metebalci/muir-fpga/README.md

# muir-fpga

This is the MIT CADR on an FPGA, at **rtl level**. Its processor's microcycles
and the machine's clocks run at the original machine's speed to within about
5%.

[muir-sim](https://github.com/metebalci/muir-sim) simulates the CADR at three
fidelities. `rtl` is the middle one. It has the machine's own two-phase clock,
every datapath signal on it, and everything that is a matter of *when*. That
means bus waits and hangs, arbitration, and timeouts. This repository is that
machine in fabric, with a normal microcycle of 15 clock ticks.

**That speed is a statement about parts, not about the whole machine.** A
normal microcycle takes 150 nanoseconds where MIT's drawings say 145, and every
microcycle is within 4% of the drawings. The microsecond clock and the display
frame keep MIT's exact periods. Main memory is DDR3, which answers in its own
time rather than on the memory board's clock. The disk carries the Trident
T-300's timing and does not charge it on the board, so a disk operation ends
when its words have moved. No whole program has been timed against a real CADR.

The table sets the original machine's figures beside this machine's on the Arty
Z7-20. A figure for the original that no source gives is marked as not in the
recovered material. Each figure for this machine says whether it was measured
on the board or is what the fabric is built to do.

| | The CADR | This machine, on the Arty Z7-20 |
|---|---|---|
| Microcycle, fast speed | 135 ns [1] | 140 ns, by design [11] |
| Microcycle, normal speed | 145 ns [1] | 150 ns, by design [11] |
| Microcycle, slow speed | 160 ns [1] | 160 ns, by design [11] |
| Microcycle, extra slow speed | 220 ns [1] | 220 ns, by design [11] |
| Microcycles a real second, stalls included | not in the recovered material | 5.876 million, measured, 88.1% of what a normal microcycle allows [12] |
| Microsecond clock | 1,000 ns, from a 32 MHz crystal [2] | 100 ticks; measured at 0.99995 and 1.00001 of real time [12] |
| Display frame | 15,456,000 ns, 64.7 Hz, from the PROM's sync program [3]; 16,528,000 ns, 60.5 Hz, from `CPT-SYNC2`, which every boot loads | the same periods from the same sync programs, by design [11]; 60.503 Hz measured with a band running (`docs/tv.md`) |
| Xbus setup before `-XBUS.RQ` | 80 ns [4] | 80 ns, by design [11] |
| Read deskew | 60 ns [4] | 60 ns, by design [11] |
| Main memory, `-XBUS.RQ` to the acknowledgment | about 460 to 500 ns on the memory board's 24 MHz clock, longer during a refresh [5] | the DDR3 round trip through the processing system's `S_AXI_HP0`; not measured on the board. In simulation the checks answer at muir's memory board instant [13] |
| Disk rotation | 3,600 rpm, 16.7 ms; average latency 8.3 ms [6] | 16,666,667 ns in the model; not charged on the board [14] |
| Disk sector | 1,164 bytes [7], 963 us at the transfer rate below | 968,448 ns in the model, at 104 ns a bit; not charged on the board [14] |
| Disk seek | 6 ms to the next cylinder, 30 ms on average, 55 ms at most [6] | 5,939,729 ns plus 60,271 ns a cylinder in the model: 6 ms, about 22 ms on average, 55 ms at most; not charged on the board [14] |
| Disk transfer | 1,209 KByte/s [6] | a block moves once Linux has read it from the pack file; a cold load measured about 64,500 blocks in about 58 s, about the same as at half speed [12] |
| Disk hang timer | 2.56 s [8] | 2.56 s, by design [14] |
| Chaosnet cable | 4 MHz [9] | no cable: a frame crosses to Linux whole and travels as a UDP datagram over gigabit Ethernet; not measured [15] |
| Serial line | 50 to 19,200 baud, from a 5.0688 MHz crystal [10] | the same rates in real time, by design; 300 baud measured whole at 30.0 characters a second, and 9600 baud whole with a store of 1,024 characters [16] |

Sources for the CADR:

1. muir `src/clock.rs`, `Speed`: the 74S151 at CLOCK1 1D08 selects the read
   tap, and a microcycle is that tap plus 60 ns of restart
   (`mit/cadr/clock1.drw`).
2. muir `src/chip.rs`, `CHAOS_CRYSTAL_PERIOD`, and `src/ioboard.rs`,
   `FIRST_USEC_EDGE_NS`: `1 USEC CLK` is counted down from the 32 MHz crystal
   at LMTCLK 0A05 (`mit/chaos/lispm/lmtclk.drw`, `mit/cadrio/clktim.drw`).
3. muir `src/tv.rs`, `FRAME_NS`: 966 lines of 16.000 us in clock mode 0, from
   MIT's sync program `mit/cadrtv/cpt.prom`, measured on muir's netlist of the
   SIMPLE TV.
4. `mit/cadr1/xspec.text.3`, the Xbus specification: "80 ns. prior to
   asserting -XBUS.RQ". muir `src/busint.rs`, `XBUS_ACK_NS`: the 60 ns tap of
   the TD100 at REQLM 0C09.
5. muir `src/busint.rs`, `MemoryBoard` and `MEMORY_CYCLE_STAGES`, and
   `tests/cadrm_netlist.rs`: a request is taken at the first edge of the
   board's 24 MHz crystal after `-XBUS.RQ` and acknowledged eleven stages of
   41.7 ns later. A refresh cycle about every 12 us, MIT's note on
   `mit/cadrm/memctl.drw`, holds the board for about 455 ns. These figures
   come from muir's netlist of MIT's memory board, whose crystal ECO 1 in
   `mit/cadrm/mem.eco` added, and not from hardware.
6. CalComp/Century Data 76205-902, *Performance Specification, Models T-25,
   T-50, T-80, T-200 and T-300*, November 1980, Table 2-1, as quoted in muir
   `src/disk_unit.rs` at `REVOLUTION_NS`, `BIT_NS` and `Trident`.
7. `mit/cadrdc/dctrid.drw`: "Set sector length jumpers in drive to 1410
   (octal) which is 1164. bytes". System 100 `sys/doc/disk.text`: "one every
   1164. bytes".
8. muir `src/disk_controller.rs`, `TIMEOUT_NS`: the 74LS124 at DCTMOT 0B04 at
   20 ms, divided by 128 by the 74393 at DCTMOT 0C03. System 100
   `sys/doc/disk.text`: "longer than 2.5 seconds".
9. `mit/cadrio/iob.eco`, ECO #5 of 8/3/80: "Change cable speed to 4 MHz".
10. muir `src/serial.rs`, `DIVISORS` and `BRCLK_HZ`: Table 1 of the Signetics
    2651 data sheet, for the crystal at IOBSER 0A15.

Sources for this machine:

11. `docs/timing.md`, which gives every instant in ticks and its source.
12. `docs/board.md`, "The 10 ns grid on the board, 17 September".
13. `rtl/plumbing/cadr_xbus_ddr.sv`: the bridge adds no ticks of its own, and
    the answer comes when the AXI port returns it. `tb/cadr_machine_tb.cpp`
    answers each memory cycle at muir's acknowledgment instant, which includes
    the memory board's clock.
14. `rtl/machine/cadr_disk_controller.sv`: the drive's time is charged only
    when `cadr-disk-packs` runs with `--timed`. The board's init script does not
    pass it, and muir leaves it off by default too.
15. `rtl/plumbing/cadr_chaos_cable.sv` and `docs/chaosnet.md`.
16. `docs/board.md`, "A placement fault fixed, and the serial store, 17
    September".

**The timing of the clock edges is close to the CADR's but not identical.**
The CADR placed its clock edges with tapped delay lines, at instants its
drawings give in nanoseconds. The FPGA clocks everything from one 10
nanosecond clock, so an edge can only fall on a tick. Each instant goes to the
first tick at or after where the drawings put it. Eleven instants move later,
eight of them by 5 nanoseconds and three by 7, and none moves earlier.

What the machine computes does not change, because every instant keeps its
order. Free-running oscillators keep their exact period, so the microsecond
clock keeps real time and the display's frame is exact. muir's
`--timing-model fpga` applies the same rounding. So the fabric is held tick for
tick to muir under that model, and not to the original hardware's exact
nanoseconds.

The grid was 5 nanoseconds before, which kept every instant exact, but the
clock was 10 nanoseconds then too, so the machine ran at about half speed. The
clock is not 5 nanoseconds because the design does not meet its timing at 5.
`docs/timing.md` lists every instant, where it came from, and what depends on
it.

muir's netlists are read to **derive** things. They give the port list's
directions, the address decode's boundaries, and every constant that came off
a drawing. But nothing here is a netlist. Whether a gate-level implementation
ever follows is an open question. It is not a promise this repository makes.

This is separate from muir because the toolchain is separate. muir stays the
reference, and everything here is checked against it. `muir.commit` names the
commit of muir the traces were generated against, and `make muir-pin` says
whether the muir beside you is that one.

## Where the machine ends and the board begins

The CADR is one machine, and it is the whole point. Everything else is what it
takes to run that machine on a particular part. The source tree draws that line
explicitly, and it draws it where the checks already drew it.

    rtl/machine/            muir is the reference, tick for tick
    rtl/plumbing/           held to a protocol or a property
    rtl/plumbing/xilinx7/   the vendor's primitives and constraint syntax
    boards/arty-z7-20/      pins, the processing system, the operating system

Every file in `rtl/machine/` has a muir type it is compared against, over a
trace, cycle for cycle. Every file in `rtl/plumbing/` says in its own header
that no muir reference exists for it, because it is held to a bus protocol or
to a property instead. The AXI master is the clearest case. Nothing in muir
corresponds to it, so it is held to the protocol and to read-back and to
nothing else.

The vendor-specific pieces are in the plumbing rather than in the machine. The
scan primitive the debug probe uses and the syntax of the two constraint files
are Xilinx's, and keeping them out of `rtl/machine/` is what keeps the promise
that the machine is plain SystemVerilog.

**Another Zynq board is a small thing.** It needs a top level, a pin file, a
processing-system configuration and a device tree. That is one directory under
`boards/`, and nothing in `rtl/` changes.

**A part with no processing system is not a port but a second set of
plumbing.** Another seven-series part carries the machine and even the clock
and scan primitives over unchanged. What does not carry over is everything the
processing system does today: main memory, Linux, and therefore the disk pack
program, the console's path and the display's. Each of those needs a fabric
answer instead. Nearly all of that work lands in `rtl/plumbing/`, where it is
reusable, and the board directory stays thin. The disk controller would ask for
a block exactly as it does now and would not care who answered.

**An Arty A7-100 directory was here and was removed.** It held that board's top
level, its pin file, a generated DDR3L controller, lowRISC's Ibex as a soft
processor in a vendored directory that went with it, and the bare-metal
firmware that drove the same register faces Linux drives on a Zynq board. It was taken out because that board
carries a microSD card only as a module bolted onto a Pmod header, its Ethernet
is 10/100 where the Zynq boards are gigabit, and it has no video connector, so
the screen had nowhere to go. None of that made it worth carrying beside the
Zynq boards. `c789d19` is the last commit that has it, and `boards/README.md`
still lists what a part with no processing system would have to answer, so the
question can be re-opened from there.

The Digilent Cora Z7-07S was supported up to commit `653e5759` and is no longer.

**It is one repository and not one per family, deliberately.** The value here
is the CADR held to muir. Two repositories would mean two copies of the machine
drifting apart, with the checks duplicated and rotting in whichever copy nobody
was looking at.

## The board this runs on today

The board is the Digilent **Arty Z7-20**, `XC7Z020-1CLG400C`. It has 53,200
LUTs, 106,400 flip-flops, 630 KB of block RAM, a dual Cortex-A9 at 650 MHz,
512 MB of PS DDR3, gigabit Ethernet and microSD.

**Fabric holds anything with a clock edge the CADR can see. Linux holds
anything with a protocol, a file, or a name in it.** So the boards, the Xbus,
the Trident bus timing and the Chaosnet cable are in fabric. The RFB server,
the packs on microSD, Chaosnet routing and the console are on the processing
system. Main memory is the only seam that runs at machine speed, and it is the
one with no software in it.

Five of the Zynq's nine ports cross the boundary today. The fifth is the
display's own output.

`S_AXI_HP0` is the memory bridge's, and it is the one at machine speed.

`S_AXI_HP2` is the disk's. A Trident turns 60 times a second with 17 blocks to
the track, which is 1,020 blocks a second of 256 words each. A streaming pack
is therefore 261,120 words a second, just over a megabyte. Bandwidth was never
the point. The point is that on a port the processing system masters, those are
261,120 stalled CPU stores a second, against a 968 us deadline for each block.
So fabric fetches the block out of DDR itself, at the block's address Linux
writes, and no CPU is in the per-word path. The disk gets a port of its own
rather than a share of `HP0`, so that disk traffic adds no arbitration to the
memory path. It is the third port rather than the second because `HP0` and
`HP1` share one port on the DDR controller, and `HP2` and `HP3` share the
other. A disk on `HP1` would have met the machine at that shared port, which is
the thing a separate port was for.

`M_AXI_GP0` carries the disk's registers, the Chaosnet buffers and the block's
address, behind `rtl/plumbing/cadr_gp0_split.sv`. `M_AXI_GP1` carries the
console and the debug cable's carrier, behind `rtl/plumbing/cadr_gp1_split.sv`.
The console keeps `0x8000_0000` and the cable's sixteen words sit at
`0x8000_1000`, which is the address muir is given as
`--debug-cable-connect 0x80001000`.

Each splitter has a port for everything neither face claims, and that is the
rule the arrangement exists for. A read on a general-purpose port that nothing
in the fabric answers does not fault the Arm. It hangs both cores at one
program counter each, and no software guard can catch it. So the fabric that
owns a port answers every address on it, and each splitter's check reads all
262,144 pages of its port back.

The Zynq-7000's PS-PL ports are **AXI3** and the logic here is AXI4, but no
protocol converter is needed. The `PS7` primitive takes `AWLEN[3:0]`,
`AWSIZE[1:0]`, `AxLOCK[1:0]`, six-bit IDs and a `WID`, so a single-beat AXI4
master reaches it through a handful of wires.

## The processor's boundary

`data/cables.txt` in muir holds the 92 wires on the five flat cables between
the processor and the bus interface, pin for pin off MIT's wire lists. That is
the machine's own boundary, so it is the module's ports.

The cables are named by both ends, because the processor end alone is
ambiguous. `1AJ1` is the CADR board's connector **and** the ICMEM board's. The
five are `1AJ1-J11` (20 wires), `1AJ1-J08` (12, the ICMEM board's), `1BJ1-J12`
(20), `1CJ1-J09` (20) and `3AJ1-J07` (20).

Of the 92, 15 are inputs and 29 are outputs. The other 48 are exactly
`MEM<31:0>` and `SPY<15:0>`, and they are driven from both ends. Fabric has no
bus to fight over, so those are carried as a value and an enable out, with the
resolved wire back in.

Net names are mangled to legal identifiers. A leading `-` becomes `n_`. A `.`,
a space, a `/` and a `>` each become `_`. A leading digit takes an `x`. A
collision is an error. `rtl/machine/cadr_cables.map` holds every identifier
against the name MIT wrote.

## The debug cable

> ## ⚠ DO NOT JOIN THE TWO BOARDS' POWER
>
> **A straight ribbon between two headers joins their supplies as well as
> their signals, and two boards' regulators tied together is not something
> either of them is built for. It can damage both.**
>
> **The grounds must be joined. The supplies must never be.** On a Pmod
> header that means leaving pins 6 and 12 open at *both* ends, joining only
> the grounds on pins 5 and 11. On the DE25-Nano's JP1 it means leaving pin
> 11, which is 5 V, and pin 29, which is 3.3 V, open at both ends, and
> joining only the ground on pin 30.
>
> A manufactured ribbon does not do this for you. Check the cable against the
> header's own pin list before either board is powered, and check both ends:
> a cable that is right at one end and wrong at the other is still wrong.
> `docs/debug-cable.md` gives the full pin list for each board.

This is the other cable in the machine, and the one that makes two of them. A
CADR debugs a CADR. The debugger's `DBGOUT` connector goes to the debuggee's
`DBGIN`, over the 21 wires of `data/busint-connectors.txt`. Through them the
debugger reaches four registers on the debuggee's Unibus: `766100` cycle,
`766104` status, `766110` modifier and `766114` address. Those are the strobes
the 74S139 at DBGIN 0A15 makes of `DEBUG IN A<1:0>`.

Four wires go out (`-DEBUG OUT REQ`, `DEBUG OUT A<1:0>`, `DEBUG OUT WR`) and
one comes back (`DEBUG IN ACK`). `DBD<15:0>` goes both ways. It is one bus on
each board with both connectors on it, and its direction follows `WR`. So 21
wires are 20 signals out and 19 back. They are carried the way the processor
cables carry their 48 both-ends wires, as a value and an enable out with the
resolved wire back in. The two octal Am8304s at DBGOUT 0B21 and 0B22 drive
`DBD` together. They share one enable and one direction, `-DBD ENB` on pin 9
and `-DEBUG > UD` on pin 11, so there is one enable for the whole bus rather
than one a byte.

What crosses is levels rather than pulses. The wires are held for the whole
request, as the debugger's own Unibus cycle holds them. Two figures constrain
anything that carries them. The data, the address bits and the write flag are
on the cable **100 ns before** the request, because the request is `NAND(SELECT
DEBUG, SELECT DEBUG DLYD)` at DBGOUT 0A11. So a carrier must sample every wire
at one instant and replay it at one instant, or that ordering inverts. And the
debug block's timeout is **11.05 us**, thirteen intervals of the 74LS124 at
REQTIM 0A01 off the REQTIM PROM's second table, rather than the Xbus's 4.25 us.

That budget is microseconds, so a carrier's delay need only be constant rather
than small.

**The debugger is muir, on the processing system.** It holds the cable's levels
as registers. It drives `DBGIN` as machine A's `DBGOUT` page would, or as the
PDP-11 once did, with the phase generator held at a microcycle boundary while
muir computes its side. Machine-time stays exact and only wall-clock stretches.
muir already runs the lashup, so the debugger is software that works before the
fabric it is pointed at does.

Both ends are built. `rtl/machine/cadr_dbgin.sv` is MIT's DBGIN page inside
`cadr_machine`, and `rtl/plumbing/cadr_debug_window.sv` is the carrier that
puts the twenty-one wires on `M_AXI_GP1` as sixteen words. muir reaches them
with ordinary loads and stores through `/dev/mem`. `docs/debug-cable.md` is
the whole of it.

A second board is the same cable on one Pmod connector, JA on both boards.
The connector carries the whole link in both directions: four pins each way, of
which two carry a strobe and one data line and the other two are driven low as
guards beside them, twenty-four beats a frame. A board is a debugger or a
debuggee by configuration and never both at once, which is what makes one
connector enough; a second one bought only a chain of three machines. The other
Pmod is not assigned. The cable's 11.05 us budget makes the beats free.

Both Zynq boards carry the connector, in every configuration, because a board
is always a debuggee. A board becomes the debugger by `--debug-cable-connect`
in `fpgarc` or by `cadr-console debug-cable-connect`. Two boards joined by the
cable have each debugged the other over it: CC in one board's Lisp world has halted the machine in the other and read its registers
and scratchpads, equal to that board's own console and readout.

**The console is not this, and the difference is worth keeping.** It masters
the machine's own Unibus to reach the diagnostic registers. No CADR had that
path, where the debugger was another machine's `DBGOUT` page or a PDP-11
playing it. So the console exercises nothing of the machine, and that is
exactly its use. It works when the debug block does not, which is when it is
wanted. muir through the real debug block does test that block. **A check may
reach the machine through the debug cable and never through the console.**
Otherwise it would be holding the fabric to a path the hardware never had.

## Memory in DDR

Memory is shared with the Linux side. It is settled in
`rtl/plumbing/cadr_ddr_map.sv` and **reserved at what the machine can reach,
and no more**: 17.125 MB of a Zynq board's 512 MB, and Linux keeps the rest.

| base | reserved | used | |
|---|---|---|---|
| `0x1B00_0000` | 16 MB, 4M words | 15 MB, 3,932,160 words | main memory |
| `0x1C00_0000` | 1 MB | 128 KB, 32,768 words | display |
| `0x1C02_0000` | in the 1 MB above | 128 KB, 32,768 words | second display |
| `0x1C10_0000` | 128 KB | 128 KB | the disk pack program's records |

The other boards have the same layout at their own base: `0xB300_0000` on the
DE25-Nano and `0x6300_0000` on the Kria KR260.

QUUX has its own device trees and loader, and its own region:
main memory as 32M words of packed storage from `0x1200_0000`, then the display
and the records, ending where the CADR's region ends. Linux keeps 350.9 MB
beside it (`docs/linux.md`).

DDR was never the limit. The CADR's physical address is 22 bits, a 14-bit page
frame out of the map with `VMA<7:0>` as the offset, so main memory's 16 MB
holds every address the machine can make, and 3,932,160 words is the
ceiling. The top four of the 64 slots are taken by the display, the disk
controller and the Unibus.

The display's 1 MB holds both display boards' frame buffers: the first at its
base and the second, the color TV's, 128 KB above it, which is the first
board's own size. A machine carries the second board only when the card asks
for it. The CADR's own screen is 768 x 963 at one bit and the color TV's
576 x 454 at four bits a pixel --- four is the only depth that board has
here, a pixel being an address into sixteen colors of three eight-bit
channels. The Linux side serves a 1080p canvas over RFB and composites the
machine's screen into it.

## Building

This needs [Verilator](https://verilator.org), a Rust toolchain, and muir
checked out beside this repository. Nothing here vendors a copy of muir's
netlists or part tables.

    make check

### Vivado on Ubuntu 26.04

Vivado 2026.1 does not list Ubuntu 26.04 as a supported operating system. It
runs here anyway, and this section says what that takes. It should go away
when the release notes catch up.

The problem is the prerequisite libraries rather than the tool, and it comes
in two halves. Some package names have changed, and two libraries are gone
from the distribution altogether.

**The names first.** AMD ships a script named `installLibs.sh` beside the
installer, and its Ubuntu branch asks for `libtinfo5`, `libncurses5`,
`libncurses5-dev`, `libgdk-pixbuf2.0-dev` and `libasound2`. The same list with
the current names works:

    sudo apt-get install libc6-dev-i386 net-tools graphviz make unzip \
        zip g++ libtinfo6 xvfb git libtool libyaml-dev libncurses6 \
        libncurses-dev libnss3-dev libgdk-pixbuf2.0-bin libgtk-3-dev \
        libxss-dev libasound2-dev openssl fdisk libsecret-1-dev

**The script cannot tell you any of this.** Each library is a separate
`apt-get` command piped into `tee`, and the script sets no error handling, so
a package that does not exist prints a message and the run carries on. It
reaches the end and reports success with the libraries missing.

**The second half is the one that needs a workaround.** Vivado loads
`libncurses.so.5` and `libtinfo.so.5` at run time, and 26.04 ships neither and
offers no compatibility package for them. Installing the version 6 packages is
not enough, because the tool asks for the old file names. Without them Vivado
does not start, and the message names the file:

    application-specific initialization failed: couldn't load file
    "libxv_commontasks.so": libncurses.so.5: cannot open shared object file

The fix is a directory of symlinks under the old names, pointing at the
installed version 6 libraries, placed on the library search path:

    mkdir -p ~/lib5
    cd /usr/lib/x86_64-linux-gnu
    ln -s $PWD/libncurses.so.6  ~/lib5/libncurses.so.5
    ln -s $PWD/libncursesw.so.6 ~/lib5/libncursesw.so.5
    ln -s $PWD/libtinfo.so.6    ~/lib5/libtinfo.so.5

Then add `~/lib5` to `LD_LIBRARY_PATH` in your shell's start-up file, after
sourcing Vivado's own `settings64.sh`. Guard the addition so that re-sourcing
the file does not lengthen the path. Undoing all of it is deleting the
directory and the two lines.

Nothing about the tool is patched and it is not told a different operating
system is underneath it. The libraries are the real ones under their previous
names, in one directory outside any system path, visible only to shells that
opt in.

The installer's graphical mode also wants `x11-apps`. The JTAG cable needs the
udev rules copied out of the install, which `docs/board.md` covers, and
without them the hardware server connects and offers no targets.

Synthesis, place and route, and bitstream generation all run on this, and the
most recent build of this repository's own design finished with no critical
warnings.

`docs/fits.md` gives each board's fits: their setup and hold slack, the logic
and block memory they take, and the commit each was built from.

## Layout

    rtl/machine/           the CADR, held to muir tick for tick
    rtl/plumbing/          held to a protocol or a property; no muir reference
    rtl/plumbing/xilinx7/  family primitives and constraints, not the machine
    boards/arty-z7-20/     pins, the processing system, the operating system
    tb/                    Verilator testbenches
    golden/                Rust, depends on muir by path; writes the traces
    mutations/             the mutation list, and the runner that applies it;
                           docs/mutations.md says what it is and why
    docs/                  one document a block, and the board bring-up
    build/                 generated, not committed

## How it was written

This project is written with [Claude Code](https://claude.com/claude-code),
using Anthropic's Claude Opus, Claude Fable and Claude Sonnet.
