metebalci/muir-fpga/docs/chaosnet.md

<!--
SPDX-FileCopyrightText: 2026 Mete Balci
SPDX-License-Identifier: AGPL-3.0-or-later
-->

# The Chaosnet, and the serial line beside it

Both are on the CADR's I/O board, and both are split between fabric and Linux.
This document covers the whole of each, because the two halves were built by
separate slices and neither is a thing on its own.

The fabric half is in `rtl/machine/cadr_io_board.sv`, held to muir's `ioboard`
model over a scripted trace. The Linux half is two Buildroot packages,
`cadr-chaosnet` and `cadr-serial`, ported from muir's `src/chaos/` and
`src/serial.rs`.

## Where the line between them falls

**Fabric holds anything with a clock edge the CADR can see. Linux holds
anything with a protocol, a file, or a name in it.** That is this project's
rule and it decides everything here.

So the fabric has the registers the machine reads and writes: the Chaosnet
interface's five registers from AIM-628 section 7, its two packet buffers of
256 words each, its two 9401s, the one at LMTBUF 0C09 that makes the check
word and the one at LMRBUF 0C07 that checks the read-out, its bit counter and
its lost count, and the serial port's four 2651 registers with their mode
pointer and status byte. Nothing above that is in fabric.

Linux has the rest: the cable, the receiver's verdict on a frame, routing,
the turn timer, the baud-rate generator and the line. What crosses the
boundary is a frame and a status register, and nothing more.

**Nothing on either side of that boundary answers a service.** A CADR has no
file or time server in it. The section on `ED-FILE` below says where that
server is instead.

## What the machine sees

`0o764140` to `0o764156` is the Chaosnet interface and `0o764160` to
`0o764176` is the serial port. Both are answered in full. The card's own check
prints `NOTHING IS EXEMPT`, and it answers 55 directions where it answered 28
before these two landed.

The Chaosnet's decode is subtle and the subtlety is MIT's. The 74LS138 at
LMUCON 0C18 decodes two address bits **and read against write**, so one
address is a different register depending on direction. Address bit 3 is
decoded only twice: it makes a read of `0o764152` the address START rather
than MY ADDRESS, and it disables the receive buffer's read at `0o764154`,
which is then unanswered. Writes reach the CSR and the transmit buffer at
`0o764150` and `0o764152` exactly as at `0o764140` and `0o764142`.

The serial port is simpler. Address bit 3 is not decoded at all, so
`0o764170` to `0o764176` are aliases of `0o764160` to `0o764166`, and every
address of the group is answered in both directions.

The interrupt vectors are `0o274` for the clock, `0o270` for the Chaosnet,
`0o264` for the serial port and the keyboard and mouse last. MIT's priority is
clock over Chaosnet over serial over keyboard. `0o270` is compared against
muir for the first time now, because the trace plugs a Chaosnet interface in
and uses Loop Back as the far end, which no trace against this model could do
before.

## QUUX

QUUX has no I/O board and no Chaosnet interface (QUUX's Ethernet contract,
section 8 R4). Its network is the Ethernet device (`docs/ethernet-device.md`).
The register page's words 140 to 157 are reserved and are never reused: each
reads 0 and takes no write, as the page's other reserved words do. Word 100's
bit 6 is never set, and the core has no Chaosnet cable seam. `quux15_network`
holds it clock for clock against muir: every word of 140 to 157 is read, then
written as an interface would act on them with interrupts enabled, and
condition 5 never calls its handler.

## An empty START takes Transmit Done down

A read of START with no word written since the last frame or a Reset still
sends a frame, the source and its check word. On MIT's board the read raises
TRESET (the 74S00s at LMTBFC 0C15, while TDONE is up), which clears TDONE (the
74S74 at LMMODU 0D08). So Transmit Done falls at the read and rises 500 ns
before the empty frame's nominal end, as every frame's does. muir does the
same, held to the netlist board. The CADR's card takes Transmit Done down at
START, and the far end's `chaos_tx_done` raises it again. After a word was written, Transmit Done is already down and
the read changes nothing. MIT's microcode and Lisp write at least one word
before every START, so no system run sees the difference.

**On a board the far end does not send the empty frame, and this is a known
difference.** `cadr_chaos_cable.sv` answers a frame of three words or fewer,
the empty frame's source and check word among them, by giving
`chaos_tx_done` back the next clock, and nothing goes on the cable. No
receiver lands a run of 48 bits or fewer (below), and CHUDP has no datagram
for a frame of fewer than eleven words. Nor does the board's own busy receiver
count or abort such a run: its own frame of 48 bits into a full buffer, to its
own address, to zero or under Spy, leaves Lost Count and Transmit Abort where
they were, on the netlist board and in muir alike. For one and two words the
rule also keeps `cadr-chaosnet` from reading below a frame: it routes by the
third word from the end, and the card makes frames of one and two words from
255 and 256 words written. The program drops such a frame itself as well, if
one is ever offered. muir and MIT's board send the
33-cell frame and raise Transmit Done about 8 µs later. MIT's software never
reads START with nothing written.

## The shift register holds the transmit buffer's writes

Every word written into the outgoing buffer, and at START the source and check
words, reaches the buffer through the transmitter's shift register. On MIT's
board the register loads at the first edge of the board's 8 MHz `FCLK` at
least 101 ns after the cycle's answer, and shifts one word in over 2,000 ns. A
WRITE BUFFER or a START that comes while it is busy waits on `-TSR.SSYN`, and
is answered 350 ns after `TSREMPTY` rises rather than 350 ns after `-MSYN`.
muir measures this on the netlist board and models it
(`IoBoardTiming::answer_cycle`), and the CADR's card does the same. MIT's
microcode writes the second half of every 32-bit word, and START, sooner than
the register takes them, so on a board each of those cycles is held.

Only the card's own Unibus cycles load the register and wait on it. Revisions
13 and 14 reach the interface through QUUX's register page, which is no
Unibus cycle, and muir holds nothing there either. A Reset, a Clear
Transmitter and `-UB INIT` leave the register as it stands, as muir's model
does. Whether they empty it on the board is not measured.

`iob` holds the hold. Its program answers a word at each of the 25 grid
phases of two periods of `FCLK`, with a second word right behind it, so that
the second word's answer names the edge the register loaded on. It sweeps a
word across the instant the register empties, and puts a START behind a word
and a word behind a START. With the earlier sections, 370 of the program's
answers are held, and 338 of them fall 5 ns short of a tick, because
`TSREMPTY` is an `FCLK` edge and every second edge is off the 10 ns grid.

On the CADR, the same register also says when a
frame is ready for its turn: at `TSREMPTY` after START, 4,101 to 4,225 ns
after the answer by the clock's phase, where muir used a fixed 4,150 ns. The
turn timer is the far end's, and the fabric keeps no such instant: Transmit
Done rises at the far end's `chaos_tx_done`, which the checks play from
muir's instants (the `iob` trace's `CTD` rows, and the `# chaos-txdone` lines
of the machine traces on the CADR). So no check of the fabric can tell this rule from the fixed delay, and none is meant to. On a
board Transmit Done comes back when `cadr-chaosnet` takes the frame off
`cadr_chaos_cable.sv`, on no turn timer.

## The interface takes its own frame when it is for it

MIT's board takes its own frame off the cable when it is for it. Its
transceiver hears the whole cable, its own transmission included, and its
receiver judges that frame by `DEST MATCH` as it judges any other. A frame to
the board's own address, to zero, or to anyone under Spy lands in a free
buffer. With the buffer full the frame is counted in Lost Count, and one to
the board's own address is aborted by the board's own busy receiver and reads
back as Transmit Abort. muir measures the cases on the netlist board and does
the same, on every revision.

In the fabric that is the cable's, and the cable is the far end. The CADR's
card takes its own frame through the seam as it takes any other: its words on `chaos_rx_*`, the count on
`chaos_rx_lost`, and the abort on `chaos_tx_done` with `chaos_tx_abort`. A
frame looped back into a full buffer is aborted as its destination word goes
by, 125 ns before Transmit Done (muir's `busy_looped`), so the far end can
also give the abort with the count, ahead of the done. Frames of any length are started, the next section says what becomes of
one written past the buffer's end.
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
