metebalci/muir-fpga/docs/ethernet-device.md

<!--
SPDX-FileCopyrightText: 2026 Mete Balci
SPDX-License-Identifier: AGPL-3.0-or-later
-->
# QUUX's Ethernet device

QUUX revision 16 adds an Ethernet device to the register page, at words 240
to 257, with its interrupt at word 100 `<8>` and its feature bit at word 15
`<2>`. QUUX moves Ethernet frames through two rings in its main memory: a
transmit ring of frames to send, and a receive ring of buffers to fill. The
device understands IPv4. It fills in the IPv4 header checksum and the TCP, UDP
and ICMP checksums of every frame it sends, checks them on every frame it
receives, and takes only IPv4 and ARP. muir's `src/ethernet_device.rs` and
`src/ethernet_offload.rs` define the machine's side: what each register reads,
what each write does, the rings, and what is done to a frame's bytes.

On a board the registers are in the fabric, and the device's other half is a
Linux program, `quux-ethernet-device`. It sends each frame the transmit ring
names to a tap on the board's Linux, `quux0`, and delivers each frame the tap
gives into the receive ring. This page describes the program and the fabric's
page it reaches.

The device is QUUX revision 16's alone. A CADR bitstream and older QUUX
revisions have no page for it, and the default slave answers its address.

## What QUUX reaches on a board

QUUX's address decides what `quux0` is, by one rule:

- **An address in 169.254.x.y makes a host-only tap.** The board's side
  has the address `--ip-gateway` names, on `--ip-address`'s subnet. Nothing is
  forwarded and no ARP is answered for QUUX on the board's network, so QUUX
  reaches the board's Linux alone and nothing on the network reaches QUUX.
  muir's defaults are link-local, so a card that names no address is
  host-only.
- **Any other address makes a LAN tap.** QUUX is then a computer on the
  board's LAN, with its own address on the LAN's subnet and the LAN's router
  as its gateway. The board's Linux answers ARP on its LAN interface for
  QUUX's address and no other, and forwards between the LAN interface and
  `quux0`.
- **A card that mixes the two is refused** before anything is touched: a
  link-local `--ip-address` with a gateway that is not link-local, or the
  reverse. So the board never holds the LAN router's address.

Link-local is the line because a router must not forward a packet with a
link-local source or destination address (RFC 3927, section 2.7). A link-local
QUUX cannot be on the LAN by forwarding, and a QUUX on the LAN is never
link-local. The rule reads QUUX's own flags only and adds no flag.

In either mode QUUX's MAC address stays on `quux0`: on a LAN tap the board
answers ARP on the LAN with its own MAC address. The board forwards no
broadcast from the LAN to QUUX.
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
