metebalci/muir-fpga/tb/cadr_machine_tb.cpp

// SPDX-FileCopyrightText: 2026 Mete Balci
// SPDX-License-Identifier: AGPL-3.0-or-later
//
// Drives rtl/machine/cadr_machine.sv --- the processor and the memory path joined by
// the cables --- from muir's own trace, and compares every microcycle.  The trace is written by golden/src/rtl.rs out of muir's `rtl`
// engine running MIT's boot PROM: a real program, not a scripted stimulus.
//
// One row is one microcycle.  The DUT runs on its own 200 MHz clock and says
// when a microcycle ended, on `clock_edge`; the values compared are the ones
// standing *before* that edge, which is the read phase the row describes ---
// `Rtl::signals` is "recorded in the read phase, where the sources drive and
// the ALU result is up but nothing has been written back".
//
// WHAT IS STIMULUS.  There is no map yet, so what comes out of the trace
// rather than out of the DUT is `md` and `vma`, `vmaok` off the map's
// permission bits, the word a SRCMAP puts on MF, the
// dispatch memory's word, and the console's registers.  The bus interface is
// here too, as its far end: this testbench answers -MEMRQ with -MEMGRANT and
// -MEMACK at the instants muir's own interface answered them.
// `rtl/machine/cadr_busint_xbus.sv` is the real thing and has a check of its own.  Every one leaves with
// a later slice.  They are counted and printed, so what this check is still
// being told rather than checking is on its own output.
//
// **AND ONE OF THEM HAS LEFT.**  The Xbus devices used to be answered from
// the trace --- 16,951 cycles of this program's 17,466, the disk controller's
// four registers being all it touches --- and `rtl/machine/cadr_disk_controller.sv`
// answers them now, with `device_ack` driven low here and never raised.  So
// `md` on 11,301 of those rows is the fabric's own status word and the trace
// is the reference for it rather than the source of it.  That is what a slice
// landing looks like from this side: a drive line deleted, not commented out.
//
// **AND SO HAS `sintr`.**  -XBUS.INTR is made inside `cadr_machine` now ---
// the disk controller's request ORed with the display's vertical interrupt,
// one gate before the 74S175 at LCC 3E12 --- and comes back out as
// `sintr_o`.  The trace's `sintr` column is `Machine::xbus_interrupt()`, the
// same OR, and it is COMPARED here rather than driven.  Same slice, same
// shape: the line that drove it is deleted.
//
// `mf_map` is the one that is frankly circular: a SRCMAP is reached **once**
// in 600,000 microcycles and its word is taken from the trace's own M column,
// so on that single row M checks nothing.  One row is not a check of a map
// under any amount of cleverness, and the map is a later slice; the count is
// printed so the circularity is visible rather than buried.
//
// WHAT IS CHECKED.  PC, IR, LPC, OPC, ST, the A and M buses, the ALU, R, OB,
// Q, DC, LC, JCOND, and the four sequencing flags NOP, PCS1, PCS0 and
// IWRITED --- plus the length of every microcycle in 200 MHz ticks.  PC goes
// through the fabric's own stack on a POPJ.
//
// **The stall is no longer subtracted.**  VCTL1 decides -WAIT and -HANG for
// itself now, so the whole interval between one microcycle boundary and the
// next is the fabric's own answer: 6,912 waits and 11,404 hangs over the run,
// 2,198,700 ns of held clock, and every one of them has to land where muir
// lands it.  That is the strongest single column in this check.
//
// WHAT THE CHECKED SIGNALS ARE WORTH, measured by mutation rather than
// assumed.  The A bus is the strong one: 96,192 distinct values over the run,
// and it catches a wrong write address, wrong write data, and the ACTL
// pass-around inverted or removed.  RETA's mux, WPC and the stack's push
// pass-around are each caught through PC on the 16,384 POPJs.  Against that:
//
//   - LC is **zero on every one of the 600,000 rows**.  The boot PROM never
//     runs macrocode, so the location counter never moves and its check is
//     vacuous.  Asserted below, so a trace that does move it re-opens this.
//   - The stack's RAM and pointer are **never read**.  Every push here is
//     popped by the very next microcycle, which takes SPCWPASS --- the word
//     standing on the SPC bus --- and not the 82S21s' output.  Moving SPCPTR
//     by two, or never writing the RAM at all, survives this check.
//   - The ALATCH/MLATCH gating is not distinguished: making the latches
//     transparent through the write phase survives, because the one overlap
//     it could show --- a write to the address being read --- is exactly what
//     the pass-around covers.  It is right for synthesis, not for this trace.
//   - The WADR/AADR comparator's top bit is never the one that differs, so a
//     nine-bit compare survives a ten-bit one.
//   - OB's two shift selects are never taken: `OSEL` is only ever 0 (MO) or
//     1 (ALU), so `ALU >> 1` and `ALU << 1` with Q<31> shifted in are built
//     and unexercised.  Replacing `ALU >> 1` with `ALU` survives.
//   - Q is loaded five times and **never shifted**: `QS<1:0>` is 0 on 599,995
//     microcycles and 3 on the other five, so the 74S194s' shift paths and
//     every multiply and divide step with them are unexercised.
//   - AEQM widened from the low 32 slices to all 33 survives, so the
//     open-collector chain's width is not pinned down here either.
//   - Jump condition 5, `PAGE.FAULT OR INTERRUPT`, is never selected, and
//     condition 2 is selected once.
//   - Two of -WAIT's three terms never fire.  `USE.MD AND MBUSY AND
//     -MEMGRANT` --- MIT's "do not hang when this line is high", the gate
//     that keeps a hang from being taken before the grant --- is zero over
//     the run, and so is `LCINC AND NEEDFETCH AND MBUSY.SYNC`.  Dropping
//     either survives.  The first term carries the whole stall path here.
//   - **RDCYC and WRCYC being taken from the wrong instruction survives**,
//     and `src/rtl.rs` says in advance that it would: "taking it from the
//     instruction standing one microcycle later is the trap: that instruction
//     is the page-fault check MIT puts after every store, so MEMWR reads
//     false and every write cycle is performed as a read.  Nothing catches it
//     early --- the only thing the boot PROM writes before the disk is page
//     0, which it fills with the zeros already there."  Measured here from
//     the other side, and it holds.
//
// Against that, the ALU array is genuinely exercised: 21 of its 32
// function-and-mode combinations are reached, the sign-extending ninth slice
// is caught if removed (JCOND goes wrong at microcycle 5,202), the rotate is
// caught if reversed, the mask is caught if its two ends are swapped or if
// MSKL loses IR<9:5>, and swapping one entry of either half of the 74S181
// function table is caught within a few thousand microcycles.
//
// The stall path itself is caught where it is exercised: dropping -WAIT's
// first term, letting -HANG be taken before -WAIT, or clearing MBUSY one tick
// late are each caught at the boot PROM's first stalled microcycle.
//
// And the one-state-early trap on page DSPCTL is caught: the 25S07s take
// IR<41:32> of the DISPATCH *itself*, the word standing before the edge, and
// reading the newly loaded IR there instead is caught at microcycle 525,527.
//
// WHAT THIS PROGRAM DOES NOT EXERCISE, asserted here rather than assumed, so
// that a trace which reaches further re-opens each claim: every DISPATCH in
// it is a DISPWR, so the dispatch memory is written and never read and
// `dr`/`dp`/`dn`/`dpc` do not matter; it never halts; it never sets IR<46>,
// so the statistics counter never counts; it never sets PROMDISABLE, so it
// never runs the microcode it loads; and it runs at extra slow throughout,
// where both taps of the 74S151 are -TPR160 --- so ILONG changes nothing and
// the -NOPA gate on it at FLAG 3E07 is unchecked.  The scripted trace behind
// cadr_phase_gen.sv is what covers the seven taps.
//
// The control store comes up all ones rather than zero, and that is what
// makes the 16,384 words the boot PROM writes worth writing: every one of
// them is zero, so with the RAM coming up zero a write that never happened
// reads back exactly like one that did.  rtl/machine/cadr_microcycle.sv says so at
// the array.

#include <algorithm>
#include <cerrno>
#include <cinttypes>
#include <cstdio>
#include <cstdlib>
#include <cstring>
#include <deque>
#include <map>
#include <unordered_map>
#include <set>
#include <string>
#include <vector>

#include "Vcadr_machine.h"
#include "verilated.h"
#include "cadr_tick.h"

namespace {

// Five nanoseconds, the master clock's period.
constexpr int kTickNs = kGridNs;

// WHERE AN ACKNOWLEDGMENT LANDS, against muir's own column, in the units the
// histogram at the end prints: muir minus the fabric.
//
// **ZERO IS AGREEMENT, AND IT IS READ AT THE EDGE THAT TAKES IT.**  muir
// counts a change that falls exactly on an edge as before the edge, so an
// acknowledgment at instant T is one the registers clocked at T see.  The
// instrument reads -MEMACK with this tick's inputs settled and before this
// tick's edge, which is exactly what that edge takes, whether the
// acknowledgment is a register (the read deskew, the NXM timer), a gate off
// a register (the disk controller, off -XBUS.RQ) or a gate off this
// testbench's own `mem_done` (a write of main memory).  Every cycle of the
// program is held to it.
//
// It used to be read at the top of the tick, before the inputs, and so read
// a testbench-driven write a tick late and every other source on time; a
// constant of one tick, called the instrument's own, was then required of
// the disk controller's cycles and the NXM timer's --- which were in fact a
// tick late, and the whole machine with them.  `RD_FINISH_T`'s note in
// `rtl/machine/cadr_microcycle.sv` has that story.
constexpr int kInstrumentSlipNs = 0;

// WHERE THE NXM TIMER'S ACKNOWLEDGMENT LANDS.  The two cycles this program
// sends to empty Xbus space must both read this.  They move when the bus
// interface's free-running timeout oscillator changes phase, and the only
// thing that changes its phase is the tick reset is released on, which is why
// this is the one witness the boot PROM has to the reset network arriving
// everywhere at once.  Issue #21 was the oscillator two ticks early;
// `cadr_busint_xbus.sv` says why at `POWER_ON_T`.
constexpr int kNxmAckSlipNs = kInstrumentSlipNs;

// "a write is acknowledged at once, a read XBUS_ACK_NS later, which is the
// 60 ns tap of the TD100 at REQLM 0C09 deskewing the word into MD".
constexpr int kXbusAckNs = 60;

// The trace's columns, in the order golden/src/rtl.rs prints them.
enum Col {
  kCycle, kPc, kIr, kQ, kA, kM, kAlu, kR, kOb, kDc, kOpc, kSt, kLc,
  kWmapd, kDestspcd, kIwrited, kImodd, kPdlwrited, kSpushd, kNop, kNVmaok,
  kJcond, kPcs1, kPcs0, kSrun,
  kLpc, kMd, kVma, kPromdis, kErrstop, kStathenb, kSpeed1, kSpeed0,
  kStall, kHalted, kBus, kAck, kGnt, kSintr, kNs,
  kColumns
};

struct Row {
  uint64_t v[kColumns];
};

// One row of hexadecimal columns. Returns false if the count is wrong.
bool ParseRow(const char *line, Row &r) {
  const char *p = line;
  for (int i = 0; i < kColumns; ++i) {
    char *end = nullptr;
    r.v[i] = std::strtoull(p, &end, 16);
    if (end == p) return false;
    p = end;
  }
  return true;
}

// DESTMDR: the instruction stores OB into MD itself, at the edge.
bool RowDestmdr(const Row &r) {
  const uint64_t cls = (r.v[kIr] >> 43) & 3;
  const bool dest = !r.v[kNop] && (cls == 0 || cls == 3);
  return dest && !((r.v[kIr] >> 25) & 1) && ((r.v[kIr] >> 23) & 1) &&
         ((r.v[kIr] >> 22) & 1);
}

int Fail(const Row &r, const char *what, uint64_t got, uint64_t want) {
  std::fprintf(stderr,
               "microcycle %" PRIu64 " (PC %" PRIo64 "): %s is %" PRIx64
               ", reference says %" PRIx64 "\n"
               "  IR %" PRIo64 "  NOP %" PRIu64 "  JCOND %" PRIu64
               "  PCS %" PRIu64 "%" PRIu64 "\n",
               r.v[kCycle], r.v[kPc], what, got, want, r.v[kIr], r.v[kNop],
               r.v[kJcond], r.v[kPcs1], r.v[kPcs0]);
  return 1;
}

}  // namespace

int main(int argc, char **argv) {
  Verilated::commandArgs(argc, argv);

  const char *path = (argc > 1) ? argv[1] : "build/rtl.golden";
  std::FILE *f = std::fopen(path, "r");
  if (!f) {
    std::fprintf(stderr, "cannot read %s: %s\n", path, std::strerror(errno));
    return 2;
  }

  // THE TRACE IS STREAMED, NOT HELD.  The pack trace is 2.2 million
  // microcycles and 297 MB; holding it as parsed rows is 686 MB of a machine
  // three sessions are building on.  So it is read twice instead: once for
  // the acknowledgment times, which are the only thing needing to be known
  // before their row, and once to drive the DUT.
  bool pack_trace = false;
  // **A PROGRAM OF `golden/src/quux.rs` IS NOT THE BOOT PROM.**  Each is a
  // few hundred microcycles written to reach one of QUUX's differences, run
  // on either machine, so the counts below that describe what MIT's boot PROM
  // does --- its 16,951 disk polls, its two NXM cycles, its 512 memory
  // cycles, the disk's `0x2321` in MD --- describe nothing about it and are
  // not asserted.  Every row is compared exactly as on the boot PROM, and the
  // generator itself asserts what the program reached.
  bool script_trace = false;
  // **A PROGRAM OF QUUX'S FUSED RETURN** (`golden/src/fused.rs`): a main
  // loop that dispatches on the halfword and a location counter that
  // walks the code, which every other script leaves alone.  Its dispatches
  // and its counter are compared row for row like the rest, so the two
  // guards below that call them unreached are not asked of it.
  bool dispatch_trace = false;
  // **QUUX'S BOOT PROM TRACE RUNS AS FAR AS MIT'S**, 131,073 microcycles
  // longer for its larger clearing (`golden/src/rtl.rs`), so it carries the
  // memory sizing's NXM cycles, the disk's polls and `0x2321` in MD, and every
  // guard below holds it as it holds MIT's.  This names the run in messages.
  bool quux_prom = false;
  // **A MACHINE BUILT AS QUUX HAS ITS MEMORY PORT** (contract Q6): main
  // memory is not on the Xbus but behind the port's cache, which asks this
  // program for a line of four words on a miss and writes one word through
  // its buffer after the cycle has ended.  So main memory's words are not
  // placed from the trace here: this program IS main memory, a memory that
  // starts as muir's does, all zeros, and holds what the port writes.  A
  // word from the wrong line or a write that never went out reads back
  // wrong, and MD is compared every microcycle.  It answers in one to five
  // ticks, sooner than the nominal 380 and 290 ns, so every acknowledgment
  // is the port's floor and must land on muir's instant.  The video
  // controller's frame buffer is memory too (contract Q7), at the display's
  // base: the port fills its lines and writes it through as it does main
  // memory's, and
  // every write it owes lands here, in order, which is what the scanout
  // reading these words is owed.
  bool quux_machine = false;
  // **REVISION 13'S MAIN MEMORY IS PACKED STORAGE** (contract G1 §4.1, G2
  // §3): this program holds it as bytes, laid out as G1 says and not as the
  // port does, word w in the five bytes from the base the machine was built
  // with (`QUUX13_TB_BASE`, the Makefile's), `<7:0>` first and the tag last;
  // and the window as bytes too, four a word at the display's base, the
  // field alone (G1 §4.2).  Every byte nothing wrote reads as a poison
  // injective in its address, so a fill that asks the wrong bytes, a line
  // not of five beats, or a word packed any other way reads wrong in MD;
  // and every write is checked for where it lands and what it carries
  // against the cycle that owes it.  The programs read no byte they did not
  // write.
  bool rev13 = false;
  // **REVISION 14** (contract G3 revision 14, whose programs are gone with
  // it, so no trace made now sets this): its
  // main memory is revision 13's packed storage, its frame buffer is at the
  // device window's bus address `1 << 28`, and two more things write and
  // fill it besides the processor's own cycles: the walk's reads, which
  // fill lines no cycle of the processor's is at, and the write-backs'
  // table words, which no cycle owes.  Both are served here as main memory
  // and counted; the programs read every table word they assert back through
  // the physical memory window, so a wrong write-back reads wrong in MD.
  bool rev14 = false;
  long side_fills = 0, side_writes = 0;
  // The file device's two bases as muir's device holds them at the end of a
  // revision-13 program (`# fdbases`), for the readout's selector 12.
  bool have_fd_bases = false;
  uint64_t fd_cmd_base_end = 0, fd_resp_base_end = 0;
  // Revision 14's memory system's words and the redirect's copies as muir
  // holds them at the end (`# mswords`, `# pdlcopies`), for the readout's
  // entries 41 to 45 (A14.14).
  bool have_ms = false, have_copies = false;
  uint64_t ms_dir_end = 0, ms_types_end = 0, ms_refused_end = 0, copies_base_end = 0, copies_head_end = 0;
  // **BLOCK-DISK'S PACK AND ITS TRANSFERS ON THE WHOLE MACHINE** (revision
  // 13's `disk` program, gone with revision 13's programs): the pack's blocks
  // (`# disk`), those holding the rule's words (`# pack`), and the pages the
  // transfers reach (`# dma`), which the channel reads and writes through the
  // port beside the processor.  This program is the pack side, as
  // `tb/quux15_block_walk_tb.cpp`'s is, serving the block store on the
  // machine's seam.
  bool have_disk = false;
  uint32_t disk_blocks = 0;
  std::set<uint32_t> disk_preloaded;
  std::vector<uint32_t> dma_pages;
  // Main memory's 64K-word boards: QUUX's 32 unless the trace says.
  unsigned main_boards = 32;
  // Key words for the keyboard's cable, by the microcycle they go in before,
  // and the ones not yet on it: one a tick, from the tick that microcycle
  // starts on.
  std::map<uint64_t, std::vector<uint64_t>> keys;
  std::vector<uint64_t> keys_due;
  size_t keys_sent = 0;
  // **QUUX'S REVISION 9, THE HOST'S SIDE** (`golden/src/quux.rs`): the
  // real-time clock's start, loaded at reset as Linux sets it at boot; the
  // seconds the host sets it to before a microcycle; and the file device's
  // commands as muir's device ran them --- when each was taken, and when each
  // completed, with the words it wrote into main memory --- which this
  // program plays as Linux's server does, through the machine's host side.
  bool have_rtc = false;
  uint64_t rtc_start = 0;
  std::map<uint64_t, uint64_t> rtc_sets;
  struct FdDone {
    uint64_t due, prod, handles;
    std::vector<std::pair<uint32_t, uint64_t>> words;
  };
  std::vector<FdDone> fd_done;
  struct FdTake {
    uint64_t start, index;
    std::vector<std::pair<uint32_t, uint64_t>> entry;
  };
  std::vector<FdTake> fd_takes;
  // **TRANSMIT DONE OFF THE FAR END** (`golden/src/trace.rs`'s
  // `chaos_txdone`): muir's instant in nanoseconds, and the abort.  muir's
  // interface raises Transmit Done at its frame's end on its own; the I/O
  // board's waits for `chaos_tx_done`, which this testbench plays as the
  // cable would.
  std::vector<std::pair<uint64_t, bool>> chaos_txdone;
  std::vector<uint64_t> ack_for;
  std::vector<uint64_t> rdata_for;
  std::vector<uint64_t> md_at_row;
  std::vector<bool> arbitrated;
  long unibus_cycles = 0;
  size_t total_rows = 0;
  uint64_t trace_end_ns = 0;
  {
    char line[512];
    std::vector<uint64_t> bus_at;   // row indices that start a bus cycle
    std::vector<uint64_t> acks;     // and every row's ack column
    std::vector<uint64_t> mds;      // every row's md column
    std::vector<char> stalled_srcmd;
    std::vector<uint64_t> ends;     // every row's ns column, its end

    while (std::fgets(line, sizeof line, f)) {
      if (line[0] == '#') {
        // A key word pressed on the keyboard's cable before a microcycle
        // (`golden/src/quux.rs`'s page program): `# key CYCLE WORD`.
        unsigned long long kc = 0, kw = 0;
        if (std::sscanf(line, "# key %llx %llx", &kc, &kw) == 2) keys[kc].push_back(kw);
        // Revision 9's lines, by their keyword whole: `# fd` is a prefix of
        // the others, and a hexadecimal field would take their next letter.
        char kw9[16] = "";
        unsigned long long h0 = 0, h1 = 0, h2 = 0;
        const int n9 = std::sscanf(line, "# %15s %llx %llx %llx", kw9, &h0, &h1, &h2);
        const std::string k9(kw9);
        if (k9 == "rtc" && n9 == 2) {
          have_rtc = true;
          rtc_start = h0;
        }
        if (k9 == "rtcset" && n9 == 3) rtc_sets[h0] = h1;
        if (k9 == "mswords" && n9 == 4) {
          have_ms = true;
          ms_dir_end = h0;
          ms_types_end = h1;
          ms_refused_end = h2;
        }
        if (k9 == "pdlcopies" && n9 == 3) {
          have_copies = true;
          copies_base_end = h0;
          copies_head_end = h1;
        }
        if (k9 == "fdbases" && n9 == 3) {
          have_fd_bases = true;
          fd_cmd_base_end = h0;
          fd_resp_base_end = h1;
        }
        if (k9 == "fdtake" && n9 == 3) fd_takes.push_back(FdTake{h0, h1, {}});
        if (k9 == "chaos-txdone" && n9 == 3) chaos_txdone.emplace_back(h0, h1 != 0);
        if (k9 == "fdc" && n9 == 3 && !fd_takes.empty())
          fd_takes.back().entry.emplace_back(static_cast<uint32_t>(h0), static_cast<uint64_t>(h1));
        if (k9 == "fd" && n9 == 4) fd_done.push_back(FdDone{h0, h1, h2, {}});
        if (k9 == "fdw" && n9 == 3 && !fd_done.empty())
          fd_done.back().words.emplace_back(static_cast<uint32_t>(h0), static_cast<uint64_t>(h1));
        if (std::strstr(line, "rtl_sys.rs")) pack_trace = true;
        if (std::strstr(line, "golden/src/quux.rs")) script_trace = true;
        // `golden/src/quux.rs`'s `fused`, `operand`, `prefetch` and
        // `returns` have their dispatches and location counter compared row
        // for row.
        if (std::strstr(line, "golden/src/quux.rs") &&
            (std::strstr(line, "program fused,") || std::strstr(line, "program operand,") ||
             std::strstr(line, "program prefetch,") || std::strstr(line, "program returns,")))
          dispatch_trace = true;
        if (std::strstr(line, "QUUX's boot PROM")) quux_prom = true;
        if (std::strstr(line, "machine: quux")) quux_machine = true;
        if (std::strstr(line, "revision 13")) rev13 = true;
        if (std::strstr(line, "revision 14")) rev13 = rev14 = true;
        unsigned boards_line = 0;
        if (std::sscanf(line, "# boards %u", &boards_line) == 1) main_boards = boards_line;
        if (k9 == "disk" && n9 == 2) {
          have_disk = true;
          disk_blocks = static_cast<uint32_t>(h0);
        }
        if (k9 == "pack" && n9 == 2) disk_preloaded.insert(static_cast<uint32_t>(h0));
        if (k9 == "dma" && n9 == 2) dma_pages.push_back(static_cast<uint32_t>(h0));
        continue;
      }
      if (line[0] == '\n') continue;
      Row r;
      if (!ParseRow(line, r)) {
        std::fprintf(stderr, "%s: row %zu has the wrong column count\n", path,
                     total_rows);
        return 2;
      }
      acks.push_back(r.v[kAck]);
      // What `-LOADMD` should put in MD if it strobes during this
      // microcycle, taken from the trace and keyed by the row rather than
      // queued.
      //
      // A QUEUE OF THE WORDS MD WAS SEEN TO TAKE DOES NOT WORK, and the way
      // it fails is worth the comment: a read whose word equals what MD
      // already holds moves nothing, so it is invisible as a change, and the
      // queue then hands the *next* read a later cycle's word. Measured ---
      // it goes wrong at microcycle 536,309 of the boot PROM, where the
      // second read returns the zero MD already had.
      //
      // Keyed by row, the rule is the one `golden/src/trace.rs` already
      // needed for the `md` column itself: a hang loads MD *before* its own
      // microcycle's read phase, so that row's own column is the word; a
      // -WAIT and an unstalled cycle load it at the edge, so the next row's
      // is. A row that both reads MD and writes it needs no special case:
      // `DESTMDR` lands at the edge and overwrites whatever the bus put
      // there, in the fabric as in `Rtl::clock_edge`, so on an unstalled row
      // the loaded word is discarded either way.
      mds.push_back(r.v[kMd]);
      ends.push_back(r.v[kNs]);
      trace_end_ns = r.v[kNs];
      stalled_srcmd.push_back(r.v[kStall] != 0);
      if (r.v[kBus]) bus_at.push_back(total_rows);
      ++total_rows;
    }
    // For each microcycle that starts a bus cycle, when -MEMACK is due. The
    // interface usually knows at the boundary; a cycle that has to arbitrate
    // for the Unibus first is granted, acknowledged and finished inside a
    // later microcycle's stall, so its answer appears on a later row.
    md_at_row = mds;
    rdata_for.assign(total_rows, 0);
    for (size_t i = 0; i < total_rows; ++i) {
      rdata_for[i] = stalled_srcmd[i] ? mds[i]
                                      : (i + 1 < total_rows ? mds[i + 1] : mds[i]);
    }
    ack_for.assign(total_rows, 0);
    arbitrated.assign(total_rows, false);
    for (uint64_t i : bus_at) {
      size_t j = i;
      while (j < acks.size() && acks[j] == 0) ++j;
      ack_for[i] = (j < acks.size()) ? acks[j] : 0;
      // **THE WORD A READ BRINGS IS THE WORD OF THE ROW ITS -LOADMD LANDS
      // IN, AND THE MEMORY MAY BE ASKED FOR IT ROWS EARLIER.**  The bridge
      // takes `mem_rdata` when the memory answers, which is the deskew and
      // more before -LOADMD; with the CADR's microcycles of fourteen ticks
      // and more that is the same row, and with QUUX's of three or four it
      // can be several rows before, whose own column is the word from
      // before the read.  So every row of a read's flight carries the word
      // of the row the strobe falls in: the first whose end is at or past
      // the acknowledgment, by the rule above, and the row after it when
      // the acknowledgment is on that row's own end, a strobe on an edge
      // being that edge's.  Measured on `quux_divmdsync` at K = 4: a word
      // acknowledged two ticks into a `DIV`'s microcycle was handed the
      // word from before, from a row three microcycles earlier.
      if (ack_for[i] != 0) {
        size_t a = i;
        while (a < total_rows && ends[a] < ack_for[i]) ++a;
        if (a < total_rows) {
          const uint64_t word = (ends[a] == ack_for[i])
                                    ? (a + 1 < total_rows ? mds[a + 1] : mds[a])
                                    : rdata_for[a];
          for (size_t x = i; x <= a; ++x) rdata_for[x] = word;
        }
      }
      // A cycle whose answer is not known at the boundary it started on had
      // to arbitrate for the Unibus first. THE FABRIC'S BUS INTERFACE HAS NO
      // UNIBUS PATH --- `cadr_busint_xbus.sv` is the Xbus half --- so neither
      // this testbench's model of it nor the processor behind it can place
      // that grant, and the microcycles the arbitration stalls are exempt
      // from the length check. They are counted, and the count is held down,
      // so this cannot quietly become the rule.
      if (j != i) {
        ++unibus_cycles;
        for (size_t x = i; x <= j && x < total_rows; ++x) arbitrated[x] = true;
      }
    }
  }

  // A trace the Makefile could not make says so in one comment line and
  // carries no microcycles. That is not a failure: the System release is
  // fetched material and a checkout without it still runs every check that
  // matters.
  if (total_rows == 0) {
    std::printf("skipped: %s carries no microcycles\n", path);
    std::fclose(f);
    return 0;
  }
  if (total_rows < 2) {
    std::fprintf(stderr, "FAIL: %s carries %zu microcycles\n", path,
                 total_rows);
    return 1;
  }
  std::rewind(f);

  auto *dut = new Vcadr_machine;
  // `-BOOT2` is a pulled-up line and nothing on this check presses it.
  // **Active low, so an undriven input would hold the machine at the boot
  // trap for ever**, which is the loud failure this line exists to avoid.
  dut->n_boot2 = 1;
  dut->clk = 0;
  dut->rst = 1;
  dut->boards = main_boards;  // Machine::new's MAIN_WORDS >> 16, or the trace's
  dut->mem_done = 0;
  dut->mem_rdata = 0;
  // NOTHING OUTSIDE THE MACHINE ANSWERS AN XBUS DEVICE, and this is the whole
  // of it: `device_ack` is driven low here and never again.  The display and
  // the I/O board are not built and this program does not touch them; the
  // disk controller is inside.
  dut->device_ack = 0;
  dut->device_rdata = 0;
  // A mouse at rest, its seven lines high, nothing pressed; and the
  // Chaosnet address muir's machine comes up with, `chaos::Config`'s.
  dut->mouse_lines = 0x7f;
  dut->chaos_address = 0177001;
  dut->kbd_strobe = 0;
  dut->kbd_code = 0;
  // Block-disk's unit 0: a pack when the trace has one.
  dut->drive_present = have_disk ? 1 : 0;
  dut->store_we = 0;
  dut->store_deny = 0;
  dut->store_busy = 0;
  // Verilator records the previous value of a clock at eval time, so the
  // first eval has to happen with clk low or the first posedge is not one.
  dut->eval();

  // Reads the next data row, skipping comments. False at end of file.
  auto read_next = [&](Row &r) {
    char line[512];
    while (std::fgets(line, sizeof line, f)) {
      if (line[0] == '#' || line[0] == '\n') continue;
      return ParseRow(line, r);
    }
    return false;
  };

  // Present a row's stimulus: what the memory path would be driving over that
  // microcycle, and what the console would be holding.
  // **`device_rdata` NO LONGER CARRIES THE WORD, AND THAT IS THE POINT OF THE
  // SLICE.**  It used to be `rdata_for[row]`, the same column `mem_rdata`
  // gets, so all 16,951 device cycles --- the boot PROM's disk polls --- were
  // answered with muir's own word.  `rtl/machine/cadr_disk_controller.sv` answers
  // them now, and a line that went on handing back the right word would leave
  // that module unchecked: the `md` trap verbatim, where a driven input that
  // became an output kept being driven and both processor checks went green
  // with MD unchecked.  What goes on the seam instead is the complement.
  // The host's writes, one a tick, in order: {index, word}.
  std::deque<std::pair<unsigned, uint32_t>> host_ops;
  auto drive = [&](const Row &r, size_t row) {
    const auto kit = keys.find(static_cast<uint64_t>(row));
    if (kit != keys.end())
      keys_due.insert(keys_due.end(), kit->second.begin(), kit->second.end());
    // **`sintr` WAS DRIVEN HERE AND THE LINE IS GONE.**  -XBUS.INTR is the
    // machine's own now: `cadr_disk_controller.sv` puts the disk's request on
    // it, `cadr_tv.sv` the display's vertical interrupt, and `cadr_machine.sv`
    // ORs the two where the backplane does.  The column is COMPARED below
    // instead, against `sintr_o`.  Deleted rather than left unused, which is
    // the `md` trap word for word: Verilator lets a testbench write an output,
    // so a drive line that stayed would have gone on supplying the right
    // answer and the join would have been unchecked with every check green.
    dut->mem_rdata = static_cast<uint32_t>(rdata_for[row]);
    // **POISON ON THE SEAM, ALWAYS, AND NEVER DATA.**  `device_rdata` is what
    // `cadr_machine.sv` puts on MEM<31:0> when no slave inside it is driving
    // them, which is every device WRITE --- no slave drives the data lines on
    // a write --- and every device READ the disk controller fails to answer.
    // Holding the complement of the word MD should hold makes both of those
    // loud: a processor whose -LOADMD has lost its RDCYC gate takes poison on
    // a write, and a register block that stops driving reads poison instead
    // of the word it happened to hand back last.  The rule is that a stimulus
    // that poisons cannot move with the bug, and this one cannot: it is the
    // trace's own column, complemented, keyed by the row.
    dut->device_rdata = ~static_cast<uint32_t>(rdata_for[row]);
  };

  // What the DUT held over the microcycle now ending: sampled every tick, so
  // that the edge is compared against the read phase before it and not
  // against the values the edge has just produced.
  struct Sample {
    uint64_t pc, ir, lpc, opc, st, a, m, alu, r, ob, q, dc, lc, vma, md, vmaok,
        jcond, nop, pcs1, pcs0, iwrited, promdis, sintr;
  };
  auto take = [&]() {
    return Sample{dut->pc,  dut->ir,    dut->lpc, dut->opc,   dut->st,
                  dut->a,   dut->m,     dut->alu, dut->r,     dut->ob,
                  dut->q,   dut->dc,    dut->lc,  dut->vma,   dut->md,
                  dut->vmaok,
                  dut->jcond, dut->nop, dut->pcs1, dut->pcs0, dut->iwrited,
                  dut->promdisable, dut->sintr_o};
  };

  Row cur;
  if (!read_next(cur)) {
    std::fprintf(stderr, "FAIL: %s: cannot read the first microcycle\n", path);
    return 1;
  }
  uint64_t prev_ns = 0;
  drive(cur, 0);
  Sample prev = take();

  const char *max_env = std::getenv("CADR_TB_MISMATCHES");
  const int max_bad = max_env ? std::atoi(max_env) : 20;
  size_t k = 0;          // the microcycle now running
  long last_edge = -1;   // -1 until the first, whose length has no start
  int bad = 0;

  // Coverage, and the assertions that say what this program leaves untouched.
  long lengths_checked = 0, dispatches = 0, disp_reads = 0, halts = 0;
  long iwrites = 0, popjs = 0, jumps = 0, prom_fetches = 0, ram_fetches = 0;
  long stat_counts = 0, stalls = 0, ram_executes = 0, other_speed = 0;
  long lc_moved = 0, map_sources = 0, cycles_run = 0;
  long q_shifts = 0, ilongs = 0, promdis_rows = 0;
  long sub_tick = 0, worst_slip = 0, best_slip = 0, arb_skipped = 0;
  bool any_slip = false;
  bool bus_outstanding = false, saw_mem_req = false, saw_device = false;
  bool acked_armed = false;
  int prev_n_memgrant = 1;
  long grants_checked = 0;
  uint64_t ack_for_cur = 0;
  std::map<long, long> ack_error;
  bool saw_ub = false;
  long ub_cycles = 0;
  bool was_unibus = false, was_nxm = false;
  // **THE NXM TIMER'S INSTANT IS THE ONLY WITNESS THIS PROGRAM HAS TO THE
  // RESET RELEASE.**  The oscillator at REQTIM 0A01 free-runs from power-on
  // --- `cadr_busint_xbus.sv` sets `vco_acc` and `vco` on `rst` and never
  // again --- so its phase is fixed by the tick `rst` is released on, and the
  // instant a cycle nothing answers reaches -MEMACK carries that phase.
  // Every other acknowledgment on this program is either driven from the
  // trace or made combinationally by the disk controller, so none of them can
  // see it.  Compared per cycle here rather than left to the histogram, which
  // was printed and asserted by nothing.
  bool cur_nxm = false;
  long nxm_acks = 0, nxm_ack_wrong = 0;
  long dev_acks_measured = 0, dev_ack_wrong = 0;
  uint32_t stuck_phys = 0;
  const char *stopped_because = "nothing on the bus answered it";
  // HOW MANY DEVICE CYCLES THE FABRIC ITSELF ANSWERED.  Counted at the far
  // end of the cycle rather than at the disk's own `dev_ack`, which no port
  // brings out: a device cycle that reached -MEMACK without the NXM timer
  // ending it was answered by something inside the machine, and the only
  // thing inside is the disk controller --- `device_ack` is driven low at the
  // top of `main` and never again.  On this program it must be all 16,951,
  // and the guard below says so rather than printing a number nobody reads.
  long device_answers = 0, device_timeouts = 0;
  bool dev_cycle = false, dev_acked = false;
  // WHICH SLAVE EACH CYCLE WENT TO, counted at the grant. Not a diagnostic:
  // this program's traffic is 16,951 device cycles against 512 to main
  // memory --- the boot PROM polls the disk controller's status register,
  // which the decode places in Xbus I/O space --- and **all 16,951 are now
  // answered by the fabric's own `cadr_disk_controller.sv`** where they used
  // to be answered from the trace.  What is still the testbench's own
  // placement is the 512, through `mem_done`.  The check should fail rather
  // than shrink quietly if either count ever goes to none.
  long mem_cycles = 0, device_cycles = 0;
  long ddr_addrs_checked = 0;
  // -XBUS.INTR: how many microcycles it was compared on, how many it was up
  // on, and how many rows held the disk's status word in MD --- the guard
  // that says the zero above is a live zero and not a dead controller.
  long sintr_checked = 0, sintr_raised = 0, status_rows = 0;
  long dev_writes_checked = 0;
  std::map<uint32_t,long> dev_words;
  long ack_at_tick = 0;
  long armed_row = -1;
  // QUUX's main memory: its words, when the operation standing is due, and
  // the writes the processor's cycles owe it, in order.
  constexpr uint32_t kMainBase = 0x1B000000u;
  // The video controller's frame buffer: `tv::BUFFER`, 40,960 words at 1280
  // by 1024 unless the build gives the machine another size and this file
  // its words (`CADR_TB_VIDEO_WORDS`, the Makefile's `QUUX13_G_<program>`),
  // at the display's base, `cadr_ddr_map::DISPLAY_BASE` on the Zynq boards.
  constexpr uint32_t kFbBase = 0x1C000000u;
#ifndef CADR_TB_VIDEO_WORDS
#define CADR_TB_VIDEO_WORDS 40960u
#endif
  constexpr uint32_t kFb = 017000000u, kFbWords = CADR_TB_VIDEO_WORDS;
  auto q_fb = [&](uint32_t p) { return p >= kFb && p - kFb < kFbWords; };
  long q_fb_fills = 0, q_fb_writes = 0;
  std::map<uint32_t, uint32_t> q_mem;
  std::vector<std::pair<uint32_t, uint64_t>> q_owed;
#ifndef QUUX13_TB_BASE
#define QUUX13_TB_BASE 0x12000000u
#endif
  constexpr uint32_t kMain13Base = QUUX13_TB_BASE;
  constexpr uint32_t kWindow13 = 01760000000u;
  std::unordered_map<uint32_t, uint8_t> q13;
  auto q13_get = [&](uint32_t a) -> uint8_t {
    const auto it = q13.find(a);
    return it != q13.end() ? it->second : static_cast<uint8_t>((a * 0x9E3779B1u) >> 23 ^ 0xA5u);
  };
  auto q13_main = [&](uint32_t a) {
    return a >= kMain13Base && a - kMain13Base < 5u * (static_cast<uint32_t>(main_boards) << 16);
  };
  // Word w of revision 13's main memory, whole, and a word put there as the
  // host puts it: the file device's server writes a word's five bytes.
  auto q13_word = [&](uint32_t w) {
    uint64_t v = 0;
    for (int b = 0; b < 5; ++b) v |= static_cast<uint64_t>(q13_get(kMain13Base + 5u * w + b)) << (8 * b);
    return v;
  };
  auto q13_put = [&](uint32_t w, uint64_t v) {
    for (int b = 0; b < 5; ++b) q13[kMain13Base + 5u * w + b] = static_cast<uint8_t>(v >> (8 * b));
  };
  long q13_spanning = 0;
  // The pack side, when the trace has a pack: one move at a time, a dirty
  // slot written back before its fill, some ticks after the request, and a
  // block past the pack's end denied.  The block store's 24 slots of 256
  // words, as `tb/quux15_block_walk_tb.cpp`'s pack side keeps them.
  constexpr int kPackSlots = 24, kPackLatency = 40;
  uint32_t pk_tag[kPackSlots] = {};
  bool pk_valid[kPackSlots] = {}, pk_dirty[kPackSlots] = {};
  int pk_rr = 0, pk_t = 0, pk_slot = 0, pk_k = 0;
  enum { PK_IDLE, PK_WAIT, PK_BACK, PK_FILL } pk_state = PK_IDLE;
  uint32_t pk_lba = 0;
  std::map<uint32_t, std::vector<uint32_t>> pk_disk;   // the blocks written back
  std::vector<uint32_t> pk_words, pk_back(256);
  long pk_served = 0, pk_written_back = 0, pk_denied = 0;
  auto pk_block = [&](uint32_t lba) {
    const auto it = pk_disk.find(lba);
    if (it != pk_disk.end()) return it->second;
    std::vector<uint32_t> b(256, 0);
    if (disk_preloaded.count(lba))
      for (uint32_t w = 0; w < 256; ++w)
        b[w] = (lba << 12) ^ (w << 1) ^ 0x5a000001u ^ ((lba << 23) | (lba >> 9));
    return b;
  };
  // **THE CHANNEL'S WORDS IN PACKED STORAGE**: a read of one or two beats,
  // and a write of five bytes, at a page a transfer reaches.  The
  // processor's own fills are five beats, and its writes are the ones its
  // cycles owe, in order.
  auto dma_at = [&](uint32_t a) {
    for (uint32_t pg : dma_pages)
      if (a >= kMain13Base + 5u * pg && a < kMain13Base + 5u * (pg + 1024u)) return true;
    return false;
  };
  long ch13_reads = 0, ch13_two_beats = 0, ch13_writes = 0;
  long q_due = -1;
  bool q_answered = false;
  long q_fills = 0, q_writes = 0;
  uint64_t q_seed = 0x5155u;
  // **MAIN MEMORY AT THE BOARDS' LATENCY** (`LAT_HI`, `LAT_LO`, `LAT_SEED`):
  // each QUUX main-memory request answered 33 to 228 ticks after it is made,
  // drawn per request from the seed, where the harness's own answers take 1
  // to 5 ticks, or 14 to 18 for a lone write --- always faster than muir's
  // count, so the port never waited on the memory itself.  The boards' DDR
  // answers in 33 to 228 ticks (`MemoryTiming::DE25_NANO`'s measurement),
  // often slower than the count.  muir does not model that wait, so a
  // microcycle's length and -MEMACK's instant then differ from the trace and
  // are counted rather than failed; everything else is compared as ever,
  // and every write a cycle made must reach main memory.
  // `build/quux14_*.quux.lat.pass` runs each revision 14 program so, and
  // `build/machine.lat.pass` and `build/quux_*.lat.pass` the CADR's goldens
  // (`c_due` below).
  const long lat_lo = std::getenv("LAT_LO") ? std::atol(std::getenv("LAT_LO")) : 33;
  const long lat_hi = std::getenv("LAT_HI") ? std::atol(std::getenv("LAT_HI")) : 0;
  if (lat_hi > 0 && (lat_lo < 1 || lat_hi < lat_lo)) {
    std::fprintf(stderr, "FAIL: LAT_LO %ld and LAT_HI %ld are not a range of ticks\n", lat_lo, lat_hi);
    return 2;
  }
  if (std::getenv("LAT_SEED")) q_seed = std::strtoull(std::getenv("LAT_SEED"), nullptr, 0);
  long lat_longest = 0, lat_lengths = 0, lat_late_fills = 0;
  // The bus cycles the processor started, the latest few, and the first row
  // that disagreed with muir: said at the end of a run under `LAT_HI`.
  struct LatCycle { size_t row; uint32_t phys; bool device, write, nxm; };
  std::deque<LatCycle> lat_cycles, lat_before_bad;
  long lat_first_bad = -1;
  uint64_t lat_bad_fabric_ns = 0, lat_bad_muir_ns = 0;
  auto q_rng = [&]() {
    q_seed = q_seed * 6364136223846793005ull + 1442695040888963407ull;
    return static_cast<uint32_t>(q_seed >> 33);
  };
  // The latencies drawn under `LAT_HI`, on either machine, so that the
  // report says the range was really sampled and not one value of it.
  long lat_draws = 0;
  std::set<long> lat_drawn;
  // **AND THE CADR'S MAIN MEMORY AT THE SAME LATENCY.**  The CADR's bridge
  // (`rtl/plumbing/cadr_xbus_ddr.sv`) is answered at muir's instant
  // otherwise, with the word on `mem_rdata` for the whole of the read's
  // flight, so a bridge that took the word before `mem_done` read the right
  // one.  Under `LAT_HI` each of its requests is answered `LAT_LO` to
  // `LAT_HI` ticks after `mem_req` rises, drawn from the same generator, and
  // `mem_rdata` carries the complement of the word until the tick
  // `mem_done` stands.  The word is the trace's for the row the request
  // rises in, which every row of the read's flight carries (`rdata_for`).
  long c_due = -1;
  uint32_t c_word = 0;
  long c_requests = 0;
  long early_grants = 0;
  size_t unanswerable = 0;
  std::set<uint64_t> a_values, m_values, ob_values;

  // Long enough for every microcycle plus the reset and a margin: the
  // longest cycle the generator makes is 44 ticks at extra slow.
  // And as long as the trace's own time with the same margin again, which
  // revision 14's sweep needs: a microcycle held 8,192 ticks for it.
  const long kMaxTicks = std::max(static_cast<long>(total_rows) * 96 + 1024,
                                  static_cast<long>(trace_end_ns / kTickNs) * 2 + 1024) * (lat_hi > 0 ? 40 : 1);

  // The file device's host: the next completion to play, what STATE and the
  // command producer shown to the host last read, and when the producer
  // shown passed each command muir took.
  size_t fd_next = 0, fd_played = 0;
  uint32_t host_state = 0, host_shown = 0;
  long fd_refused_seen = 0, fd_busy_seen = 0;
  size_t take_next = 0;
  long entry_words_checked = 0, mem_words_checked = 0;
  size_t txdone_next = 0;
  for (long t = 0; t < kMaxTicks && k < total_rows; ++t) {
    if (t == 4) dut->rst = 0;
    {
      const long ns_now = static_cast<long>(prev_ns) + (t - last_edge) * kTickNs;
      // muir's due time is to the nanosecond and the machine reads at its
      // own instants, which are on the grid: the first read that sees the
      // completion is the first at or after it.
      const auto on_grid = [](uint64_t ns) {
        return static_cast<long>((ns + kTickNs - 1) / kTickNs * kTickNs);
      };
      // The far end's Transmit Done: a pulse on the edge a tick before
      // muir's instant's, so that the CSR shows it from that instant's tick
      // as muir's read at or after the instant does (`cadr_io_board.sv`
      // registers `ch_tdone` on the edge that samples `chaos_tx_done`).
      dut->chaos_tx_done = 0;
      dut->chaos_tx_abort = 0;
      if (txdone_next < chaos_txdone.size() && last_edge >= 0 &&
          ns_now + kTickNs >= on_grid(chaos_txdone[txdone_next].first)) {
        const auto &d = chaos_txdone[txdone_next++];
        if (ns_now + kTickNs != on_grid(d.first)) {
          std::fprintf(stderr, "FAIL: Transmit Done due at %" PRIu64 " ns is off the grid at %ld\n",
                       d.first, ns_now + kTickNs);
          ++bad;
        }
        dut->chaos_tx_done = 1;
        dut->chaos_tx_abort = d.second;
      }
    }
    // The pack side.
    if (have_disk) {
      dut->store_we = 0;
      dut->store_deny = 0;
      dut->store_busy = 0;
      switch (pk_state) {
        case PK_IDLE:
          if (dut->req_valid) {
            pk_state = PK_WAIT;
            pk_t = 0;
            pk_lba = dut->req_tag;
          }
          break;
        case PK_WAIT:
          if (!dut->req_valid) {
            pk_state = PK_IDLE;
            break;
          }
          if (++pk_t < kPackLatency) break;
          if (pk_lba >= disk_blocks) {
            dut->store_deny = 1;
            ++pk_denied;
            pk_state = PK_IDLE;
            break;
          }
          pk_slot = -1;
          for (int x = 0; x < kPackSlots && pk_slot < 0; ++x)
            if (!pk_valid[x]) pk_slot = x;
          while (pk_slot < 0) {
            const int x = pk_rr++ % kPackSlots;
            if (!(dut->ch_active && !dut->ch_waiting && dut->ch_slot == x)) pk_slot = x;
          }
          pk_k = 0;
          pk_state = pk_dirty[pk_slot] ? PK_BACK : PK_FILL;
          pk_words = pk_block(pk_lba);
          break;
        case PK_BACK:
          dut->store_busy = 1;
          dut->store_busy_slot = pk_slot;
          dut->store_slot = pk_slot;
          dut->store_addr = pk_k < 256 ? pk_k : 0;
          if (pk_k >= 2) pk_back[pk_k - 2] = dut->store_rdata;
          if (++pk_k == 258) {
            pk_disk[pk_tag[pk_slot]] = pk_back;
            pk_dirty[pk_slot] = false;
            ++pk_written_back;
            if (pk_lba == pk_tag[pk_slot]) pk_words = pk_back;
            pk_k = 0;
            pk_state = PK_FILL;
          }
          break;
        case PK_FILL:
          dut->store_busy = 1;
          dut->store_busy_slot = pk_slot;
          dut->store_we = 1;
          dut->store_slot = pk_slot;
          if (pk_k == 0) {
            dut->store_addr = 259;
            dut->store_wdata = 0x80000000u;
            pk_valid[pk_slot] = false;
          } else if (pk_k <= 256) {
            dut->store_addr = pk_k - 1;
            dut->store_wdata = pk_words[pk_k - 1];
          } else if (pk_k <= 259) {
            dut->store_addr = 256 + (pk_k - 257);
            dut->store_wdata = 0;
          } else {
            dut->store_addr = 259;
            dut->store_wdata = pk_lba;
            pk_valid[pk_slot] = true;
            pk_tag[pk_slot] = pk_lba;
            ++pk_served;
            pk_state = PK_IDLE;
          }
          ++pk_k;
          break;
      }
    }
    // The keyboard's cable: a word a tick while any is due.
    if (keys_sent < keys_due.size()) {
      dut->kbd_strobe = 1;
      dut->kbd_code = static_cast<uint32_t>(keys_due[keys_sent++]);
    } else {
      dut->kbd_strobe = 0;
    }

    // THE DDR, AND NOTHING NEARER.  The bus interface, the address decode and
    // the bridge are all inside the DUT now: what this drives is the far side
    // of `mem_req`/`mem_done`, and -MEMGRANT, -MEMACK and -LOADMD are the
    // fabric's own.
    //
    // The answer is placed where muir's responder placed it. `-XBUS.RQ` is
    // SETUP_NS after the grant and the bridge is thin --- "dev_ack follows
    // mem_done without a register" --- so answering at muir's `answered_at`
    // puts -MEMACK at muir's `ack`. A read is acknowledged XBUS_ACK_NS after
    // the word, a write at once, which is the only thing the direction is
    // used for; taking it from the bridge's own `mem_write` times the answer
    // and never chooses the data.
    dut->mem_done = 0;
    // **WHERE IN DDR THE BRIDGE PUT THE WORD**, once a cycle, against the
    // map transcribed from `rtl/plumbing/cadr_ddr_map.sv` for the Zynq
    // boards, which is the map this model is built with: main memory at
    // 0x1B000000 a word a four bytes, and the first display's buffer at
    // 0x1C000000 from `17000000`, the same rule for the CADR's 32K words and
    // the video controller's 40,960.  Nothing else here looks at the
    // address, so a display window folded onto the wrong words would read
    // back whatever the trace hands it and pass.
    if (dut->mem_req && !saw_mem_req) {
      const uint32_t p = dut->phys;
      const uint32_t fb = 017000000u;
      const uint32_t want = (p >= fb && p - fb < 0200000u) ? 0x1C000000u + ((p - fb) << 2)
                                                           : 0x1B000000u + (p << 2);
      ++ddr_addrs_checked;
      if (dut->mem_addr != want) {
        std::fprintf(stderr,
                     "microcycle %zu: the bridge asked DDR for %08x for word %o, want %08x\n",
                     k, dut->mem_addr, p, want);
        ++bad;
      }
    }
    if (dut->mem_req) saw_mem_req = true;
    if (dut->dev_rq && dut->device) saw_device = true;
    if (dut->ub_msyn) saw_ub = true;
    // THE GRANT INSTANT, CHECKED DIRECTLY.  A grant a whole microcycle early
    // shows up in a microcycle's *length* as five nanoseconds --- the
    // magnitude of a bug and the magnitude of its symptom are not the same
    // thing --- so a length tolerance sized to this testbench's own tick can
    // blind the check to an error two orders larger. It did: the mutant
    // `the-grant-comes-a-microcycle-early` was caught on one row at -5 ns and
    // survived the moment the tolerance admitted -5. So the instant is
    // compared to muir's rather than inferred from what it does.

    // WHERE THE FABRIC'S OWN -MEMACK LANDS, against muir's: read before this
    // tick's edge, below, once the inputs are driven.  See `kInstrumentSlipNs`.

    if (bus_outstanding && dut->unibus) {
      was_unibus = true;
      stuck_phys = dut->phys;
    }
    if (bus_outstanding && dut->nxm) was_nxm = true;
    const long answer_tick =
        ack_at_tick - (dut->mem_write ? 0 : kXbusAckNs / kTickNs);
    if (lat_hi > 0 && !quux_machine) {
      // The CADR's main memory at the boards' latency (see `c_due`).
      if (dut->mem_req && bus_outstanding) {
        if (c_due < 0) {
          c_due = t + lat_lo + static_cast<long>(q_rng() % static_cast<uint32_t>(lat_hi - lat_lo + 1));
          c_word = static_cast<uint32_t>(rdata_for[k < total_rows ? k : 0]);
          lat_longest = std::max(lat_longest, c_due - t);
          ++lat_draws;
          ++c_requests;
          lat_drawn.insert(c_due - t);
        }
        if (t >= c_due) {
          dut->mem_done = 1;
          dut->mem_rdata = c_word;
        } else {
          dut->mem_rdata = ~c_word;
        }
      } else if (!dut->mem_req) {
        c_due = -1;
      }
    } else if (dut->mem_req && bus_outstanding && t >= answer_tick) {
      dut->mem_done = 1;
    }
    // **THE XBUS DEVICES WERE ANSWERED FROM THE TRACE HERE, AND THAT LINE IS
    // GONE.**  It raised `device_ack` whenever the decode said the cycle was
    // a device's, at the instant muir's own responder answered, with
    // `device_rdata` handed muir's word --- and it answered every one of this
    // program's 16,951 device cycles.  Its own comment called that stimulus
    // rather than a model, and it was: the fabric had no disk controller.  It
    // has one now, `rtl/machine/cadr_disk_controller.sv` inside `cadr_machine`, so
    // `device_ack` stays low here and the four registers answer for
    // themselves.  MD is compared every microcycle, so an answer at the wrong
    // instant, or a status word that is not `0x2321`, fails on the row it
    // happens on.
    //
    // Deleted rather than commented out or left unused, which is the whole
    // lesson of the `md` trap: a testbench that goes on supplying the right
    // answer leaves the new module unchecked and every check green.  POISON
    // ON A WRITE.  -LOADMD is asserted on every acknowledgment and it is
    // RDCYC on the processor's side that keeps a write from strobing MD.
    // Handing back the word MD should hold makes that gate unobservable ---
    // an extra load is then a no-op, and dropping the gate survives, measured
    // --- so a write cycle gets the complement instead. Nothing should take
    // it. Keyed off the DUT's own WRCYC, which is safe here in a way a shadow
    // memory would not be: it chooses poison, never data, so a processor that
    // had the direction wrong takes poison and says so.
    //
    // The seam's own poison is in `drive` above and stands on every
    // microcycle rather than only on a write, because the disk controller
    // answers device reads now and a seam that went quiet would let a module
    // that stopped driving read back something plausible.
    if (dut->wrcyc) {
      dut->mem_rdata = ~static_cast<uint32_t>(rdata_for[k < total_rows ? k : 0]);
    }
    // Only a read takes a word: -LOADMD is gated by RDCYC, so a write must
    // not consume one. Using the DUT's own RDCYC to step the stimulus is safe
    // where it would not normally be, because MD is compared every
    // microcycle: a processor that got the direction wrong would take the
    // wrong word and say so on the next SRCMD.

    // Settle this tick's inputs without an edge, so that what is read here is
    // what the edge about to come takes.
    dut->eval();
    // The acknowledgment, measured at `ns_now`: see `kInstrumentSlipNs`.
    auto measure_ack = [&](long ns_now) {
      acked_armed = false;
      const long slip = static_cast<long>(ack_for_cur) - ns_now;
      ack_error[slip]++;
      if (slip != 0 && ack_error[slip] <= 3 && lat_hi == 0)
        std::fprintf(stderr, "microcycle %zu: -MEMACK %+ld ns from muir's, the cycle started at row %ld\n",
                     k, slip, armed_row);
      // The yardstick itself: a cycle the disk controller answered, whose
      // grant and length already agree with muir exactly, reads the
      // same zero and nothing else.  If it does not, the zero the NXM
      // leg below requires stops meaning agreement.
      // **A DEVICE CYCLE THE DDR BRIDGE ANSWERS IS NOT THE YARDSTICK.**  A
      // display's frame buffer is a device on the Xbus and a window onto the
      // bridge, so its acknowledgment is this testbench's DDR placement,
      // rounded to its tick like main memory's, and not a slave's own.  MIT's
      // boot PROM never touches the frame buffer; the display's programs of
      // `golden/src/quux.rs` do, and the length check still holds every one.
      if (dev_cycle && !cur_nxm && !pack_trace && !saw_mem_req) {
        ++dev_acks_measured;
        if (slip != kInstrumentSlipNs) {
          if (!dev_ack_wrong)
            std::fprintf(stderr,
                         "FAIL: a device cycle the disk controller answered "
                         "read %+ld ns from muir, wanting "
                         "%+ld\n",
                         slip, static_cast<long>(kInstrumentSlipNs));
          ++dev_ack_wrong;
        }
      }
      // Under `LAT_HI` the oscillator's phase against the microcycles moves
      // with every wait muir does not model, so the NXM timer's instant is
      // one of the acknowledgments counted below, not this witness.
      if (cur_nxm && !pack_trace) {
        ++nxm_acks;
        if (slip != kNxmAckSlipNs && lat_hi == 0) {
          std::fprintf(stderr,
                       "FAIL: the NXM timer ended a cycle %+ld ns from muir, "
                       "wanting %+ld --- the timeout oscillator free-runs from "
                       "reset, so its phase is the reset release's\n",
                       slip, static_cast<long>(kNxmAckSlipNs));
          ++nxm_ack_wrong;
        }
      }
        };
    // **AN ACKNOWLEDGMENT IN THE TICK THAT GRANTS THE CYCLE** (QUUX's empty
    // address, contract Q7) is read here before the edge that arms its row,
    // so it is kept and measured once the edge has armed it, below.
    const bool ack_low_pre = !dut->n_memack_o;
    const long ns_pre = static_cast<long>(prev_ns) + (t - last_edge) * kTickNs;
    if (acked_armed && ack_low_pre) measure_ack(ns_pre);

    dut->clk = 1;
    dut->eval();
    if (have_disk && dut->ch_wrote) pk_dirty[dut->ch_slot] = true;

    if (dev_cycle && bus_outstanding && !dut->n_memack_o) {
      if (dut->timed_out) {
        if (!dev_acked) ++device_timeouts;
      } else if (!dev_acked) {
        ++device_answers;
      }
      dev_acked = true;
    }

    if (bus_outstanding && !dut->mem_req && !dut->dev_rq && t > ack_at_tick) {
      bus_outstanding = false;
    }

    // The bus cycle row `k` starts, and when the interface will answer:
    // `ns_at_t` is muir's instant for this tick.  Called at the row's own
    // edge, or earlier where the cycle starts inside a microcycle that is
    // held --- QUUX's divider holds a `DIV` over the master clock edges its
    // read goes out on --- so that the answer is placed from the instant the
    // cycle really started.
    auto arm_bus = [&](const Row &r, uint64_t ns_at_t, bool at_row_edge) {
      ++grants_checked;
      bus_outstanding = true;
      if (lat_hi > 0) {
        lat_cycles.push_back({k, dut->phys, dut->device != 0, dut->wrcyc != 0, dut->nxm != 0});
        if (lat_cycles.size() > 64) lat_cycles.pop_front();
      }
      // **THE WORD A WRITE CARRIES IS `MD` AS IT STANDS AT THE GRANT.**  A
      // cycle granted at the edge that ends row `k` takes the `MD` that edge
      // has just loaded, so an `MD` loaded by row `k` itself --- the
      // microcycle after the start --- is the word written (muir's
      // `chip_and_rtl_write_the_md_of_the_microcycle_after_the_start`), and
      // that is the next row's column.  A cycle granted inside a held row
      // takes that row's own.
      const uint64_t word =
          (at_row_edge && k + 1 < total_rows) ? md_at_row[k + 1] : md_at_row[k];
      // THE WORD AT THE XBUS SEAM.  `dev_wdata` is a register of its
      // own --- `wdata <= md` at the edge that starts the cycle --- so MD
      // being compared every microcycle says nothing about it, and a slave
      // hung here would be the first thing to notice it was wrong. The
      // reference is the trace's own MD column at the grant, `word` above,
      // which is muir's and not the DUT's.
      //
      // **AND ON THIS PROGRAM IT SAYS ONLY THAT THE WORD IS ZERO.**  All
      // 5,650 device writes the boot PROM makes carry the same word, and
      // that word is zero --- the count is on this check's own output for
      // that reason.  So any bijection on the bits is invisible here: a
      // rotation of `dev_wdata` survives, measured, and is an equivalence
      // *on this trace* rather than in general.  Same shape as the control
      // store's all-zero pass, and the same answer: what catches a wiring
      // fault here is a mutation that makes a nonzero word out of a zero
      // one, and what would catch a bijection is a trace that writes
      // something else.
      if (dut->device && dut->wrcyc) {
        ++dev_writes_checked;
        dev_words[dut->dev_wdata]++;
        if (dut->dev_wdata != (word & 0xFFFFFFFFull))
          bad += Fail(r, "the word at the Xbus seam", dut->dev_wdata, word & 0xFFFFFFFFull);
      }
      dev_cycle = dut->device;
      dev_acked = false;
      // A write of QUUX's main memory or frame buffer is owed to it, the
      // word the trace's MD column says the cycle carries.
      if (quux_machine && dut->wrcyc &&
          ((!dut->device && !dut->nxm && !dut->unibus) || q_fb(dut->phys)))
        q_owed.emplace_back(dut->phys, rev13 ? word : static_cast<uint32_t>(word));
      cur_nxm = dut->nxm;
      if (dut->device) ++device_cycles;
      else if (!dut->nxm && !dut->unibus) ++mem_cycles;
      acked_armed = ack_for[k] != 0;
      ack_for_cur = ack_for[k];
      saw_mem_req = false;
      saw_device = false;
      saw_ub = false;
      // Rounded *up*: a memory board answers on its own refresh clock, so
      // muir's acknowledgment is not on the five-nanosecond grid, and the
      // fabric can only see it at a tick at or after it. Truncating instead
      // ends a wait one 220 ns cycle early wherever the acknowledgment
      // falls within a tick of a master clock edge.
      ack_at_tick =
          t + static_cast<long>((ack_for[k] - ns_at_t + kTickNs - 1) / kTickNs);
      armed_row = static_cast<long>(k);
      ++cycles_run;
    };

    // **A CYCLE THAT STARTS INSIDE A HELD MICROCYCLE**: the grant falls at a
    // master clock edge that is not the row's own, and the row's cycle is
    // armed there.  Only QUUX's divider holds a microcycle over the edge its
    // own read goes out on; on the CADR the grant falls at the row's edge,
    // which the check at that edge holds.
    if (!dut->clock_edge && prev_n_memgrant && !dut->n_memgrant_o && k < total_rows &&
        cur.v[kBus] && armed_row != static_cast<long>(k)) {
      ++early_grants;
      arm_bus(cur, prev_ns + static_cast<uint64_t>(t - last_edge) * kTickNs, false);
      if (acked_armed && ack_low_pre) measure_ack(ns_pre);
    }

    if (dut->clock_edge) {
      const Row &r = cur;

      if (prev.pc != r.v[kPc]) bad += Fail(r, "PC", prev.pc, r.v[kPc]);
      if (prev.ir != r.v[kIr]) bad += Fail(r, "IR", prev.ir, r.v[kIr]);
      if (prev.lpc != r.v[kLpc]) bad += Fail(r, "LPC", prev.lpc, r.v[kLpc]);
      if (prev.opc != r.v[kOpc]) bad += Fail(r, "OPC", prev.opc, r.v[kOpc]);
      if (prev.st != r.v[kSt]) bad += Fail(r, "ST", prev.st, r.v[kSt]);
      if (prev.a != r.v[kA]) bad += Fail(r, "the A bus", prev.a, r.v[kA]);
      if (prev.lc != r.v[kLc]) bad += Fail(r, "LC", prev.lc, r.v[kLc]);
      if (prev.m != r.v[kM]) bad += Fail(r, "the M bus", prev.m, r.v[kM]);
      if (prev.alu != r.v[kAlu]) bad += Fail(r, "the ALU", prev.alu, r.v[kAlu]);
      if (prev.r != r.v[kR]) bad += Fail(r, "R", prev.r, r.v[kR]);
      if (prev.ob != r.v[kOb]) bad += Fail(r, "OB", prev.ob, r.v[kOb]);
      if (prev.q != r.v[kQ]) bad += Fail(r, "Q", prev.q, r.v[kQ]);
      if (prev.dc != r.v[kDc]) bad += Fail(r, "DC", prev.dc, r.v[kDc]);
      if (prev.jcond != r.v[kJcond])
        bad += Fail(r, "JCOND", prev.jcond, r.v[kJcond]);
      if (prev.vma != r.v[kVma]) bad += Fail(r, "VMA", prev.vma, r.v[kVma]);
      if (prev.md != r.v[kMd]) bad += Fail(r, "MD", prev.md, r.v[kMd]);
      // The mode register is no longer handed to the machine: it is written
      // over the Unibus by the machine itself, which is the whole point of
      // the register block.
      if (prev.promdis != r.v[kPromdis])
        bad += Fail(r, "PROMDISABLE", prev.promdis, r.v[kPromdis]);
      // The net is -VMAOK, `NAND(-PFR, -PFW)` at VCTL1 1D17: *low* when the
      // access is permitted, the opposite of the logical VMAOK the jump
      // conditions and MEMRQ take.
      if (prev.vmaok == r.v[kNVmaok])
        bad += Fail(r, "-VMAOK", !prev.vmaok, r.v[kNVmaok]);
      if (prev.nop != r.v[kNop]) bad += Fail(r, "NOP", prev.nop, r.v[kNop]);
      if (prev.pcs1 != r.v[kPcs1]) bad += Fail(r, "PCS1", prev.pcs1, r.v[kPcs1]);
      if (prev.pcs0 != r.v[kPcs0]) bad += Fail(r, "PCS0", prev.pcs0, r.v[kPcs0]);
      if (prev.iwrited != r.v[kIwrited])
        bad += Fail(r, "IWRITED", prev.iwrited, r.v[kIwrited]);
      // **-XBUS.INTR, WHICH USED TO BE STIMULUS.**  muir samples `SINTR`
      // after the step --- `Machine::xbus_interrupt()`, the disk's request
      // ORed with the display's, as the 74S175 at LCC 3E12 registers it on
      // CLK3C --- so the reference is the value at the end of the microcycle,
      // which is what `prev` holds.  The fabric makes the same OR out of its
      // own two slaves and `sintr_o` is the line.
      //
      // **THE COLUMN IS ZERO ON ALL 600,000 ROWS AND THE ZERO IS A LIVE
      // ONE.**  The boot PROM never writes the disk's command register and
      // never enables the display, so both enables are off --- but the
      // controller answers 11,301 status reads with `0x2321`, `<0>` set, so
      // NOT-ACTIVE, the interrupt's other term, is true throughout.  A fabric
      // that ignored the enable, or that inverted either half of the gate,
      // raises the line here and fails on the first row.  The count below
      // says how many rows carried a live not-active, so that a run where the
      // controller stopped answering could not pass this quietly.
      if (prev.sintr != r.v[kSintr])
        bad += Fail(r, "-XBUS.INTR", prev.sintr, r.v[kSintr]);
      ++sintr_checked;
      if (prev.sintr) ++sintr_raised;
      // The disk's status with nothing on the cable and no command: the
      // CADR controller's 0x2321, or on QUUX block-disk's 0x201, not-active
      // and no pack (`quux15_devices.sv`'s word 200).
      if (r.v[kMd] == (quux_prom ? 0x201u : 0x2321u)) ++status_rows;

      // The microcycle's own length.  muir charges the stall before the
      // cycle and the cycle after it, so what the generator owes is the
      // interval less the stall.  Nothing here raises -HANG --- VCTL1 is
      // slice 5 --- so the DUT runs the cycles back to back and the stall is
      // arithmetic rather than a driven input.
      if (last_edge >= 0) {
        const uint64_t before = prev_ns;
        // The stall is no longer subtracted: VCTL1 decides it now, so the
        // whole interval between boundaries is the fabric's own answer.
        const uint64_t want = r.v[kNs] - before;
        const uint64_t got = static_cast<uint64_t>(t - last_edge) * kTickNs;
        if (got != want) {
          const long slip = static_cast<long>(got) - static_cast<long>(want);
          if (arbitrated[k]) {
            ++arb_skipped;
          } else if (r.v[kStall] && slip > -kTickNs && slip < kTickNs) {
            ++sub_tick;
            if (!any_slip || slip > worst_slip) worst_slip = slip;
            if (!any_slip || slip < best_slip) best_slip = slip;
            any_slip = true;
          } else if (lat_hi > 0) {
            ++lat_lengths;
          } else {
            bad += Fail(r, "the microcycle in ns", got, want);
          }
        }
        ++lengths_checked;
      }
      if (r.v[kStall]) ++stalls;
      // The bus cycle this edge started, and when the interface will answer.
      // A cycle the fabric cannot answer: the decode did not select main
      // memory and no slave inside the machine claims the address. THE FABRIC
      // HAS THE DISK CONTROLLER'S FOUR REGISTERS AND NOTHING ELSE ON THE
      // XBUS --- no display, no I/O board, no Unibus --- so the machine runs
      // until the program touches one of those, and stops there rather than
      // diverging.
      // An NXM is not unanswerable: nothing is meant to answer it, muir's
      // interface times it out and so does the fabric's. Only a cycle
      // addressed to a bus the fabric does not have stops the run.
      if (saw_ub) ++ub_cycles;
      // Not before the cycle has had its time. A Unibus cycle arbitrates for
      // five master clocks before -UB MSYN goes out, so a detector that gave
      // up one microcycle after the request would call every one of them
      // unanswerable --- which it did, and reported nought Unibus cycles
      // while the arbitration was working.
      if (bus_outstanding && t > ack_at_tick + 40 && !saw_mem_req &&
          !saw_device && !saw_ub && was_unibus) {
        unanswerable = k;
        stopped_because = was_unibus  ? "it is addressed to the Unibus, and "
                                        "cadr_busint_xbus.sv is the Xbus half"
                          : was_nxm   ? "it is Xbus space with nothing in it, "
                                        "which should have timed out"
                                      : "nothing on the bus answered it";
        break;
      }
      // muir grants at the edge the cycle starts on --- `Rtl::clock_edge`
      // calls `Busint::request` and `Busint::mclk_edge` there --- so the
      // fabric's -MEMGRANT must fall at this edge and not at an earlier one.
      if (r.v[kBus] && armed_row != static_cast<long>(k)) {
        if (!prev_n_memgrant) {
          std::fprintf(stderr,
                       "microcycle %" PRIu64 ": -MEMGRANT was already out "
                       "before the edge this cycle starts on\n",
                       r.v[kCycle]);
          ++bad;
        }
        arm_bus(r, r.v[kNs], true);
        if (acked_armed && ack_low_pre) measure_ack(ns_pre);
      }
      if (r.v[kLc]) ++lc_moved;
      if (r.v[kPromdis]) ++promdis_rows;
      a_values.insert(r.v[kA]);
      m_values.insert(r.v[kM]);
      ob_values.insert(r.v[kOb]);
      // SRCMAP is group B source 1, and its word is handed to the DUT.
      if (r.v[kNop] == 0 && ((r.v[kIr] >> 31) & 1) && ((r.v[kIr] >> 29) & 1) &&
          (((r.v[kIr] >> 26) & 7) == 1))
        ++map_sources;
      // Extra slow is {SPEED1,SPEED0} = 00, where both taps of the 74S151 are
      // -TPR160 and ILONG changes nothing.  Asserted rather than assumed, so
      // that a trace which does change speed re-opens the claim below.
      if (r.v[kSpeed1] || r.v[kSpeed0]) ++other_speed;

      // What the program reaches, and what it does not.
      if (r.v[kNop] == 0) {
        const uint64_t cls = (r.v[kIr] >> 43) & 3;
        const uint64_t funct = (r.v[kIr] >> 10) & 3;
        if (cls == 2) {
          ++dispatches;
          // DISPWR is misc function 2, which is what makes the dispatch a
          // write of the memory rather than a read of it.  If this ever
          // fails the dispatch memory is being read and slice 1 cannot
          // answer for where the machine goes next.
          if (funct != 2) ++disp_reads;
        }
        if (cls == 1 && ((r.v[kIr] >> 8) & 3) == 3) ++iwrites;
        // QS<1:0> of 1 or 2 is a shift; 3 is the load, which the boot PROM
        // does five times and nothing else.
        if (cls == 0) {
          const uint64_t qs = r.v[kIr] & 3;
          if (qs == 1 || qs == 2) ++q_shifts;
        }
        if ((r.v[kIr] >> 45) & 1) ++ilongs;
        if (((r.v[kIr] >> 46) & 1) != 0) ++stat_counts;
      }
      if (r.v[kPcs1] == 0 && r.v[kPcs0] == 0) ++popjs;
      if (r.v[kPcs1] == 0 && r.v[kPcs0] == 1) ++jumps;
      if (r.v[kSrun] == 0 || r.v[kHalted] != 0) ++halts;
      // -PROMENABLE at PCTL 1C19.  Everything else comes out of the control
      // store RAM, which here is every WRITE-I-MEM reading back the word its
      // own write pulse has just put there.
      // On QUUX the PROM has addresses of its own, 36000-37777, and no
      // disable bit (contract Q2).
      const bool in_prom = quux_prom ? (r.v[kPc] >= 036000u && r.v[kIwrited] == 0)
                                     : (r.v[kPc] < 1024 && r.v[kPromdis] == 0 && r.v[kIwrited] == 0);
      if (in_prom)
        ++prom_fetches;
      else
        ++ram_fetches;
      // ...and none of them is the machine *running* the microcode it has
      // loaded: this program never gets past the disk wait to `JUMP-TO-6`,
      // so PROMDISABLE is never set and every fetch above the PROM is a
      // write-back.  Said here so the gap is on the check's own output.
      // On QUUX, a microcycle run from the RAM below the PROM, the trap's
      // nopped fetch at 0 aside.
      if (quux_prom ? (r.v[kIwrited] == 0 && r.v[kPc] < 036000u && r.v[kNop] == 0)
                    : (r.v[kIwrited] == 0 && r.v[kPc] >= 1024))
        ++ram_executes;

      last_edge = t;
      prev_ns = r.v[kNs];
      if (lat_hi > 0 && bad > 0 && lat_first_bad < 0) {
        lat_first_bad = static_cast<long>(k);
        lat_before_bad = lat_cycles;
        lat_bad_fabric_ns = static_cast<uint64_t>(t) * kTickNs;
        lat_bad_muir_ns = cur.v[kNs];
      }
      ++k;
      if (k < total_rows) {
        if (!read_next(cur)) {
          std::fprintf(stderr, "FAIL: %s: ran out of rows at %zu of %zu\n",
                       path, k, total_rows);
          return 1;
        }
        drive(cur, k);
      }

      // Twenty mismatches and it stops, unless `CADR_TB_MISMATCHES` asks for
      // more: a run kept going to list every row a known difference reaches.
      if (bad >= max_bad) {
        std::fprintf(stderr, "stopping after %d mismatches\n", bad);
        break;
      }
    }

    dut->clk = 0;
    dut->eval();
    prev = take();
    prev_n_memgrant = dut->n_memgrant_o;
  }

  if (!chaos_txdone.empty()) {
    std::printf("    the Chaosnet's far end: %zu of %zu Transmit Done rises played at muir's instants\n",
                txdone_next, chaos_txdone.size());
    if (txdone_next != chaos_txdone.size()) {
      std::fprintf(stderr, "FAIL: the far end did not raise Transmit Done every time muir's interface did\n");
      ++bad;
    }
  }
  if (!fd_done.empty() || !rtc_sets.empty() || have_rtc) {
    std::printf("    revision 9's host: the clock %s, %zu set at a microcycle; %zu of %zu completions "
                "played at muir's instants, %zu of %zu commands shown to it, %ld words of their "
                "entries found in main memory as the processor wrote them\n",
                have_rtc ? "loaded at reset" : "not loaded", rtc_sets.size(), fd_played, fd_done.size(),
                take_next, fd_takes.size(), entry_words_checked);
    if (fd_played != fd_done.size() || take_next != fd_takes.size()) {
      std::fprintf(stderr, "FAIL: the file device's host did not see every command muir's did\n");
      ++bad;
    }
    if (fd_refused_seen) {
      std::fprintf(stderr, "FAIL: a completion the host wrote was refused (STATE <5>)\n");
      ++bad;
    }
    if (!fd_done.empty() && !fd_busy_seen) {
      std::fprintf(stderr, "FAIL: the host's claim never read back busy\n");
      ++bad;
    }
  }
  if (quux_machine) {
    std::printf("    QUUX's main memory: %ld line fills and %ld writes answered here, %ld and %ld "
                "of them the frame buffer's, %zu writes still owed\n", q_fills, q_writes,
                q_fb_fills, q_fb_writes, q_owed.size());
    if (rev13)
      std::printf("    revision 13: packed storage at %08x, %ld writes of words across two beats\n",
                  kMain13Base, q13_spanning);
    if (rev14)
      std::printf("    revision 14: %ld line fills of the walk's and the write-backs' reads, %ld table words "
                  "written back\n", side_fills, side_writes);
    if (have_disk) {
      std::printf("    block-disk: the pack side served %ld blocks, wrote %ld back and denied %ld; the "
                  "channel read %ld words, %ld of them of two beats, and wrote %ld\n",
                  pk_served, pk_written_back, pk_denied, ch13_reads, ch13_two_beats, ch13_writes);
      // What the disk program is for: pages moved both ways through the
      // port, and words that span two beats among them.
      if (pk_served < 10 || ch13_reads < 2048 || ch13_writes < 3072 || ch13_two_beats < 100) {
        std::fprintf(stderr, "FAIL: the transfers reached too little of the channel\n");
        ++bad;
      }
    }
    // The write buffer holds one write; every other write a cycle made has
    // reached DDR, where the scanout reads the frame buffer's.
    if (q_owed.size() > 1) {
      std::fprintf(stderr, "FAIL: %zu writes never reached DDR, where the write buffer holds one\n",
                   q_owed.size());
      ++bad;
    }
  }
  std::printf("    -MEMACK against muir, in nanoseconds (muir minus fabric):\n");
  long ack_slipped = 0;
  for (const auto &e : ack_error) {
    std::printf("             %+5ld ns  %ld cycles\n", e.first, e.second);
    if (e.first != kInstrumentSlipNs) ack_slipped += e.second;
  }
  if (lat_hi > 0 && lat_first_bad >= 0) {
    std::printf("    the first row that disagreed: %ld, at %" PRIu64 " ns of the fabric's time and %" PRIu64
                " of muir's; the bus cycles started before it:\n", lat_first_bad, lat_bad_fabric_ns, lat_bad_muir_ns);
    for (const auto &c : lat_before_bad)
      if (static_cast<long>(c.row) + 40 >= lat_first_bad)
        std::printf("      row %zu: %s %s at %o%s\n", c.row, c.write ? "write" : "read",
                    c.device ? "of a device" : c.nxm ? "of nothing (NXM)" : "of main memory", c.phys, "");
  }
  if (lat_hi > 0) {
    if (quux_machine)
      std::printf("    revision 13's line fills answered after muir's acknowledgment of their own cycle: %ld\n",
                  lat_late_fills);
    else
      std::printf("    the CADR's bridge: %ld requests of main memory answered here at the drawn latency\n",
                  c_requests);
    std::printf("    main memory at %ld to %ld ticks (seed %s, %ld drawn, %zu distinct, the longest %ld): %ld "
                "microcycle lengths and %ld acknowledgments differ from muir's, as a wait muir does not model "
                "makes them\n",
                lat_lo, lat_hi, std::getenv("LAT_SEED") ? std::getenv("LAT_SEED") : "the harness's", lat_draws,
                lat_drawn.size(), lat_longest, lat_lengths, ack_slipped);
    // **A SWEEP THAT DREW NOTHING TESTED NOTHING.**  Main memory's cycles were
    // counted at their grants, so a mode that read the range and answered
    // them at muir's instants anyway reads none drawn here, or one latency
    // for all of them, where the range has more than one.
    if (!quux_machine && mem_cycles > 0 && (c_requests == 0 || (c_requests > 1 && lat_hi > lat_lo && lat_drawn.size() < 2))) {
      std::fprintf(stderr, "FAIL: %ld cycles of main memory, and the bridge's requests drew %ld latencies, %zu "
                   "distinct\n", mem_cycles, c_requests, lat_drawn.size());
      ++bad;
    }
  } else if (ack_slipped) {
    std::fprintf(stderr, "FAIL: %ld acknowledgments are not at muir's instant\n", ack_slipped);
    ++bad;
  }

  // **THE TRANSACTION AUDIT, READ AT THE END OF EVERY RUN, THROUGH THE WINDOW
  // A HALTED BOARD IS READ THROUGH.**  `rtl/plumbing/cadr_bus_audit.sv` sits
  // inside `cadr_machine` in every check this testbench runs, and before this
  // nothing here looked at it: `build/bus_audit.pass` runs MIT's boot PROM,
  // which never touches a display's frame buffer, so a cycle the bridge
  // answers at a display's base reached the audit in no check at all.  The
  // video controller's buffer is one, and `quux_tv` writes and reads it, so
  // a memory flag that forgot it faulted on every such cycle and every check stayed
  // green.  Any fault here is the finding; the port's own answers are not
  // driven, so the seventh clause is silent by construction and is not what
  // this holds.  Word 0 is the fault count, word 1 the first clause and the
  // address it was taken at (`cadr_bus_audit.sv`'s readout).
  {
    auto window = [&](unsigned word) -> uint64_t {
      const unsigned asked = (11u << 14) | word;
      dut->con_ro_addr = asked;
      for (int i = 0; i < 4; ++i) {
        dut->clk = 0;
        dut->eval();
        dut->clk = 1;
        dut->eval();
      }
      if (dut->con_ro_echo != asked || (dut->con_ro_data >> 32) != 0xB05Au) {
        std::fprintf(stderr,
                     "FAIL: the audit's word %u came back echo %05x, %012" PRIx64
                     ", which is not the audit's\n",
                     word, static_cast<unsigned>(dut->con_ro_echo),
                     static_cast<uint64_t>(dut->con_ro_data));
        return ~0ull;
      }
      return dut->con_ro_data;
    };
    const uint64_t w0 = window(0), w1 = window(1);
    const unsigned faults = static_cast<unsigned>(w0 & 0x7FFFu);
    // **A CHANNEL'S WORD IS NOT A FAULT, AND THIS IS WHERE THAT IS HELD.**
    // The arbiter's idle tick at a change of owner closes one cycle, and the
    // channel's request rises in the very tick after it, the tick its cycle
    // opens: an Xbus cycle is opened BY its request.  The audit used to judge
    // that request against the cycle state it had registered, a tick behind,
    // and counted clause 4 on every channel word --- 5,130 of them on
    // revision 13's `disk`, the only machine trace with transfers.  Zero
    // faults here, with the channel's word count printed beside it, is what
    // says the audit judges a request against the cycle it opens.
    const unsigned channel_words = static_cast<unsigned>(ch13_reads + ch13_writes);
    if (w0 == ~0ull || w1 == ~0ull || faults != 0) {
      std::fprintf(stderr,
                   "FAIL: the transaction audit counted %u faults, the first "
                   "clause %u at word %o (clauses seen %02x)\n",
                   faults, static_cast<unsigned>((w1 >> 22) & 7u),
                   static_cast<unsigned>(w1 & 0x3FFFFFu),
                   static_cast<unsigned>((w1 >> 25) & 0x7Fu));
      ++bad;
    } else if (channel_words != 0) {
      std::printf("    the transaction audit counted no fault, over the channel's %u words\n",
                  channel_words);
    } else {
      std::printf("    the transaction audit counted no fault\n");
    }
  }

  // **WHICH REVISION OF QUUX, AND THE FILE DEVICE'S BASES, THROUGH THE SAME
  // WINDOW** (`cadr-readout`'s reading of a halted board): the register
  // table's entry 21 is QUUX's signature over K and L, and in `<15:0>`
  // MACHINE-ID's low half on revision 13, `0x00D4`, and 0 on revision 12;
  // and on revision 13 the register page's readout gives the command ring's
  // base at word 7 and the response ring's at word 10, 28 bits each, as muir's
  // device holds them when the program ends.
  if (quux_machine) {
    auto readout = [&](unsigned sel, unsigned word) -> uint64_t {
      const unsigned asked = (sel << 14) | word;
      dut->con_ro_addr = asked;
      for (int i = 0; i < 4; ++i) {
        dut->clk = 0;
        dut->eval();
        dut->clk = 1;
        dut->eval();
      }
      if (dut->con_ro_echo != asked) {
        std::fprintf(stderr, "FAIL: the readout's echo %05x for %05x\n",
                     static_cast<unsigned>(dut->con_ro_echo), asked);
        ++bad;
      }
      return dut->con_ro_data;
    };
    const uint64_t id = readout(10, 21);
    const uint64_t want_low = rev14 ? 0x00E4u : rev13 ? 0x00D4u : 0u;
    if ((id >> 32) != 0x5155u || (id & 0xFFFFu) != want_low) {
      std::fprintf(stderr, "FAIL: the register table's entry 21 reads %012" PRIx64 ", want 5155 over "
                   "K and L and %04" PRIx64 " in <15:0>\n", id, want_low);
      ++bad;
    }
    if (rev13) {
      const uint64_t w7 = readout(12, 7), w10 = readout(12, 10);
      if (w7 != fd_cmd_base_end || w10 != fd_resp_base_end || !have_fd_bases) {
        std::fprintf(stderr, "FAIL: the register page's readout words 7 and 10 read %" PRIx64 " and %"
                     PRIx64 ", muir's device's bases %" PRIx64 " and %" PRIx64 "%s\n", w7, w10,
                     fd_cmd_base_end, fd_resp_base_end, have_fd_bases ? "" : " (the trace has none)");
        ++bad;
      } else {
        std::printf("    the readout: entry 21 %012" PRIx64 ", the file device's bases %" PRIx64 " and %"
                    PRIx64 "\n", id, w7, w10);
      }
    }
    if (rev14) {
      // Entries 41 to 45: {221 <0>, 220}, 222, 223, 224, and the copies,
      // the head over the base.
      const uint64_t e41 = readout(10, 41), e42 = readout(10, 42), e43 = readout(10, 43),
                     e44 = readout(10, 44), e45 = readout(10, 45);
      const uint64_t want45 = (copies_head_end << 32) | copies_base_end;
      if (!have_ms || !have_copies || e41 != ms_dir_end || e42 != (ms_types_end & 0xFFFFFFFFu) ||
          e43 != (ms_types_end >> 32) || e44 != ms_refused_end || e45 != want45) {
        std::fprintf(stderr, "FAIL: the readout's entries 41 to 45 read %" PRIx64 " %" PRIx64 " %" PRIx64
                     " %" PRIx64 " %" PRIx64 ", muir's %" PRIx64 " %" PRIx64 " %" PRIx64 " %" PRIx64
                     " %" PRIx64 "%s\n", e41, e42, e43, e44, e45, ms_dir_end, ms_types_end & 0xFFFFFFFFu,
                     ms_types_end >> 32, ms_refused_end, want45,
                     have_ms && have_copies ? "" : " (the trace has none)");
        ++bad;
      } else {
        std::printf("    the readout: the memory system's words %" PRIx64 " %" PRIx64 " %" PRIx64 " %" PRIx64
                    ", the redirect's copies %" PRIx64 "\n", e41, e42, e43, e44, e45);
      }
    }
  }

  dut->final();
  delete dut;

  if (bad) {
    std::fprintf(stderr, "FAIL: %d mismatches over %zu microcycles\n", bad, k);
    return 1;
  }
  if (unanswerable) {
    std::printf(
        "ok: %zu microcycles of the whole machine agree with muir's rtl "
        "engine\n"
        "    %s, and it stops there rather than diverging: at that\n"
        "    microcycle the program touches something that is not main\n"
        "    memory at %o: %s.\n"
        "    Up to there: %ld Unibus cycles, and %ld bus cycles through the\n"
        "    fabric's own decode,\n"
        "    bus interface and DDR bridge; MD strobed by that interface and\n"
        "    compared every microcycle; every microcycle length the fabric's\n"
        "    own, stalls included.\n",
        unanswerable, pack_trace ? "on a System 100 band" : "on MIT's boot PROM",
        stuck_phys, stopped_because, ub_cycles, cycles_run);
    return 0;
  }
  if (k != total_rows) {
    std::fprintf(stderr,
                 "FAIL: the run stopped after %zu of %zu microcycles --- the "
                 "generator is not making a boundary\n",
                 k, total_rows);
    return 1;
  }

  // A run that agreed everywhere while reaching nothing would pass and mean
  // nothing.  These are what it has to have reached, and what it has to have
  // left alone for the holes above to be the size they are claimed to be.
  int thin = 0;
  if (disp_reads && !pack_trace && !dispatch_trace) {
    std::fprintf(stderr,
                 "FAIL: %ld dispatches are not DISPWR, so the dispatch memory "
                 "is read and the NPC mux has an answer this slice cannot give\n",
                 disp_reads);
    ++thin;
  }
  if (halts) {
    std::fprintf(stderr,
                 "FAIL: the machine halted on %ld microcycles; MACHRUN going "
                 "down is not modeled here\n",
                 halts);
    ++thin;
  }
  if (stat_counts) {
    std::fprintf(stderr,
                 "FAIL: %ld microcycles carry IR<46>; the statistics counter "
                 "is claimed unexercised\n",
                 stat_counts);
    ++thin;
  }
  if (lc_moved && !pack_trace && !dispatch_trace) {
    std::fprintf(stderr,
                 "FAIL: LC is nonzero on %ld microcycles; it is claimed "
                 "constant zero, which is what makes its check vacuous\n",
                 lc_moved);
    ++thin;
  }
  // A fraction of a percent is the Unibus showing through --- the pack trace
  // talks to the disk, and 347 of its 141,849 bus cycles arbitrate. A tenth
  // of them would mean the exemption had become the rule and was covering
  // something other than the missing Unibus path.
  if (!script_trace && unibus_cycles * 100 > cycles_run) {
    std::fprintf(stderr,
                 "FAIL: %ld of %ld bus cycles arbitrated for the Unibus; the "
                 "length check exempts those and cannot exempt that share\n",
                 unibus_cycles, cycles_run);
    ++thin;
  }
  // THE TOLERANCE THIS CHECK NEEDS IS NONE.  The standalone testbench's
  // -MEMACK placement is a testbench's; here the bus interface is the
  // fabric's own and every length comes out exact, so the count below is
  // zero and the guard is set at zero.  It is the guard that was missing
  // when the same count went from 0 to 11,301 in one commit without a line
  // of output changing except the number --- which is what #12 was.
  //
  // NOT IN mutations/list.txt, and the reason is worth stating.  A record
  // there is one edit to one file, and this guard needs two to be exercised:
  // the fabric drifting a tick *and* the tolerance widened to admit it.  The
  // fabric drifting alone fails on the length outright, and the tolerance
  // widened alone changes nothing, because muir's boundaries here are all on
  // the five-nanosecond grid and no slip is ever sub-tick.  Verified by hand
  // instead, with RD_FINISH_T at 28-2 and the band below widened to two
  // ticks: 11,301 of 599,999, the number from #12, and a FAIL rather than an
  // ok line carrying it.
  if (sub_tick) {
    std::fprintf(stderr,
                 "FAIL: %ld of %ld microcycle lengths were within a tick "
                 "rather than exact; the composed machine has its own bus "
                 "interface and owes exactness, not a tolerance\n",
                 sub_tick, lengths_checked);
    ++thin;
  }
  if (dev_words.size() > 1) {
    std::fprintf(stderr,
                 "NOTE: the Xbus seam carried %zu distinct words; the check on "
                 "it is no longer vacuous and the rotation mutation should be "
                 "live again\n",
                 dev_words.size());
  }
  if (dev_writes_checked == 0 && !script_trace) {
    std::fprintf(stderr,
                 "FAIL: no device write put a word on the Xbus seam, so "
                 "`dev_wdata` is claimed correct by a check that never "
                 "looked at it\n");
    ++thin;
  }
  // **EVERY DEVICE CYCLE MUST BE THE FABRIC'S OWN ANSWER.**  Nothing outside
  // the machine drives `device_ack`, so a device cycle that got to -MEMACK
  // without the NXM timer got there through `rtl/machine/cadr_disk_controller.sv`.
  // This is the guard that would have caught the slice going backwards: a
  // testbench that started answering these again, or a decode that stopped
  // selecting the disk, both show up here as a count that is not the whole
  // 16,951 --- and a timed-out device cycle is not a quiet degradation, it is
  // a poll the machine waits 4.25 us for.
  if (!script_trace && (device_answers != device_cycles || device_timeouts)) {
    std::fprintf(stderr,
                 "FAIL: of %ld device cycles the fabric answered %ld and the "
                 "NXM timer ended %ld; every one is the disk controller's and "
                 "nothing outside the machine drives device_ack\n",
                 device_cycles, device_answers, device_timeouts);
    ++thin;
  }
  // **AND THE CYCLES THE COMPARISON ABOVE RESTS ON MUST HAVE HAPPENED.**  A
  // program that sent none would pass it by comparing nothing, which is the
  // shape this file guards everywhere else.  This one sends exactly two.
  // **QUUX'S BOOT PROM SENDS NONE**, measured on its trace at the pin: the
  // NXM leg has nothing to compare there and is held on the CADR's.
  const long want_nxm = quux_prom ? 0 : 2;
  if (nxm_ack_wrong || (nxm_acks != want_nxm && !pack_trace && !script_trace)) {
    std::fprintf(stderr,
                 "FAIL: %ld cycles ended on the NXM timer and %ld of them "
                 "acknowledged away from muir's instant; this program sends "
                 "%ld to empty Xbus space and each must land at %+d ns\n",
                 nxm_acks, nxm_ack_wrong, want_nxm, kNxmAckSlipNs);
    ++thin;
  }
  // **AND THE YARDSTICK THE NXM LEG IS READ AGAINST MUST HAVE BEEN MEASURED.**
  // The zero above means agreement only because every device cycle reads the
  // same number, so a run in which none was measured, or some were missed,
  // leaves that number standing on a comment.
  if (dev_ack_wrong ||
      (!pack_trace && !script_trace && dev_acks_measured != device_cycles)) {
    std::fprintf(stderr,
                 "FAIL: %ld of %ld device cycles were measured against muir's "
                 "acknowledgment and %ld of them read other than "
                 "%+d ns\n",
                 dev_acks_measured, device_cycles, dev_ack_wrong,
                 kInstrumentSlipNs);
    ++thin;
  }
  if (device_cycles == 0 && !script_trace) {
    std::fprintf(stderr,
                 "FAIL: none of %ld bus cycles reached an Xbus device, so the "
                 "disk controller's registers are claimed correct by a check "
                 "that never read one\n",
                 cycles_run);
    ++thin;
  }
  // **THE ZERO -XBUS.INTR IS COMPARED AGAINST MUST BE A LIVE ZERO.**  This
  // program raises no interrupt --- it enables neither the disk's nor the
  // display's --- so the comparison above is against zero on every row, and
  // The rule is that a check which only ever compares against zero passes a
  // wire stuck at zero.  What makes it a real comparison is that the
  // interrupt's OTHER term is true throughout: `not_active` is `STATUS<0>`
  // and the 11,301 polls all come back `0x2321`, which has it set.  So a
  // fabric that ignored the enable would raise the line and fail.  If MD
  // never holds that word the guarantee is gone and this says so rather than
  // passing on a controller that has stopped answering.
  if (status_rows == 0 && !script_trace) {
    std::fprintf(stderr,
                 "FAIL: MD never held the disk's idle status, so nothing says the "
                 "controller was not-active while -XBUS.INTR was compared "
                 "against zero on %ld microcycles\n",
                 sintr_checked);
    ++thin;
  }
  // **QUUX'S BOOT PROM TOUCHES NO MAIN MEMORY WITHOUT A PACK**, measured on
  // its trace at the pin: it saves nothing (muir's contract Q8, its buffer
  // being page 3, filled only from a label it never reads here), so its
  // every cycle is block-disk's status, polled.  Main memory is held on QUUX
  // by the programs of `golden/src/quux.rs` and by `build/quux13_port.quux.*`,
  // and this run must then reach none of it: a cycle of main memory's here
  // would be a PROM that is not the one the trace was taken from.
  if (quux_prom && mem_cycles != 0) {
    std::fprintf(stderr,
                 "FAIL: %ld of %ld bus cycles of QUUX's boot PROM reached main memory, "
                 "which with no pack it never touches\n",
                 mem_cycles, cycles_run);
    ++thin;
  }
  if (mem_cycles == 0 && !script_trace && !quux_prom) {
    std::fprintf(stderr,
                 "FAIL: none of %ld bus cycles reached main memory; every one "
                 "was answered from the trace and the DDR bridge was never "
                 "asked for a word\n",
                 cycles_run);
    ++thin;
  }
  if (other_speed && !pack_trace && !script_trace) {
    std::fprintf(stderr,
                 "FAIL: %ld microcycles run at other than extra slow; ILONG is "
                 "claimed to change nothing here\n",
                 other_speed);
    ++thin;
  }
  if (ram_executes && !pack_trace && !script_trace) {
    std::fprintf(stderr,
                 "FAIL: %ld microcycles run microcode out of the control "
                 "store; PROMDISABLE is claimed never set\n",
                 ram_executes);
    ++thin;
  }
  struct {
    const char *what;
    long n;
  } reached[] = {
      {"POPJ off the stack", popjs},   {"jumps to IR<25:12>", jumps},
      {"WRITE-I-MEMs", iwrites},       {"fetches out of the boot PROM", prom_fetches},
      {"fetches out of the control store", ram_fetches},
      {"microcycles the bus held off", stalls},
  };
  for (const auto &e : reached) {
    if (e.n == 0 && !script_trace) {
      std::fprintf(stderr, "FAIL: the run reached no %s\n", e.what);
      ++thin;
    }
  }
  // What the pack trace exists for. The boot PROM reaches none of these, and
  // if this one stops reaching them it has stopped earning its 297 MB.
  if (pack_trace) {
    struct {
      const char *what;
      long n;
    } wanted[] = {
        {"reads of the map", map_sources},   {"reads of the dispatch memory", disp_reads},
        {"shifts of Q", q_shifts},           {"microcycles with PROMDISABLE set", promdis_rows},
        {"instructions with ILONG", ilongs}, {"microcycles run out of the control store", ram_executes},
    };
    for (const auto &e : wanted) {
      if (e.n == 0) {
        std::fprintf(stderr,
                     "FAIL: the pack trace reached no %s, which is what it is "
                     "for\n",
                     e.what);
        ++thin;
      }
    }
  }
  if (thin) return 1;

  std::printf(
      "ok: %zu microcycles of the whole machine agree with muir's rtl engine "
      "%s\n"
      "    PC, IR, LPC, OPC, ST, LC, the A and M buses, the ALU, R, OB, Q,\n"
      "    DC, VMA, -VMAOK, JCOND and NOP/PCS1/PCS0/IWRITED every microcycle;\n"
      "    %ld microcycle lengths in 200 MHz ticks, %ld of them within a tick\n"
      "    rather than exact (slip %+ld to %+ld ns), %ld exempt for the Unibus\n"
      "    arbitration of %ld of %ld bus cycles\n"
      "    of those bus cycles %ld reached main memory and %ld an Xbus device;\n"
      "    %ld of those the fabric's own disk controller answered and %ld the\n"
      "    NXM timer ended; %ld device writes put a word on the seam,\n"
      "    %zu distinct among them\n"
      "    reached: %ld POPJs, %ld jumps, %ld WRITE-I-MEMs, %ld dispatches of\n"
      "             which %ld read the memory, %ld PROM fetches, %ld control\n"
      "             store fetches, %ld microcycles the bus held off, %ld map\n"
      "             reads, %ld Q shifts, %ld ILONG instructions\n"
      "    the A bus took %zu distinct values, the M bus %zu, OB %zu;\n"
      "    %ld grants compared against the edge muir grants on\n"
      "    -XBUS.INTR compared on %ld microcycles and up on %ld of them, the\n"
      "      display's vertical interrupt ORed with the disk's request inside\n"
      "      the machine; %ld rows held the disk's 0x2321 in MD, <0> set, so\n"
      "      not-active was true and the zero compared is the enable's\n"
      "    driven from the trace, and going with the memory path: MD, the\n"
      "             word -LOADMD strobes into it; the console's registers\n",
      k, pack_trace ? "on a System 100 band"
                    : script_trace ? "on a program of golden/src/quux.rs"
                    : quux_prom  ? "on QUUX's boot PROM"
                                 : "on MIT's boot PROM",
      lengths_checked, sub_tick, best_slip, worst_slip, arb_skipped,
      unibus_cycles, cycles_run, mem_cycles, device_cycles,
      device_answers, device_timeouts,
      dev_writes_checked, dev_words.size(),
      popjs, jumps, iwrites, dispatches, disp_reads,
      prom_fetches, ram_fetches, stalls, map_sources, q_shifts, ilongs,
      a_values.size(), m_values.size(), ob_values.size(), grants_checked,
      sintr_checked, sintr_raised, status_rows);
  std::printf("    %ld DDR addresses compared against the board's map\n", ddr_addrs_checked);
  std::printf("    %ld bus cycles started inside a held microcycle\n", early_grants);
  std::printf("    %ld cycles ended on the NXM timer, each acknowledging %+d ns\n"
              "      from muir --- the free-running timeout oscillator's phase,\n"
              "      and so the tick the reset network was released on --- on the\n"
              "      yardstick %ld device cycles read at muir's instant\n",
              nxm_acks, kNxmAckSlipNs, dev_acks_measured);

  // What this program did not reach, printed from the counts rather than
  // asserted from memory, so the list cannot outlive its reasons.
  struct {
    const char *what;
    long n;
  } unreached[] = {
      {"the dispatch memory's read", disp_reads},
      {"MACHRUN down", halts},
      {"the statistics counter", stat_counts},
      {"microcode run out of the control store", ram_executes},
      {"the location counter (LC is zero throughout)", lc_moved},
      {"a speed other than extra slow", other_speed},
      {"the map's read", map_sources},
      {"a shift of Q", q_shifts},
      {"an ILONG instruction", ilongs},
  };
  bool said = false;
  for (const auto &e : unreached) {
    if (e.n) continue;
    if (!said) {
      std::printf("    not reached by this program, and so not checked:\n");
      said = true;
    }
    std::printf("             %s\n", e.what);
  }
  return 0;
}
