metebalci/muir-fpga/tb/cadr_io_board_tb.cpp

// SPDX-FileCopyrightText: 2026 Mete Balci
// SPDX-License-Identifier: AGPL-3.0-or-later
//
// The I/O board against muir, at the Unibus.
//
// The DUT is `rtl/machine/cadr_io_board.sv` alone, driven by `build/iob.golden`, which
// `golden/src/iob.rs` writes out of muir's own `ioboard::IoBoard` through
// `busint::IoBoardTiming`.  The seam is the one the card has on the machine:
// `-UB MSYN`, `ub_write`, `ub_addr`, `ub_wdata` in and `-UB SSYN`, `ub_rdata`
// back, which is exactly what `cadr_busint_xbus.sv` already drives and what
// `cadr_spy_registers.sv` already answers at `0o766000`.  Composing the two
// slaves under `cadr_memory_path.sv` is the next slice.
//
// WHAT THIS HOLDS TO, at every one of the trace's 80,949,318 ticks:
//
//   - `-UB SSYN` at the instant the trace names and at no earlier one, on
//     every answered cycle, and never at all on the eleven the card does not
//     answer --- held up for 6,000 ns each, which is well past the 2,250 ns
//     the keyboard-and-mouse group takes at its worst phase;
//   - `ub_rdata` at that instant, on all 837 reads;
//   - THE WHOLE FACE at every one of the 1,532 rows: the status register's
//     flip-flops, the two mouse counters, `CLOCK READY`, the interval last
//     loaded, the vector the card is asking for and `AUDIO`.  Every one of
//     those is a register on the card, so none is a column invented for the
//     trace;
//   - the decode, over all 262,144 addresses an eighteen-bit `ub_addr` can
//     carry, read and written: a real bus cycle each, checked for whether the
//     card answers and for WHEN.  See the exemption below.
//
// **THE ROWS ARE SPARSE AND THE CHECK IS NOT.**  The trace has a row wherever
// anything moves and nothing between; here every tick is run, with the free
// clocks left to run, and the face is compared where a row says so.
//
// **PLACEMENT: A ZERO-TIME TRACE ON A CLOCKED FABRIC.**  177 pairs of rows
// share an instant, because muir applies a cycle's face, then a press, then
// the next cycle's `-MSYN`, all at one nanosecond.  Two rules, and they are
// the disk's rules one slice along:
//
//   1. `-UB MSYN` DROPS ONE TICK EARLY, at `off - 5`, so that the bus is idle
//      for one tick before the next cycle.  102 pairs of cycles are back to
//      back in the trace --- the next `-MSYN` at the instant the last one
//      dropped --- which no clocked master can do.  Nothing on the card can
//      see it: everything a cycle does landed at `-UB SSYN`, twenty ticks
//      earlier, and `off` is only when the master lets go.
//   2. A ROW WHOSE ACTION CHANGES SOMETHING THE FACE SHOWS --- a press, the
//      serial port's ready line, `-UB INIT` --- IS PUSHED ONE TICK when it
//      would otherwise land on the tick the previous row's face is compared
//      at, and every row at that same instant after it is pushed with it.
//      Seven rows are pushed, and the run prints the count.  A mouse move or
//      a switch changes nothing the card shows until its next `KB CLK^`, and
//      a cycle changes nothing on the tick its `-MSYN` rises, so those share
//      a tick with the row before them and are not pushed.
//
// **THE MOUSE'S ENCODERS ARE IN HERE, AND muir'S SNAP WITH THEM.**  The card
// takes the seven lines MIT's mouse drives, so the thing that turns the
// trace's `MOVE` rows into quadrature phases is this file.
// `MouseInterface::sample` computes each step's instant as the later of the
// encoder's own due time and THE PREVIOUS EDGE ALREADY SAMPLED --- so a step
// whose due time has fallen behind is dragged forward onto an edge, and
// because an edge is a multiple of 8,000 and a step is 16,000, every step
// after it lands exactly on an edge.  The first two steps of a move therefore
// land on CONSECUTIVE edges and the rest on every other one.  Slice one
// measured what keeping the encoder's own phase instead costs: 307 face rows
// and 27 read-backs disagree, the counters one behind muir for the length of
// every move.  That is a contract, not a tolerance.
//
// **THE DECODE HAS NO EXEMPTION LEFT.**  This file used to require that the
// card did NOT answer the Chaosnet interface's group (`0o764140`-`0o764156`)
// or the serial port's (`0o764160`-`0o764176`), and printed how many
// answering directions that let through: twenty-seven of fifty-five.  Both
// groups are built, so all fifty-five are held, at three answer timings the
// rest of the card does not use --- `IOB_CHAOS_BUFFER_NS` through the
// transmitter, `IOB_RBUF_SETUP_NS` on `FCLK^`, and `IOB_SERIAL_NS` past a
// half-microsecond clock whose phase is 203 ns.
//
// **AND THE TWO FAR ENDS ARE STIMULUS, NOT MODELS.**  The Chaosnet's cable
// and the 2651's line are the `cadr-chaosnet` and `cadr-serial` programs' on
// the board, and muir's own interface plays both here: the trace records the
// instants they act at as `CRX`, `CTD`, `CLS`, `CBL`, `CST`, `CLV`, `STK`,
// `SDN` and `SRX` rows and this file replays them at the card's seam.  The
// Chaosnet line's are the cable's facts before the card's receive gate --- a
// frame on the line (`CBL`), its `START^` (`CST`), the bits stored so far
// and the check over them (`CLV`, held from row to row) --- and the card's
// own gate is what the faces then hold.  What the card hands back
// --- the transmit buffer at a read of START, a character on the cable --- is
// compared and never driven.
//
// AND THE COUNTS ARE THE GENERATOR'S.  The header says how many cycles of
// each kind the program made, how many answers fell off the 5 ns grid, and
// how many phases of `-UB MSYN` inside the card's microsecond it used; the run
// counts what it saw and requires the same, so a trace that stopped reaching
// something says so here rather than passing thinner.

#include <cerrno>
#include <cstdint>
#include <cstdio>
#include <cstdlib>
#include <cstring>
#include <map>
#include <set>
#include <string>
#include <vector>

#include "Vcadr_io_board.h"
#include "cadr_tick.h"
#include "verilated.h"

namespace {

constexpr long kTick = kGridNs;        // nanoseconds a tick: MIT's grid
// `-BOOT*`, the card's own boot line: half a keyboard clock, 4 us.  See THE
// BOOT WORD in `rtl/machine/cadr_io_board.sv` and `docs/keyboard-boot.md` in
// muir.  `kBootPulseT` is that in ticks.
constexpr long kBootPulse  = 4000;
constexpr long kBootPulseT = kBootPulse / kTick;
constexpr long kUbAddresses = 1 << 18;
constexpr unsigned kNoReg = 0xFFFF'FFFFu;

// ioboard::FIRST_USEC_EDGE_NS, KB_CLK_NS, MOUSE_STEP_NS.
constexpr long kFirstEdge = 890;
constexpr long kUsecPeriod = 1000;
constexpr long kKbClk = 8000;
constexpr long kMouseStep = 16000;
// busint::IOB_STRAIGHT_NS and IOB_USEC_LOW_NS.
constexpr long kStraight = 250;
constexpr long kUsecLow = 313;
// busint::IOB_CHAOS_BUFFER_NS, IOB_FCLK_NS, IOB_RBUF_SETUP_NS,
// IOB_HALF_USEC_NS, IOB_HALF_USEC_PHASE_NS and IOB_SERIAL_NS: the three
// timings the Chaosnet interface and the serial port answer on.
constexpr long kChaosBuf = 350;
constexpr long kFclk = 125;
constexpr long kRbufSetup = 33;
constexpr long kHalfUsec = 500;
constexpr long kHalfUsecPhase = 203;
constexpr long kSerialNs = 750;
// `chaos::board::TSR_LOAD_NS` and `TSR_WORD_NS`: the transmitter's shift
// register loads at the first `FCLK^` at least 101 ns after a WRITE BUFFER's
// or a START's answer and shifts a word in 2,000 ns; a WRITE BUFFER or START
// that comes while it is busy is answered `kChaosBuf` after it empties.
constexpr long kTsrLoad = 101;
constexpr long kTsrWord = 2000;
// `busint::UNIBUS_STROBE_NS`: a master holds `-UB MSYN` this long after it
// sees `-UB SSYN` --- "MSYN OUT drops at SSYN T100" --- and the card's word
// crosses on the edge after the one `-UB SSYN` rises on, so a master that
// let go at once would take nothing.
constexpr long kMsynHoldT = 100 / kTick;

// The registers this file names, by their own Unibus address.
constexpr unsigned kKbdLow = 0764100u, kCsr = 0764112u;
constexpr unsigned kUsecLowReg = 0764120u, kUsecHighReg = 0764122u;
constexpr unsigned kClock = 0764124u, kGpio = 0764126u;
// The Chaosnet interface's group and the serial port's, and the registers
// inside them whose answer is not the plain TD250.
constexpr unsigned kChaosFirst = 0764140u, kChaosLast = 0764156u;
constexpr unsigned kSerialFirst = 0764160u, kSerialLast = 0764176u;
constexpr unsigned kChaosWbuf = 0764142u;   // written; read it is MY ADDRESS
constexpr unsigned kChaosRbuf = 0764144u;
constexpr unsigned kChaosStart = 0764152u;
constexpr unsigned kChaosCsr = 0764140u;
constexpr unsigned kSerialStatus = 0764162u;
constexpr unsigned kSerialMode = 0764164u, kSerialCommand = 0764166u;

// How many rows this check's placement has to push one tick.  The two rules
// are in the header; the number is this file's own and not the trace's, so it
// is written here and asserted rather than read out of the header.
constexpr long kPushedRows = 10;

// How long a cycle nothing should answer is held in the decode sweep.  The
// longest answer the card can give is the keyboard-and-mouse group at its
// worst phase, 2,250 ns; the trace's own eleven unanswered cycles are held
// for 6,000.
constexpr long kSweepHold = GridTicks(2300);

// `busint::IoBoardTiming::usec_edge_after`: the first rising edge of the
// card's microsecond clock STRICTLY after `t`.
long UsecEdgeAfter(long t) {
  if (t < kFirstEdge) return kFirstEdge;
  return kFirstEdge + ((t - kFirstEdge) / kUsecPeriod + 1) * kUsecPeriod;
}

// `IoBoardTiming::fclk_edge_at_or_after` and `half_usec_edge_after`.
long FclkEdgeAtOrAfter(long t) { return (t + kFclk - 1) / kFclk * kFclk; }
long HalfUsecEdgeAfter(long t) {
  long k = (t < kHalfUsecPhase ? 0 : (t - kHalfUsecPhase) / kHalfUsec) + 1;
  return kHalfUsecPhase + k * kHalfUsec;
}
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
