metebalci/muir-fpga/(commit log)

2026-09-08 SPDX headers on every source file, and the LICENSE
    Both lines, as muir has them, on the source files only: not on README,
    Cargo.toml, .gitignore or the lock file, which is muir's own split.
    Also corrects two comments written before the -TPR60 artefact was
    measured: the reference emits it from power-on too, at ticks 11 to 18,
    not only on a reset held mid-run.
    [cadr_phase_gen.sv, cadr_phase_gen_tb.cpp, phase_gen.rs]
2026-09-08 the processor's port list, generated from cables.txt
    The five flat cables are the processor's boundary, so they are the
    module's ports: 92 wires, 15 in, 29 out, and 48 --- MEM<31:0> and
    SPY<15:0> --- driven from both ends and carried as value, enable and
    resolved-back-in, because fabric has no bus to fight over.
    Direction is derived rather than asserted: for every wire the generator
    asks both netlists which parts sit on the net and how each pin drives,
    through part::pinout. It reproduces cable.rs's own table for the nine
    signals that names, and stops if it cannot.
    Settles the name mangling, which everything generated after this
    inherits: a leading '-' becomes 'n_', '.' ' ' '/' and '>' beco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
    [cables.rs]
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2026-09-08 the NXM timeout
    The 74LS124 at REQTIM 0A01 free-runs from power-on and the grant only
    opens its output, so where the timeout falls depends on the oscillator's
    phase at the grant and not on the grant alone: the gated output's first
    fall is the oscillator's first fall strictly after the grant, and NXM
    TIMEOUT is the sixth rise after that. Restarting the oscillator at the
    grant is the obvious way to write it and is wrong; the trace catches it
    because its grants land at varied phases.
    The board races the timer against the slave where busint.rs decides at
    the grant which will win, having seen the responder. They agree wherever
    the model is exercised.
    40,000 ticks over 146 cycles, 29 of them tim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
    [busint_xbus.rs, cadr_busint_xbus.sv, cadr_busint_xbus_tb.cpp]
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2026-09-08 the DDR bridge, and the memory path end to end
    The first module with no reference behind it: nothing in MIT's drawings
    is a DDR controller, and MemoryBoard models a board of 4116s refreshing
    itself, which this is not. So it is held to what has to be true of it
    instead --- a read returns the word an earlier write put there --- while
    decode, bus interface and bridge together still keep muir's timing at
    every tick.
    The bridge adds no ticks of its own. mem_req follows -XBUS.RQ and
    dev_ack follows mem_done with no register in the way, so the latency all
    belongs to the AXI adapter behind it and shows up as the device's answer
    time, which is what keeps it comparable with the model.
    Two mistakes i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
    [busint_xbus.rs, cadr_busint_xbus_tb.cpp, cadr_memory_path.sv, cadr_memory_path_tb.cpp, cadr_xbus_ddr.sv]
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2026-09-08 the disk gets its own port
    M_AXI_GP0 means the PS is master, so a block crossed as 256 CPU stores. A
    Trident turns 60 times a second with 17 blocks to the track: 1,020 blocks a
    second of 256 words, so 261,120 stalled stores a second against a 968 us
    deadline for each block. Bandwidth was never the problem --- that is only a
    megabyte a second --- the CPU being present for every word of it was.
    So S_AXI_HP1, which fabric masters, and it fetches the block out of DDR
    itself off the block's address Linux wrote. Its own port rather than a share
    of HP0 because HP0 is the memory bridge's, the one seam at machine speed, and
    disk traffic there would add arbitration to the machine's critical path.
    Th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
2026-09-08 colour each block by how far along it is
    Five states, and the legend names them: built and checked, partly built,
    being written now, outside the project, and no fill at all for not
    started. The stroke carries the meaning and the fill only tints at 18%,
    so each reads on either ground.
    This is the one place the page departs from muir's 1-bit rule --- there
    tone comes from dither and emphasis from reverse video, never from a hue.
    The outline is already carrying fabric-or-PS, and how far along a thing is
    is an axis of its own, so it needed a second channel.
    What the colours say at this commit. Green: the clock, and the Xbus-to-DDR
    path, whose bridge, AXI adapter and DDR map all have passing ch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
2026-09-08 pin the compiler to muir's
    golden's only dependency is muir, by path, so the reference traces are
    produced by muir's own code compiled here --- and muir pins its compiler
    because 1.98.0 and 1.98.1 miscompile `chaos::board::Turn::tc` at
    `opt-level = 3` with `codegen-units = 1`. Building that code with whatever
    the machine happens to default to gives that bug a way in through the back
    door. muir's own rust-toolchain.toml has the full account.
    This file must track muir's: when muir moves to 1.99, this moves with it.
    At the repository root and not in golden/, where it belongs by rights.
    rustup resolves the toolchain from the working directory and its ancestors,
    not from --manifest-path, and th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
2026-09-08 the checks, checked
    `make check` passing says the fabric agrees with muir. It says nothing
    about whether it would still pass if the fabric were wrong, and that is
    the claim the whole project rests on --- one CLAUDE.md and
    tb/cadr_memory_path_tb.cpp have both been making with nothing behind it.
    58 mutations over the six checks stage 3 froze. Seven of CLAUDE.md's
    eight recorded bugs are in the list by name; the eighth is a property of
    the runner rather than a mutation, and the one that is missing is in the
    stimulus generator rather than in the fabric (#6).
    Each mutation is applied to a copy of rtl/ and tb/ and built there: the
    working tree is never touched. A mutation that fails to apply, or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
2026-09-08 the scratchpads, and the pass-around that hides them
    Stage 4 slice 2: the A memory with its ACTL pass-around, the M memory with
    MCTL's, the PDL with its pointer and index, the stack with SPCPTR, RETA,
    SPCW and the push pass-around, L, the location counter, and the FLAG
    byte-mode bits.
    `rtl.rs`'s header calls out three things easy to get one state wrong, and two
    are here: the 93425As are asynchronous and the 74S373 at
    ALATCH/MLATCH/PLATCH/SPCLCH is the state, and a scratchpad write is one
    microcycle behind the instruction that computed it, hidden by the comparators
    at ACTL 3B21/3B27 and MCTL 4B18.
    The latches turn out to be the answer to the asynchronous-RAM question rather
    than a complicat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
    [cadr_microcycle.sv, cadr_microcycle_tb.cpp]
2026-09-08 a hole that is written down does not fail the run
    `make mutants` was red for four known reasons, which is a target that
    cannot report a fifth. Red for four looks exactly like red for five, so
    a runner that stays red by design has stopped being a check and become a
    reminder --- and the point of the list is that six passing checks mean
    nothing without evidence they can fail.
    So `@hole #3` on a record: the check is known not to catch it, the issue
    says why, and the run reports it and goes on. That is the shape this
    repository already uses for a known divergence --- "Where the fabric
    parts from muir", and the testbench not comparing -TPR60 while RESET is
    high. What it does not tolerate is an un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
2026-09-08 resolve the runner's paths before it changes directory
    `make mutants` from the repo root, with no overrides, did not work: the
    baseline failed on every check that needs a -Mdir or a golden, and only
    `cables` and `axi_master` --- which need neither --- came through.
    The runner builds each mutation with its working directory set to that
    mutation's own copy, so a relative path from the command line resolved
    against the copy instead of against where the caller stood. `--work
    build/mutants` became build/mutants/<name>/build/mutants/..., which
    Verilator cannot write, and `--goldens build` was looked for under the
    copy and was not there.
    The same lesson as 4fa4e48, "pass the testbenches by absolu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
2026-09-08 the M bus, the ALU, the shifter and OB
    Stage 4 slice 3. Checked now on every one of the 600,000 microcycles: PC, IR,
    LPC, OPC, ST, LC, the A and M buses, the ALU, R, OB, Q, DC, JCOND and the four
    sequencing flags, and every microcycle length. `jcond`, `ob` and `m` are gone
    as ports; what comes in is the memory path's --- `md`, `vma`, `-VMAOK`,
    `SINTR`, the SRCMAP word and the dispatch memory's word.
    This slice touches the golden generator as well as the fabric, for two new
    columns, `md` and `vma`, off `e.machine()`.
    One of them was nearly wrong in a way worth recording. A reference sampled
    before a stall is the value the cycle was waiting to be rid of: a stall is
    usually a wait for MD, `-L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
    [cadr_microcycle.sv, cadr_microcycle_tb.cpp, rtl.rs]
2026-09-08 run the runner's own self-test from the Makefile
    `make mutants-selftest` holds run.py to its six guarantees, against lists
    written to fail: a mutation that does not apply, one that lint rejects, a
    survivor with nothing recorded, a hole that has closed, one that is still
    open, and a run from another directory with relative paths.
    That last case is the one that had gone unnoticed. `make mutants` invokes the
    runner with relative `--goldens` and `--work`, and the runner builds each
    mutation with its working directory set to that mutation's own copy, so the
    paths resolved against the copy --- `build/mutants` became
    `build/mutants/<name>/build/mutants/`, which Verilator cannot write. `cables`
    and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
2026-09-08 a second reference for the processor, off a System pack
    The boot PROM is the right primary reference and it is a program with a
    fixed path. Measured over its 600,000 microcycles it reads the dispatch
    memory never, runs microcode out of the control store never, shifts Q
    never, and reads the map once. This is the same engine and the same
    thirty-nine columns with a pack under it.
    A window rather than a boot. The machine leaves the PROM at microcycle
    1,410,035 and has first touched everything reachable by 2,084,537, so
    what is worth writing is what comes after: 200,000 microcycles from
    3,000,000 is 29 MB, against 413 MB for the boot and 14 GB for a hundred
    million. In that window, against the b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
    [rtl_sys.rs]
2026-09-08 keep the System release here, and take the pack from a fresh copy
    Wires up `golden/src/rtl_sys.rs`: the `rtl_sys` bin, and the rule that makes
    `build/rtl_sys.golden` --- 200,000 microcycles from 3,000,000 of a System 100
    boot, 29.5 MB, 2.7 seconds.
    The archive lives in this repository's own `vendor/`, gitignored, rather than
    being read out of muir's. Two reasons, and the second is the one that matters:
    A drive writes its pack. muir opens one read-write by default and the machine
    writes blocks back, so any working image drifts under any run that opens it
    --- ours or anybody's. A reference trace taken against a drifting file is not
    reproducible, and would be wrong in a way nothing reports. S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
2026-09-08 the archive is this repository's now, and the sum is what guards it
    Follows 11bcd82. The generator's own notes still said the pack came out
    of muir's vendor/ and was checked by muir's fetch script, which is no
    longer where it lives or what checks it.
    Says instead what is now true and why it matters: the archive is here,
    it is gitignored, and the rule's SHA-256 is therefore the only thing
    that would notice it being replaced.
    [rtl_sys.rs]
2026-09-08 VCTL1, and the two ways the machine is held
    Stage 4 slice 5: `-WAIT` as the 74S64 at VCTL1 3F16 and `-HANG` as the 74S10
    at 3F17, with MBUSY, MBUSY.SYNC and RD.IN.PROGRESS under them. Deferred from
    stage 3 because both need microinstruction decode fields and muir exposes no
    signal-level view of that state; slices 1 to 3 built the decode, so the reason
    for deferring it has expired.
    **The stall is no longer subtracted from the expected microcycle length.**
    VCTL1 decides `-WAIT` and `-HANG` itself, so the whole interval between
    boundaries is the fabric's own answer rather than the trace's: 6,912 waits,
    11,404 hangs and 2,198,700 ns of held clock, every one landing where muir
    lands it.
    Both co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
    [cadr_microcycle.sv, cadr_microcycle_tb.cpp, rtl.rs]
2026-09-08 mutate the generators, and stop them sharing a binary
    Issue #6. Nothing downstream of these two can stand in for them:
    cables.rs is the only authority on the port list, and regenerate-and-diff
    catches an edit to what it emits but not an error in the emitting;
    busint_xbus.rs writes the stimulus and the expected outputs both, so a
    trace agreeing with itself proves nothing. In each the guard is an
    assertion inside the generator, and this is the only thing that can ask
    whether it fires.
    Five mutations, all caught: the prose table disagreeing with the
    netlists, a totem-pole output not counted as a driver, a pull-up counted
    as one, and the address count sharing a factor with each of the two
    perio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
2026-09-08 the AXI adapter's error path, and when it may say it is done
    Closes the two holes the mutation list has been carrying against
    axi_master, #3 and #4. Both were the same shape: the check said nothing
    about a signal, so a design that got the signal wrong passed.
    #3, mem_error. The slave drove bresp and rresp zero on every tick, so the
    whole error path was untested and a master that ignored both responses
    was indistinguishable from one that did not. One transaction in eight is
    now refused, alternately SLVERR and DECERR, and mem_error is compared
    against what was injected rather than against zero --- which also catches
    an error reported when there was none, and one left standing into the
    next tr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
    [cadr_axi_master_tb.cpp]
2026-09-08 -XBUS.RQ is a level, and the counter that gates it wrapped
    Closes #2, and the check written to close it found a real bug in the
    fabric on its first run.
    #2 was that nothing held the interface to the bus's own rule about the
    request: "-XBUS.ACK ... remains asserted until the -XBUS.RQ signal is
    removed by the master". -MEMGRANT, -MEMACK, -LOADMD and NXM TIMEOUT are
    all made from the state alone, so dropping the request the moment the
    cycle was acknowledged moved none of them, here or through the whole
    memory path. muir has no -XBUS.RQ column to compare against, so the only
    thing that can see it is the testbench's own slave, which was waiting on
    it. It now fails if the request is withdrawn whi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
    [cadr_busint_xbus.sv, cadr_busint_xbus_tb.cpp]
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2026-09-08 the self-test's surviving fixture is built, not borrowed
    Two of the seven arms need a mutation that survives: "a survivor with
    nothing recorded", which must fail the run, and "a hole that is still
    open", which must not. Both took one from list.txt --- whichever record
    carried an `@hole` --- and that worked only while the list held one.
    It is meant not to. Every hole closed is a check fixed, and #2, #3 and #4
    have closed; #5 is the last, and it waits for the map slice. A fixture
    that stops working when the project succeeds is the wrong fixture, and
    the failure would have landed on whoever closed the last hole rather than
    on whoever wrote this.
    So it is built instead. A comment cannot change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
2026-09-08 the processor is built and checked
    Both boards go from being written to built and checked. The ICMEM board is the
    control store, 16K x 48 with the boot PROM over its bottom 1K; the CADR board
    is the datapath, the sequencer, the scratchpads and the maps --- and all of it
    now agrees with muir's rtl engine, over 600,000 microcycles of MIT's boot PROM
    and 2,200,000 of a System 100 band.
    As the drawing's own note says, this does not claim a block is correct, only
    that its checks pass. Two things no reference reaches are in issue #1.
    The bus interface stays partly built. It has the Xbus and not the Unibus, and
    the band shows what that costs: 347 of 141,849 bus cycles arbitrate for a bus
    this int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
2026-09-08 the processor's scratchpads, dispatch and map, and a snapshot to run against
    The first stage-4 batch: the two pass-arounds that hide the scratchpad
    write being a microcycle late, the M comparator's sixth bit, the
    dispatch mask and the DSPCTL gate, and both levels of the map. Seven,
    all caught. Nothing in the stall path or touching `md`, `MBUSY` or
    `-LOADMD`: the processor is being composed with the memory path and
    those are about to move.
    MUTATE A COMMIT, NOT THE WORKING TREE. `--rev` exports the sources with
    `git archive` instead of copying what is on disk. The checkout is
    shared, and mid-run the module and the testbench were both changed under
    the run: a baseline that passed at one moment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
2026-09-08 MD comes through the cables, and a write gets poison
    `md` stops being a trace column and becomes an output of the processor, loaded
    by `-LOADMD` and compared on every microcycle: 600,000 on MIT's boot PROM and
    2,200,000 on the System 100 band.
    Two things had to be right, both found by the check failing.
    **The word is keyed by row, not queued.** A queue of the words MD was seen to
    take does not work: a read whose word equals what MD already holds moves
    nothing, is invisible as a change, and the queue then hands the next read a
    later cycle's word. It goes wrong at microcycle 536,309 of the boot PROM, where
    the second read returns the zero MD already had. Keyed by row, the rule is the
    one `tr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
    [cadr_machine.sv, cadr_microcycle.sv, cadr_microcycle_tb.cpp]
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2026-09-08 the mutation runner needs the processor's traces too
    `make mutants` from a clean build directory stopped with
    mutations: build/rtl.golden: no such trace
    because the rule listed only the phase_gen, busint_xbus and xbus_decode
    goldens as prerequisites. It was written before the processor checks existed,
    and the stage-4 mutations are of `cadr_microcycle.sv`, so a run needs the two
    traces they are checked against and the PROM image with them.
    Not seen sooner because a `mutants` run usually follows a `make check`, which
    builds them all. It only fails from clean, which is how a release gate finds it
    and an incremental build does not.
    `rtl_sys.golden` is safe to depend on: without the relea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
2026-09-08 #5 was an equivalence, not a hole, and @hole cannot see a closed issue
    Settled: at the bridge's boundary, latching MD on a write as well
    changes nothing. -LOADMD is asserted by the interface on every
    acknowledgement whatever the direction, and the gate that stops a write
    strobing MD is the processor's `if !self.wrcyc`, not the bridge's. So
    the mutation was equivalent from the start and #5 was a question rather
    than a defect.
    Handled as the other two equivalences were: the record is rewritten to
    mutate something that does differ --- the word corrupted on its way to
    MD --- and the reasoning stays in its note, including that this is NOT
    `rdcyc_gate_dropped`, which drops the processor's own gat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
2026-09-08 a generator's prerequisites must name every file it compiles
    Neither processor golden named `golden/src/trace.rs`, and both generators do
    `mod trace;`. So editing the one file that exists to be the single definition
    of the row shared by both regenerated neither trace.
    That is worse than an ordinary stale artifact. A changed row format would leave
    `make check` comparing a new DUT against an old trace, and it could pass by
    both being consistent with something no longer true --- which is the shape the
    duplication issue was filed to prevent, arriving through the build instead of
    through the source.
    Checked the other four generators rather than fixing only the two that were
    reported: `trace` is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
2026-09-08 the two halves meet, and stop at the wall where the I/O board is not
    `rtl/cadr_machine.sv` gets a check. The processor and the memory path have
    existed side by side since stage 4 began and had never been asked to agree
    about a single cycle: `microcycle.pass` drove `md` from the trace and
    `memory_path.pass` drove the cables from a test master, and both passed.
    Composed, they agree for **537,841 microcycles** of MIT's boot PROM. MD is the
    fabric's own --- strobed by the fabric's own bus interface, through its own
    decode and DDR bridge, and compared every microcycle --- and every microcycle
    length is the fabric's own too, stalls included. The testbench drives nothing
    nearer than `mem_req`/`mem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
    [cadr_machine.sv, cadr_machine_tb.cpp]
2026-09-08 the two halves meet
    Composed, they agree for 537,841 microcycles of MIT's boot PROM. MD is the
    nearer than `mem_req`/`mem_done`; `-MEMGRANT`, `-MEMACK` and `-LOADMD` are all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
2026-09-08 the stall path: a constant charged in full, and a tolerance at its edge
    Six mutations of VCTL1's stall gates and the two countdowns off the
    acknowledgement.
    -RDFINISH CHARGED IN FULL IS CAUGHT. The fabric charges two ticks fewer
    than the delay line's 140 ns, deliberately, because ending a hang costs
    it two ticks the board spends in gate propagation. A number chosen to
    make a check pass is exactly what a mutation list exists to interrogate,
    and this one holds: charge it in full and the check objects. The comment
    was right and is now backed.
    AND THE SLIP TOLERANCE IS TIGHT AT EXACTLY ONE TICK. The length check
    exempts a slip of less than a tick on a stalled microcycle, because
    muir's clock i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
2026-09-08 a record that rotted under another change, and a gentler default
    `bridge-answers-at-an-address-nothing-is-at` read `is_nxm`, which the
    decode drove into a wire inside cadr_memory_path.sv. Bringing the Xbus
    out made `nxm` a port of the path instead, and the wire went. The
    mutation's @old still matched, so it applied, and its @new then named a
    signal that no longer exists.
    It came back BROKEN with Verilator's own message, which is the runner
    doing exactly what it is for: a record can rot under another change
    while still applying, and the only thing standing between that and a
    silently uncounted mutation is that a failed build is loud. Fixed by
    reading `nxm`; the note says why the name moved,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
2026-09-08 2e911df carries the wrong message
    An empty commit, because the error is in history and a note is the only
    way to repair it without rewriting what has been published.
    **What 2e911df actually is.** It answers issue #8: the map's staleness
    recorded at the smallest magnitude that is caught, and the fourth
    equivalence written up. Its message says "the two halves meet", which
    describes ba6ee49, a different commit. Read its diff, not its subject: it
    touches `mutations/list.txt` and nothing else, which no commit about
    composing the processor with the memory path would do.
    **How.** ba6ee49's diagnosis of the wall was wrong --- it blamed "no I/O
    device" where the truth was an NXM cycle that is *mean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
2026-09-08 the composed machine, and how little of it is memory
    Three mutations of cadr_machine.sv, which is pure wiring and therefore
    the only check that can catch a cable crossed: both halves are right on
    their own and the machine is not. Neither microcycle nor memory_path can
    see any of these, each having the other half as a testbench rather than
    as a design.
    WRCYC driven by RDCYC is caught. The other two are not, and together
    they say something about the check rather than about themselves.
    The master clock inverted survives --- the interface then grants on
    every tick but the boundary, which is twenty-nine ticks early on every
    memory cycle. So does the read data cable rotated by a bit, though MD i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
2026-09-08 the counter drives a comparator and nothing else
    The phase generator missed 200 MHz. Measured out of context on an
    xc7z020clg400-1: WNS -0.244 ns, seven failing endpoints of twenty-two, worst
    path `phase_reg[4]` to `n_tpwpiram_reg`, 5.237 ns of which three quarters was
    routing. That is the one part of this design that genuinely must run at tick
    rate, since it is what counts the 5 ns ticks; the datapath settles between
    phases and has 75 ns at the fast read tap.
    The path was the counter through an increment, then an add, then a compare,
    then the register. Both adders are gone. The taps are held as instants one tick
    early --- `read_t + offset - 1` --- in registers of their own, compared agains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
    [cadr_phase_gen.sv]
2026-09-08 MD crossed from stimulus to output and nothing was aimed at it
    `md` is an output of the processor now, loaded from the cables at
    -LOADMD, and no record in this list touched it. Turning a driven input
    into an output does not stop the testbench driving it, and the
    testbench was fixed with poison on a write. Nothing then
    proved the fixed check bites.
    Two records now do: the word corrupted on its way into MD, and the
    two-stage hold losing its hang term --- a hung machine has no boundary
    coming, so the microcycle waiting on the word would never see it, which
    is a permanence claim of the same kind as -WAIT before -HANG. Both
    caught.
    THE GAP IS WORTH NAMING, because it is the third direction this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
2026-09-08 the machine writes the register that turns its own PROM off
    The composed machine runs the whole boot PROM: all 600,000 microcycles agree
    with muir's rtl engine, with no wall. It reaches `0o766012` over the Unibus and
    writes it itself.
    `rtl/cadr_spy_registers.sv` is the diagnostic block --- the sixteen registers at
    `spy::BASE`, answering at `DIAGNOSTIC_NS` for a read and `REGISTER_STROBE_NS`
    for a write, with `REGISTER_PULSE_NS` for the leading edge that carries
    `-PROG.RESET` and `PROG.BOOT`. The arbitration in `cadr_busint_xbus.sv` is the
    simple path only, stages 1 to 5; `LMUB MASTER` is set at stage 3 and never
    cleared, so every later Unibus cycle starts at stage 4. The branches that make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
    [cadr_busint_xbus.sv, cadr_machine.sv, cadr_machine_tb.cpp, cadr_memory_path.sv, cadr_microcycle.sv, cadr_microcycle_tb.cpp, cadr_spy_registers.sv]
2026-09-08 half of #9 closed itself, and the other half's diagnosis was wrong
    The two records filed against #9 were predictions rather than debts ---
    survivors expected to start failing on their own when the composed
    check's memory surface grew. One did. Measuring the other moved it
    twice.
    CLOSED BY ITSELF: the-data-cable-back-from-memory-is-rotated. The
    machine now writes its own mode register over the Unibus, so the check
    no longer stops at the wall: 600,000 microcycles and 17,466 bus cycles
    against the 515 it saw when this was filed. Enough reads for a rotated
    word to reach a compared column. Nothing changed in the mutation and
    nothing was fixed in the fabric; the run said so itself, as CLOSED,
    nam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
2026-09-08 the grant was a microcycle, not a tick, and four anchors moved
    #9 resolved, both halves, and neither the way the issue argued.
    The rotated data cable is caught now that the composed check runs the
    whole boot PROM --- 17,466 bus cycles against 515. The hole closed by
    the surface growing and the run said so itself.
    The inverted master clock was never a hole: it moves the grant one tick
    late, and a tick does not matter because -MEMRQ is up for the whole
    preceding microcycle, so anything in that window grants. The check was
    right and the mutation was the wrong size. What matters is a whole
    microcycle, which only the Unibus can tell because arbitration begins at
    the grant and must know then whi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
2026-09-08 the read-finish constant and the comment that justifies it disagree
    `RD_FINISH_T` is `(140 / 5) - 3`. The comment above it says "-RDFINISH is
    two ticks short of its 140, and deliberately", and names a mechanism for
    each of the two: RD.IN.PROGRESS falls on the tick the countdown expires,
    the parked generator needs one tick to see -HANG lift and another to
    raise TPCLK.
    The third tick has no mechanism written against it. Setting the constant
    to what its own comment justifies is NOT caught:
    (140 / 5) charged in full CAUGHT
    (140 / 5) - 2 what the comment says SURVIVED
    (140 / 5) - 3 what the source has baseline
    So the check can tell the constant from 14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
2026-09-08 the read-finish constant is derived, and the tick belongs to the testbench
    `RD_FINISH_T` was `(140 / 5) - 3`, and the comment above it said two ticks
    short and named a mechanism for each of the two. The third had no mechanism
    written against it. Found from two directions at once: a mutation showed the
    check could tell the constant from 140 charged in full and **could not tell it
    from its own documented value**, while the derivation showed why only two ticks
    are the fabric's.
    The derivation, now written at the constant tick by tick: the countdown ends at
    X; `RD.IN.PROGRESS` is a register, so it is visible from X+1; the parked
    generator samples `-HANG` before the edge ending X+1 and raises TP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
    [cadr_machine.sv, cadr_machine_tb.cpp, cadr_microcycle.sv, cadr_microcycle_tb.cpp]
2026-09-08 each tolerance gets a mutation just outside it, and they are not where the tolerances say
    The read-finish constant is derived now --- boundary at memack + N + 2,
    wanting memack + 28, so N = 26 --- and the third tick went back to the
    standalone testbench, where muir's off-grid -MEMACK is rounded up and
    measured from an edge marker a tick after the boundary. This is #10's
    second resolution.
    So the records change with it. Charging in full still anchors, at the new
    constant. And the record that tested the slip bound now restores the
    third tick instead: a fabric constant absorbing an artefact of how a
    check measures, which is the bug that was just removed.
    CHECK WHICH SIDE IS TIGHT BEFORE ANCHO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
2026-09-09 the grant is checked at the grant, not inferred from a length
    `b851e8a` set `RD_FINISH_T` to its derived `(140 / 5) - 2` and widened the
    composed check's slip tolerance to admit a whole tick. Both halves were
    defensible and together they made a check weaker, which the mutation list
    caught within one commit:
    --rev e49ec5b --only the-grant-comes-a-microcycle-early CAUGHT
    --rev b851e8a --only the-grant-comes-a-microcycle-early SURVIVED
    It had been caught on one row and one shape --- microcycle 537,849, the
    microcycle in ns is 113, reference says 118. A slip of -5 ns, which is exactly
    what the widened tolerance now admits.
    **And the tolerance was not absorbing a pre-existing impre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
    [cadr_machine.sv, cadr_machine_tb.cpp, cadr_microcycle.sv, cadr_microcycle_tb.cpp]
2026-09-09 --since: a mutation that used to be caught is not a hole
    The list caught a check getting weaker --- a mutation written to test the
    grant noticed a tolerance --- only because "this used to be caught" was a
    comparison made by hand. Nothing in the runner suggested it. A capability
    that depends on someone being surprised is not a capability.
    `--since <rev>` re-runs whatever is not caught against an earlier
    revision and reports anything caught there. It costs a pass over the
    survivors rather than over the list, because survivors are the only
    records where the answer can be surprising.
    It names both revisions rather than saying "used to be caught": "caught
    at e49ec5b; here it survives" points at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
2026-09-09 a bitstream exists
    Step 1 of getting this onto a board: a top level with the Arty Z7-20's
    own pins, through synthesis, placement, routing and write_bitstream.
    4,045,764 bytes at build/bitstream/cadr_arty.bit. Nothing in this
    repository had ever run the flow end to end.
    2 multicycle exceptions, 3 clocks
    2063 LUTs, 714 registers, 29 block RAMs
    worst slack -4.825 ns --- TIMING IS NOT MET
    sysclk 8.000 ns {sysclk}
    clk_200_raw 5.000 ns {u_mmcm/CLKOUT0}
    TIMING DOES NOT CLOSE AND THE BITSTREAM IS WRITTEN ANYWAY. It proves
    the flow, not the machine, and the two unknowns are worth separating
    rather than compounding. The failing path is the family already known
    --- `memst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
    [cadr_arty.sv, cadr_arty.xdc]
2026-09-09 how to reach the board, and the failure that reads as a network problem
    `docs/board.md`, the first thing in a `docs/` directory. The board need not be
    attached to the machine that runs Vivado --- `hw_server` owns the cable and
    speaks over TCP 3121 --- and that is the arrangement here, so it wants writing
    down.
    The part worth documenting is not the connection but the failure. Without udev
    rules the JTAG device is `crw-rw-r-- root root`, so `hw_server` running as an
    ordinary user can read it and not write it, and the symptom is not a permission
    error:
    ERROR: [Labtoolstcl 44-199] No matching targets found on connected
    servers: <address>
    The server starts, Vivado connects to it, and n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
2026-09-09 the part takes the configuration, and the constraints are checked
    The bitstream this project produces configures the device. Programmed
    over a remote hw_server, the board on one machine and Vivado on another:
    PROG: device xc7z020_1 part=xc7z020
    PROG: DONE before programming: 0
    PROG: DONE after programming: 1
    The DONE bit is what says it worked. `program_hw_devices` can complete
    against a device that did not take the configuration, which is the same
    shape as every other failure in this project's tooling: no error, and a
    plausible result.
    AND THE CONSTRAINTS FILE HAS A TEST NOW, which is the thing it has never
    had. Four defects in it, every one silent --- a `foreach` an XDC re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
    [cadr_arty.sv, cadr_arty.xdc]
2026-09-09 no memory is a slowdown, not a stall, and the board said so first
    docs/board.md predicted LD1 dark with nothing behind mem_*, reasoning
    that the machine reaches its first main-memory cycle and stalls there for
    ever. On the board LD1 blinks, very slowly.
    The prediction was wrong and the fabric is right. Nothing answering does
    not mean the cycle never ends: the NXM timer expires at about 4.25 us and
    the cycle completes as a non-existent-memory reference. The timeout is a
    real part of the design and it is doing its job.
    Simulated to put numbers on it rather than swap one guess for another ---
    cadr_machine with mem_done tied low, the step-1 bitstream exactly:
    first mem_req micr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
2026-09-09 what you need to build this, and what each toolchain does not tell you
    `docs/toolchain.md`. Two toolchains that answer different questions, and the
    document is organised around keeping them apart: `make check` needs Verilator,
    Rust and muir and no Vivado, and says the fabric agrees with muir; a Vivado run
    needs none of those and says nothing about that at all.
    Records the things that have each cost time here rather than the things an
    installer would tell you: that muir sits *beside* the checkout because
    `golden/Cargo.toml` says `../../muir`; that the Rust pin is at the root and not
    in `golden/` because rustup resolves from the working directory and would
    silently ignore it there; that only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
2026-09-09 the loader relocates the tree into the memory the tree reserves
    Ground for Linux on the PS. Findings only --- none of this has run on
    hardware, and the card was never written.
    The premise needed correcting first: there is no current prebuilt Digilent
    Linux image for the Arty Z7-20. The live releases are hardware and bare
    metal, Arty-Z7-OS is a README, PYNQ does not cover this board, and mainline
    has no Arty Z7 device tree. What rescues it is that a .bsp is a tarball and
    the 2017.4 BSP ships board-exact prebuilt images --- BOOT.BIN, image.ub,
    zImage, system.dtb --- extractable with tar and no PetaLinux install.
    Three that would each have cost days, all read from source rather than
    assumed: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
2026-09-09 the adder off the path, a port that carried nothing, and three records kept in the files
    Four things, committed together, each carrying its own reasoning in the file
    that owns it.
    **The 198 ps, and it is the first of this family that the boundary hold would
    have got wrong.** `ssyn_at` held `elapsed` when -UB SSYN came back, and the two
    deadlines were formed where they are read --- `elapsed >= ssyn_at + UB_ACK_T`
    --- putting a ten-bit adder in front of a comparator on a path leaving the
    module for `mfinish_t` and `rdfinish_t`. The sums are made once now, at the
    tick SSYN arrives, and the comparator sees a register.
    `rtl/cadr_machine.xdc` carries the rule rather than the five instances, beca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
    [cadr_busint_xbus.sv, cadr_machine.sv, cadr_machine_tb.cpp, cadr_memory_path.sv, cadr_microcycle.sv]
2026-09-09 six lights, and the one that was reading the wrong signal
    The board's status lights, and what looking at them taught.
    **LD0 is the heartbeat and LD1 is the machine**, in that order because the
    heartbeat is what is looked at first: it answers "is this running at all", and
    every other light is meaningless until it says yes. Between them they are the
    whole of "is it working" and they read across a room. LD1 counts microcycles at
    `beat[19]` rather than `beat[23]` --- 1.6 s with no memory and 0.23 s with it,
    so the same light reads in both regimes, where the slower bit was tuned to a
    machine that had memory and was invisible on the machine that did not.
    **LD2 shows a rate, not a flag.** `timed_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
    [cadr_arty.sv, cadr_arty.xdc]
2026-09-09 the card is free, and the device node is the thing to check
    The microSD card may be reformatted, so the note warning it off is replaced
    with the caution that actually matters: `mksd.sh` takes a device argument,
    and `/dev/sda` is what a card happens to be called on one laptop at one
    time. The shape of thing that destroys the wrong disk is not an unknown
    owner, it is a stale device node.
2026-09-09 the measurement behind the no-memory paragraph, and it dies with it
    `rtl/cadr_arty.sv` said the machine "stalls there for ever" at the boot PROM's
    first main-memory cycle. The board said otherwise --- LD1 was seen blinking,
    slowly --- and re-reading the RTL would only have produced another prediction.
    So the configuration the bitstream actually has was run: `mem_done` tied low,
    `mem_rdata` zero, exactly the instantiation in `cadr_arty.sv`.
    An unanswered cycle does not stall the machine. It ends on the NXM timer about
    4.25 us later and the machine goes on, seven times slow --- 1.50 us a
    microcycle against 0.22 --- so a light that should have been motionless blinks
    instead. Every number in `d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
    [cadr_nomem_tb.cpp]
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2026-09-09 the fit script asks whether its own constraints arrived, and the numbers get their commit
    `vivado/fit.tcl` is the script whose numbers get quoted as what the machine
    costs, and it was the one flow with nothing between `read_xdc` and a slack
    figure. `vivado/bitstream.tcl` has counted its exceptions since it was
    written; this had the blind spot the `foreach` bug lived in. Nothing in the
    repository would have noticed it reopening.
    THE ASSERTION IS ON THE PATHS, NOT THE EXCEPTION OBJECTS, and that is the
    whole of it. `report_exceptions` lists a `set_multicycle_path` whose
    `-from`/`-to` matched nothing exactly as it lists one that reached 10,972
    paths: the statement was read either way, so the o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
2026-09-09 the drawing carries the shipped commit's own fit, measured rather than inherited
    `c7bf9c4` put `8d86964`'s figures on the drawing and stamped the commit onto
    them, which was right at the time and is why this is a correction and not a
    repair. The board flow's answer moves with `rtl/cadr_arty.sv`: the same
    machine read -0.129 ns at `8d86964` and -0.384 at `2906166` on a change to the
    output fold alone.
    So the drawing now carries `6d2f98f`'s own numbers, place-and-routed at that
    commit rather than at one that resembled it:
    5.36% of the LUTs, 2,852 of 53,200
    20.00% of the block RAM, 28 tiles of 140
    no DSP
    -0.054 ns on ONE endpoint of 14,058, hold met at +0.084
    zero critical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
2026-09-09 the tool that will decide whether the board agrees, and fifteen ways it fails
    Nothing has ever compared what the *board* computes against what muir
    computes. The board's whole observable surface is six lights, so every
    hardware claim in this repository is currently an opinion about LEDs. This is
    the half of the fix that can be built without a board: given a capture read
    out of the fabric, it says whether the hardware agreed with the reference
    trace, row by row and column by column.
    IT IS TESTED BY BEING MADE TO FAIL, because no board is reachable from here
    and a comparison tool nobody has watched fail is not a check --- and this one
    will be the sole evidence behind every hardware claim that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
2026-09-09 the board agrees with muir, and the chain is measured rather than searched
    FIRST HARDWARE COMPARISON THIS PROJECT HAS EVER MADE. 1,024 microcycles read
    off an XC7Z020 over JTAG, diffed against `rtl.golden` column by column, exit
    0, nothing tuned and no tolerance anywhere in it:
    ok: 1,024 captured microcycles agree with muir's rtl engine
    23 of the trace's 40 columns compared
    microcycles 0 to 3ff, 1,024 of the trace's 600,000 (0.17% of the run)
    aligned at microcycle 0, and this is how: ...
    Until now every hardware claim here was an opinion about six lights.
    THE BUG WAS ONE CHARACTER, and not where the first diagnosis put it. The IDCODE
    scan drove TDI with zeros, so runni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
2026-09-09 the drawing gets its first claim about silicon, bounded on its face
    Everything the drawing has said until now was about simulation, or about six
    lights. The board's first 1,024 microcycles have been read back over JTAG and
    agree with muir column by column, so the whole-design note says that.
    Bounded where it is written, not in a footnote somewhere else: 1,024
    microcycles is 0.17% of the boot PROM's run, no memory cycle retires inside
    that window --- the machine's first is at microcycle 536,303 --- and eight of
    the twenty-three captured columns never change across it, so a stuck-at fault
    in any of those would have passed. `tools/probe_check.py` prints all three on
    its own output, which is wh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
2026-09-09 the readout script stops being the one thing nothing could run
    `vivado/probe.tcl` needs a board, so nothing exercised it, and it shipped with
    a one-character bug --- TDI driven with zeros where a chain terminates itself
    only on ones --- that made every readout fail. No check could have caught it
    because there was no check. `tb/cadr_jtag_chain.tcl` is a shift-chain model of
    the two devices a Zynq presents, and the bug now reproduces off the board in
    80 ms.
    IT ASSERTS THE LINE, NOT THE EXIT CODE, and that is the part worth keeping.
    "Fails on the check that names the fault" and "fails later, on a sample of
    zeros" are different claims and `vivado/probe.tcl`'s own header makes the
    first one; an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
2026-09-09 a suspect the check will never see, and the check that catches it instead
    The instruction-register capture failure named two explanations: a chain that
    is not the documented length, or Vivado returning a scan most significant bit
    first. Measured at `b1b9e3a` against `tb/cadr_jtag_chain.tcl`, **the second is
    unreachable**. A reversed scan puts the all-ones tail at the bottom, so the
    IDCODE parser terminates at once and reports zero devices, and the run dies
    four checks earlier at the device-count cross-check. Anyone reading that
    message on a real failure would have gone hunting for a bit-order problem that
    cannot produce it.
    And the check that does catch it did not know it was the one. The
    d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
2026-09-09 the lamps one to a row, two bars, and no sentences
    The drawing said in prose what it should have shown, and three passes took it
    off: a four-line note explaining that the board runs the boot PROM, a four-line
    block giving the fit, and then the heading over the bars, which the bars
    already say. `site/README.md` has always said this file is "the architecture
    drawing and nothing else --- no heading, no caption, no prose"; it had drifted.
    What is there instead is two readings and no writing.
    The six lamps, one to a row down the left, each with a coloured dot carrying
    the colour it was actually observed showing on the board --- three blinking,
    one very faint, blue for the boot PROM, red for a c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
2026-09-09 the widening gets a check, and the runner had been linting one board of three
    `37616d3` said plainly that the 32-to-64 conversion had no check of any kind.
    It is `rtl/cadr_axi_widen.sv` now, pulled out of `cadr_arty.sv`'s generate
    block so something can simulate it, with 200,000 conversions over 64 beats
    behind it and seven mutations to say the check can fail. Fourteen checks.
    THE EXTRACTION CHANGED NOTHING, and this is stronger than matching numbers:
    `cmp -l` on the two DDR=1 bitstreams reports **exactly four differing bytes,
    all inside the header timestamp**, with `SW_CRC` and `SW_HDR_SHA256`
    identical. The configuration data is bit-identical. -0.446 ns, 86 endpoints,
    954 registers, 28 ti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
    [cadr_arty.sv, cadr_axi_widen.sv, cadr_axi_widen_tb.cpp]
2026-09-09 the memory-off board closes, and the memory-on one is inside the noise
    With the memory on, the design at `cbb35ef` missed by 0.446 ns on 86
    endpoints; off, by 0.054 on one. Now:
    before after
    memory off -0.054 ns, 1 of 14,058 +0.077 ns, MET, 0 of 14,041
    memory on -0.446 ns, 86 of 14,787 -0.012 ns, 6 of 14,767
    The memory-off board is the first closure this design has had. **The
    memory-on board is not claimed as closed**: -0.012 is inside the quarter of a
    nanosecond CLAUDE.md calls placement noise, and a second routing of the same
    tree read +0.081 MET. It is within noise of closing and that is the honest
    phrase for it.
    N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
    [cadr_busint_xbus.sv, cadr_microcycle.sv]
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2026-09-09 step two: the fabric writes real memory and the processor reads it back
    THE FIRST TIME ANYTHING OF OURS HAS TOUCHED DDR. `vivado/prove_write.tcl`: the
    witness in the fabric writes one word through cadr_axi_master, the widening
    and the PS7's S_AXI_HP0 into DRAM, and the debugger reads it back through the
    ARM debug port --- two routes into the same cells, so a fabric wrong in any
    way cannot agree with the observer. PASSED three times at e1b4d5f:
    0x18A72EE4 0x8A5C36E1 the word, in the HIGH half of its beat
    0x18A72EE0 0x75A3C91E the low half of the same beat, untouched
    30 more 0x75A3C91E the neighbourhood, untouched
    The strobes opened one half of the 64-bit beat and not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
2026-09-09 step three: the fabric reads real memory and echoes it where the debugger can see
    Both directions of the memory path are now proved on silicon with the observer
    outside the design. `PROVE=2` no longer needs a person: the witness starts
    when the port comes live rather than on BTN1, reads the word at 0x18A72EE4,
    and writes what it read --- the word itself, not a verdict --- to 0x18A72F18,
    where the debugger reads it. PASSED on the board at 21459a1, all three cases
    on one bitstream download, four times:
    wrong 0x18A72F18 reads 0x8A5C36E0 the wrong word came back
    half 0x18A72F18 reads 0x75A3C91E the block filler: the right word in
    the wr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
    [cadr_arty.sv, cadr_prove.sv, cadr_prove_harness.sv, cadr_prove_tb.cpp]
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2026-09-09 the timeout lamp will not go dark when memory works, and the notes said it would
    Three predictions in docs/board.md, pre-registered before the memory existed,
    were measured against a Verilator harness with a DDR model behind
    cadr_machine and all three are wrong. The boot PROM's only main-memory
    traffic is 512 cycles --- PAGE-0-PARITY-FIX, an identity copy that reads each
    of the 256 words of page 0 and writes it straight back --- and its other
    16,951 bus cycles poll a disk controller that DDR cannot answer. So memory
    removes exactly 512 timeouts, once, in 380 us, and after 118.4 ms every cycle
    the machine makes is a poll:
    LD2 rate 0.78 s a period with memory, 0.78 s without --- ident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
    [cadr_arty.sv]
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2026-09-09 an unanswered read gives MD zero, test first, and the machine behind a DDR model is a check
    THE BUG. cadr_xbus_ddr's rdata register was loaded on a DDR read and never
    cleared, and cadr_memory_path selects memory_rdata whenever neither the Unibus
    nor a device answers. So every one of the boot PROM's 16,951 disk-controller
    polls loaded MD with whatever DDR had last returned. With DDR=0 that was
    always zero and nothing showed; six checks, two processor traces and a
    hardware capture passed over it. With DDR=1 it was the last word of page 0,
    and bit 0 of that word decided whether the PROM believed the disk was ready:
    set, it wrote a CCW to physical word 777 and halted at PC 40,
    ERROR-DISK-ERROR.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
    [cadr_ddr_boot_tb.cpp, cadr_xbus_ddr.sv]
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2026-09-09 the board notes carry the four memory steps, and three lamp facts are corrected
    docs/board.md had nothing about any hardware step past the LEDs. It now has
    "Bringing the memory up, in four steps": the four scripts in order, what each
    adds, what must exist first, the exact PASSED lines and the named failures
    quoted from the scripts rather than paraphrased, the provenance of each pass
    by commit, and the facts an operator will meet --- timeout on every debugger
    invocation and why, the two identity registers and which guard confused them,
    uninitialised DDR not being zero, the order against the bitstream download
    differing between the witness boards and the machine, the tally's two
    registers with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
    [cadr_nomem_tb.cpp]
2026-09-09 step five made ready: the card image stages, the loop falls back to the control, and a pinned tree would have eaten the ramdisk
    linux/mksd.sh has been run end to end for the first time, twice, from the
    archive now in vendor/: every size in docs/linux.md's table exact, the device
    tree byte-identical to the hand-built one (11 lines added, 0 removed, struct
    block 17,332 to 17,456), 0.79 s. Its grep -c fragility --- an empty result
    from a missing file reaching a numeric test as a shell error rather than the
    message the check exists to give --- is closed by a helper that dies naming
    the grep and the file, exercised both ways.
    THE FALLBACK IS THE CONTROL. default_bootcmd is `run uenvboot; run
    cp_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
2026-09-10 the disk controller's registers answer the boot PROM, and the machine is six times faster for it
    rtl/cadr_disk_controller.sv: the four registers at 17377774..7 as a
    combinational Xbus slave with no drive, held to muir over the boot PROM's
    600,000 microcycles. It takes muir's own name, src/disk_controller.rs, because
    the controller will be a bus master too when the channel lands and a slave-role
    name would be wrong that day. STATUS is built bit by bit as muir's status()
    builds it, cited to the line; three bits are constant-1 for nothing on the
    cable, <13> and <3> are live off the command register, and the header says in
    capitals that A WIRE RETURNING 0x2321 WOULD PASS THIS CHECK, since the PR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
    [cadr_ddr_boot_tb.cpp, cadr_disk_controller.sv, cadr_machine.sv, cadr_machine_tb.cpp, cadr_mem_count_harness.sv, cadr_nomem_tb.cpp, cadr_probe_harness.sv]
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2026-09-10 golden/src/disk.rs: the disk controller's scripted reference, and the model that agreed with it
    A generator in busint_xbus.rs's shape, driving muir's Controller directly
    through its public face --- read, write, status, interrupt, advance, attach,
    xbus_init, dma_written, and Unit's blank/write_block_at/write_sector_at/
    header_at/data_checkword_at --- and writing build/disk.golden with the stimulus
    and the expected outputs in one file, so the testbench and the model cannot
    drift apart. 0.1 s, 219,525 bytes. No muir change was needed and muir was not
    pulled; everything used is in origin/main.
    COVERAGE, off the trace's own header: all sixteen command codes, 00 through
    17, including the three th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
    [disk.rs]
2026-09-10 the drive and the register face, held to muir over 552 million ticks, and a check that had gone quiet
    Slice two of four. rtl/cadr_disk_controller.sv gains the drive: eight unit
    slots selected by DA<30:28>; the spindle as a tick counter --- spin += 5, wrap
    by subtracting REVOLUTION_NS, region against a threshold adding SECTOR_NS, no
    divider anywhere --- measured exact against muir's closed form; seek with its
    settle and per-cylinder time, the 12x17 multiply registered a tick ahead off
    da and the heads' position so it stays out of dev_ack's cone; on-cylinder,
    seek error, fault, read-only, per-unit attention and any-attention over all
    eight; the hang timer at exactly 512,000,000 ticks; -RESET E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
    [cadr_arty.sv, cadr_disk_controller.sv, cadr_disk_tb.cpp, cadr_machine.sv, cadr_mem_count_harness.sv, cadr_probe_harness.sv]
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2026-09-10 Read All and Write All, and the four disk records the channel slice left broken
    The disk controller's fourth slice: a track serialiser and a bit-level sector
    parser, so that Read All streams a whole track out of the block store as the
    pack would carry it and Write All parses one back. The track is held to
    itself as well as to muir --- 20,160 bytes serialised and compared against
    disk_unit::format a byte at a time, 51 blocks read back through the seam
    after the parser laid the same bytes down, with a preamble decoy in the first
    sector that a parser accepting after fewer than 49 ones takes. disk.pass over
    1,098 rows and 568,816,694 ticks; the two lma rows, three PAGE rows and two
    BLK rows that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
    [cadr_disk_controller.sv, cadr_disk_tb.cpp]
2026-09-10 Linux boots on the board with the CADR's memory kept from it; the card carries one line
    Step five, on silicon. Linux 4.9 from Digilent's image comes up under our
    device tree with mem=384M cma=32M: System RAM ends at 0x17ffffff, MemTotal
    380,320 kB, and the reserved node for 0x18000000 is in /proc/device-tree.
    The control boot --- server stopped, board reset --- reaches a login with
    512 MB. Both read off the console, the board reset over JTAG between runs.
    Three things the first boot overturned, each measured before it was changed:
    the BSP's loose zImage is build #2 where the kernel inside image.ub is build
    #1, and #2 dies after "Memory policy" under Digilent's own tree as well as
    ours, so t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
2026-09-10 the fallback is replaced, not guarded: cp_kernel2ram=reset on the card
    || reset on the end of the fetch line fired at the prompt on "File not found"
    and did not fire on the real boot path when the server's host was up and
    nothing listened: "TFTP server died; starting again", and the rest of the
    list never ran, and the board fell through to image.ub with the reset right
    there on the line. Measured with the server stopped and the board reset over
    JTAG. What works is to replace the fallback's own copy step: uEnv.txt is
    imported before default_bootcmd runs, so cp_kernel2ram=reset is what "run
    cp_kernel2ram" finds, and a failed fetch ends in "resetting ..." and another
    attempt ten seconds later.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
2026-09-10 the default boot puts the CADR in the fabric and starts Linux beside it
    uEnv.net's command fetches cadr.bit and loads it with fpga loadb before the
    tree and the kernel, so Digilent's FSBL brings up the processing system, our
    bitstream displaces theirs, and Linux boots under a tree with their amba_pl
    removed --- mksd.sh trims it, 10,472 bytes against 26,265. Measured with one
    reset over JTAG and nobody at the board: the CADR's counters at the PS7's
    boundary read 256 reads and 256 writes asked and answered with Linux at its
    login beside it, 384 MB. No BOOT.BIN of our own, nothing on the card changed.
    This kernel gates the GPIO block's clock, so a witness reading the counters
    from Linux turns A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
2026-09-10 the card is the product: U-Boot boots from the card by default, over TFTP only when the card names a server
    Another user has a board, a card and a monitor, not a TFTP server. U-Boot's
    default environment now loads cadr.bit, the tree, the kernel and the root
    filesystem image from the card's FAT partition and boots them; only when the
    card's uEnv.txt sets serverip does it take the network path --- DHCP,
    uEnv.net, the same five files fetched instead --- which is how this project's
    own board runs so its card is never rewritten for a change. Either path loops
    on failure; there is no fallback from one to the other, since a card naming a
    server must not boot stale files silently. The two paths shar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
2026-09-10 USB host comes up: the tree names its PHY with phys, not the deprecated usb-phy
    On the board the controller's glue bound, the PHY bound, and the host core
    it created never did --- silently. 6.19's ci_hdrc_probe looks for a PHY
    three ways and only the `phys` phandle can defer; with `usb-phy` (what every
    mainline Zynq tree carries) both lookups return -ENODEV, the probe exits
    -ENXIO through the one path with no message, and phy0 later binds to nobody
    from the deferred workqueue. `phys = <&usb_phy0>` and the root hub appears
    at 0.86 s: "EHCI Host Controller", "USB hub found", "1 port detected".
    DEBUG_FS on so devices_deferred and the ULPI registers can be read on the
    board; GENERIC_PHY pinned o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
2026-09-10 the USB host port's power is switched on at boot by an init script, measured on the board
    With the root hub up nothing enumerated; OTG Control read 0x27; one write
    through the controller's ULPI viewport set DrvVbus and DrvVbusExternal
    (0x67) and the keyboard enumerated within a second, three input devices.
    Mainline 6.19 has no path that does this for a ULPI PHY on this board: the
    ChipIdea core never writes OTG Control, the nop PHY's vbus is a regulator
    this board does not have, and no in-tree ULPI PHY driver matches. So the
    smallest correct thing, since USB input is last in the plan: S15usbvbus
    waits for the root hub and does the write once, with the register arithmetic
    and its sources in it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
2026-09-10 the disk's request path: the fabric tells Linux which block it needs, waits for it, and every GP0 address answers
    A START naming a block the store does not hold no longer misses: the
    controller posts the block's disk address --- unit, cylinder, head, block,
    the tag now 31 bits with the unit --- to a register Linux reads (REQ) and an
    IRQ_F2P line, waits for the fill, and continues as if the block had been
    there; a chained command list's next block is looked up and posted while the
    current one moves. A written slot is marked (DIRTY) until Linux moves it; REF
    records use for a second-chance replacement; IRQ/IRQEN carry request, dirty
    and move-done; a DENY bit lets Linux refuse a block off the p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
    [cadr_arty.sv, cadr_disk_controller.sv, cadr_disk_harness.sv, cadr_disk_pack.sv, cadr_disk_pack_tb.cpp, cadr_disk_tb.cpp, cadr_gp0_default.sv, cadr_gp0_default_tb.cpp]
2026-09-10 a lint check's "caught" and "did not build" share an exit status; the runner now reads the tool's words
    the-request-path-reaches-no-pin's first @new left a dangling comma --- a
    syntax error --- and the runner reported it caught: arty_check and
    cables_check returned CAUGHT on any non-zero Verilator exit, and for a check
    that is lint a finding and a refusal to parse are one exit status. Measured
    on Verilator 5.032: a finding prints %Warning-CODE and ends "Exiting due to
    N warning(s)"; a mutant that does not compile prints an %Error line and ends
    "N error(s)". lint_verdict reads them apart, both lint paths use it, and the
    offending mutant now reads DID NOT BUILD, exit 1. The record is kept with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
2026-09-10 the pack feeder serves on demand, and keeps the pack's headers and checkwords in a deletable sidecar
    Second revision, against the request path at ad21553. The feeder polls REQ
    every 250 us (a quarter of a sector's time, inside the smallest budget the
    controller's prefetch gives: a seek's settle plus rotational wait for a
    START, a sector for each chained block); answers with a 259-word record in
    the spare region, second chance over REF, a dirty victim written back first,
    never the walk's slot; denies a block off the pack or on another unit; sets
    the drive present once the pack is open. A missed budget is a transfer that
    waits, which the property run holds for 4,000,000 ticks. The interrupt pa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
2026-09-10 the feeder's third revision: no sidecar, and a write-back the walk's slot refuses is deferred, not a failure
    The board's one fault in 48,879 moves, status 0x5a: between a START and its
    first C_LOOK the channel is active, waiting on nothing, and ch_slot still
    names the previous transfer's slot --- for a Write, the slot that just went
    dirty --- so a write-back of it in that window is refused by bad_ch; the walk
    then misses, posts and waits, and the feeder read the live WAITING bit as
    the reason and called it a fault. The RTL is conservative, not wrong.
    Reproduced in the host model (a START state, and the fabric running on
    between the CTL beat and the status read): every Write followed at once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
2026-09-10 the TV: the display as an Xbus device, its frame buffer in DDR, its retrace interrupt joined to the machine's
    muir's simpletv is traceable and this is held to it tick for tick: a 32,768
    word frame buffer at 0o17000000, eight control words at 0o17377760, the mode
    register's four writable bits in the Am25LS2519 at NXBCTL 0F12 with bit 4 the
    74LS74 at 0E14 --- preset once a frame by -TVMA CLR, clocked by -LOAD MODE,
    cleared by -XBUS INIT and nothing else --- SEND INTR that flag ANDed with the
    enable onto -XBUS.INTR, and a frame of 15,456,000 ns, 3,091,200 ticks exactly,
    so muir's counter and the fabric's cannot drift.
    Neither reference program exercises the registers, measured: the boot PROM
    n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
    [cadr_ddr_map.sv, cadr_machine.sv, cadr_memory_path.sv, cadr_memory_path_tb.cpp, cadr_tv.sv, cadr_tv_tb.cpp, cadr_xbus_ddr.sv]
2026-09-10 the console: the sixteen diagnostic registers on M_AXI_GP1, and a program in Linux that halts the machine and reads its state
    rtl/cadr_console.sv presents muir's own console vocabulary to the processing
    system: page 1's word k IS diagnostic register k, so a read of it runs a
    diagnostic READ cycle and a write a WRITE cycle --- spy_read and spy_write
    reached over AXI, with rtl/cadr_spy_registers.sv untouched between them --- and
    page 0 carries IDENT, a status word and a 64-bit cycle and tick count whose
    high half is latched by the low half's read, because a counter read as two
    loads is wrong across a carry. Every address on GP1 answers, OKAY rather than
    SLVERR since a posted-write error on the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
    [cadr_console.sv, cadr_console_harness.sv, cadr_console_tb.cpp]
2026-09-10 the memory-on board closes again: the control store's address off TPCLK, and the disk's multiply out of the sum's tick
    8064411 read -0.462 ns on 278 endpoints, a third of a nanosecond beyond
    placement noise, and none of it in the display. Two changes in rtl/, none in
    the constraints file, and it reads -0.148 on 13 of 25,703, total negative
    slack -1.320 against -35.278.
    The control store's read address was `cpu_edge ? npc : pc`: four LUT levels
    from TPCLK to twenty-six block RAMs' address pins, cpu_edge at fanout 292,
    4.775 ns of a 5 ns tick, 116 endpoints. It is `pc`. The mux bought one tick
    of twenty-nine where the shortest generator cycle is twenty-seven: what IR
    takes at a boundary is th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
    [cadr_disk_controller.sv, cadr_microcycle.sv]
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2026-09-10 the console's read-back was outside the constraints file's reach, not too deep: -12.837 ns becomes -0.159
    The path was MD through the M bus's source mux, through the sixteen-way
    diagnostic read mux, into the console's read-back register: twenty-four
    levels, and nothing at the far end could shorten it, since any register
    sampling that mux inherits the same cone. The deadline was wrong, not the
    depth. cadr_machine.xdc already relaxes slow-to-slow to fifteen ticks and
    md_reg is in slow --- but the file is read scoped to cadr_machine and the
    console's register sat a level above it in cadr_arty.sv, so the arc was
    slow-to-fast, which the exception does not match and must not. The same wall
    mem_add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
    [cadr_console.sv, cadr_console_bus.sv, cadr_console_harness.sv, cadr_console_tb.cpp, cadr_memory_path.sv]
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2026-09-10 a record says whether the build refusing it is the catch: @build-fails
    The runner's new lint classifier, right about the dangling comma, was wrong
    about the cable check: `cables` mutates a GENERATED header and the header
    failing to elaborate IS the finding, so a-signal-is-renamed and
    a-bidirectional-wire-loses-its-enable went BROKEN the moment the classifier
    landed. The record declares it now with @build-fails, and only then is an
    %Error the catch --- and a record that declares it and then builds is BROKEN
    too, which is the other half of the claim. Without the line the strict
    reading stands, which is what caught the comma. --only cables 4 of 4 caught;
    the self-test's nine arms green.
    Co-Aut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
2026-09-10 muir.commit pins the reference, and CI tests the pair
    Every trace in golden/ is muir's own behaviour written down, so a commit here
    means nothing without the commit of muir it was generated against: the same
    generator over a different muir is a different reference, and a check may pass
    against one and fail against the other for reasons that have nothing to do
    with the fabric. This was carried as a rule about when to pull, which is
    discipline where it should be a fact in a file.
    muir.commit names the SHA, `make muir-pin` says whether the muir beside this
    repository is it and runs as part of `make check`, and CI checks that commit
    out rather than muir's main branch. It warns rather than fails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
2026-09-10 the program is cadr-terminal, as muir calls the same thing
    muir's own name for it is `terminal`, and "terminal" is not a word the Lisp
    Machine uses for anything else, so it collides with nothing. The program is
    muir's terminal in C already; now it is called that. Renamed before it ever
    reached the board, which is the cheapest moment, and the stale-file trap that
    has already cost a build is avoided by clearing the target rather than
    trusting Buildroot to.
    The drawing's boxes take the packages' names with what they are underneath:
    terminal, serial, console.
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2026-09-10 the drawing's lamp comment says what is drawn
    Six lamps are drawn and the comment beside them still described the two that
    survived an earlier cut. They came off in an earlier change and went back
    with an assignment made one lamp at a time, so the comment was describing a
    block that no longer exists.
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2026-09-10 docs/tv.md: the two claims the first correction missed
    An earlier pass caught one of the three passages that said the disk's
    interrupt was computed and never brought out. These are the other two: the
    paragraph that called -XBUS.INTR half in the fabric and named `sintr` as
    something a board outside it supplies, and the line in what the check cannot
    hold to. Both now say which half of the gate is exercised and which is not:
    the disk's is held by two processor traces, the display's is still a claim
    nothing exercises because neither reference program enables it.
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2026-09-11 the console can restart the machine, and only on purpose
    A soft reboot from the processing system: the board runs Linux on the Arm cores
    beside the CADR in fabric, and restarting the machine should not mean a power
    cycle or a re-programme. Page 0's word 6 is that, and it is the one word of
    that page anything may write.
    A write of "RSET" and of nothing else pulses the machine's reset, joining the
    button rather than replacing it. The key is chosen the way this project
    chooses every such constant: four distinct bytes, none of them zero or all
    ones, halves that differ, and not equal to anything the fabric already answers
    with --- and because no byte of it is zero, a partly-strobed write cannot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
    [cadr_arty.sv, cadr_console.sv, cadr_console_harness.sv, cadr_console_tb.cpp]
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2026-09-11 the I/O board in fabric: the keyboard, the mouse and the two clocks
    Slice two of MIT's own card, checked against the reference slice one wrote out
    of muir's own model. It passed on its first build, which is what the Python
    model in slice one was for.
    The check fails against an empty module on the power-on face and on the first
    bus cycle, which was written and shown before any of the card existed. What it
    holds to: the acknowledgement at the trace's instant and at no earlier tick,
    at all two hundred phases of the Unibus strobe inside the card's own
    microsecond; the word on all 837 reads; the whole face --- the status
    register's flip flops, both mouse counters, the mains clock's ready bit, th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
    [cadr_io_board.sv, cadr_io_board_tb.cpp]
2026-09-11 the console can read the two registers that decide the diagnosis
    The board halted inside PDL-BUFFER-REFILL, where the microcode hacks a map
    entry and then reads through it. Three different faults injected into muir
    reproduce the board's console readout bit for bit --- same PC, same OPC, same
    both flag words, same instruction register, same A, M and OB --- so nothing
    the sixteen diagnostic registers can say separates them. What separates them
    is the virtual address register against Q: the map-side faults leave the two
    equal, the wrong-address fault leaves them a page apart. Neither is on MIT's
    diagnostic bus, which is why they needed wires of their own.
    The capture is a module inside cadr_ma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
    [cadr_arty.sv, cadr_console.sv, cadr_console_harness.sv, cadr_console_state.sv, cadr_console_tb.cpp, cadr_machine.sv, cadr_mem_count_harness.sv, cadr_probe_harness.sv]
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2026-09-11 the documents say what is true, and the README says what the tree now is
    The rewrite that went in before this one promised to change no content, so
    everything it found that was wrong rather than merely dense was left alone and
    reported. This is that list.
    **The toolchain document named the wrong Vivado licence tier.** It said ML
    Standard. The licence here is BASIC, and the difference is not cosmetic: BASIC
    refuses to create a debug core outright, so Vivado's scripted debug flow is
    unavailable and marking a signal for debug is useless without one. That wrong
    belief has already cost time, and the toolchain document is exactly the file
    somebody follows when setting up. It now says which tier t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
2026-09-11 the card sizes are sized against what a card really holds
    The table said a 2 GB card takes a 1,856 MiB pack partition. It does not. A
    card sold as 2 GB is 2,003,795,968 bytes, which is 1,910 MiB, and that image
    would have been 1,921. The rows are computed now, against the real capacity of
    each size with 16 MiB spare on top of the partition table's megabyte, and they
    are 832, 1,792 and 3,584.
    The failure this avoids is worth naming, because the answer to what happens is
    not "it fits less". An image larger than the card fails part way. The boot
    partition is written, because it comes first and is only 64 MiB, so the board
    boots. The pack partition is left truncated while its filesystem claims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
2026-09-11 the top level connects MD, which the commit that added it did not
    A staging mistake, and it made the board lie. The MD slice touched five files
    under `rtl/` and `tb/` and one more at the top level, and the change was
    staged by directory paths that had been right before the move and were not
    after it: `boards/arty-z7-20/cadr_arty.sv` is no longer under `rtl/`. So
    13d499c committed the machine's new port and not the wiring of it.
    The gate did not catch it because `make check` ran against the working tree,
    where the file was correct. HEAD was not what was checked.
    What it cost: the bitstream on the board was built from HEAD, so the console's
    MD port was unconnected, and synthesis said so in a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
    [cadr_arty.sv]
2026-09-11 the release card is one image for a 4 GB card, and it carries no pack
    One released image, one size to state, and the size is four gigabytes because
    the bay is built so that somebody who fills all eight units never has to
    rewrite the card. The image is 2.28 GB of which almost all is an empty bay, and
    it compresses to 7.1 MB, measured rather than guessed.
    It carries no disk pack. A band is the user's own to supply, and partition 2
    being plain FAT32 is what lets them drop one on from any operating system with
    the card in a reader, rather than needing the board on a network first.
    Writing it costs twelve megabytes of real I/O rather than 2.28 GB, because
    `conv=sparse` skips the zeros. Windows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
2026-09-11 two scripts, one for the release card and one for this project's own
    A release and a development card differ in two ways that matter and both were
    variables somebody had to remember, which is the shape of a mistake waiting to
    happen.
    `mksd-release.sh` carries no pack, names no server, and sizes the bay to fill
    a 4 GB card. It refuses to run if PACKS is set. And it does not trust its own
    standalone flag: after staging it greps the card for anything address-shaped
    and stops if it finds any. A flag can be wrong, and a private address on a
    public artefact cannot be taken back. Measured end to end: 3.83 GB of image,
    7,365,824 bytes of download, and it printed "no address of any kind on the
    card"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
2026-09-11 never write the card with conv=sparse, measured the hard way
    The first write of the two-partition card was made with `conv=sparse`, which
    e1ae17f recommended on the argument that it saves writing 3.5 GB of zeros. It
    saves them by not writing them, and that is the bug. Wherever the image holds
    zeros the card keeps whatever was there before, and a disk pack is full of
    legitimate zeros.
    What it looked like: the image's md5 matched on the laptop, both partitions
    mounted, every boot file was correct, and `disk-pack-0.img` read back with a
    different md5 --- the previous card's pack showing through the new one's zero
    runs. A healthy-looking card carrying a disk that is not the disk it says.
    Writte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
2026-09-11 MD must still hold what its own instruction put there, and now something says so
    and its three registers say two separate things went wrong. This is the check
    for the second one. Nothing is fixed here.
    MD has two writers in one clocked block: the microcode's own word, and a word
    arriving from the bus. At a boundary where a word is pending the microcode
    wins and the pending flag clears. But if the bus word arrives on that very
    tick, the first branch runs, the clearing branch never does, and the stale
    word commits one boundary later --- or at the very next tick, since a hang is
    not a boundary. MD is the map's index,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
    [cadr_md_hold_tb.cpp, cadr_md_inject_tb.cpp]
2026-09-11 one tick is 6.25 nanoseconds, and both boards meet their timing
    The aim is to take timing off the list of things that can threaten the
    machine's correctness. The memory-on board has never closed. It has been
    reported as inside placement noise and not claimed as closed, run after run. It
    closes now, and so does the memory-off one.
    memory-off +0.375 ns, 0 failing of 16,316
    memory-on +0.362 ns, 0 failing of 27,578
    out of context +0.131 ns, 0 failing of 20,404
    WHAT CHANGED IS HOW LONG A TICK LASTS AND NOTHING ELSE. Every instant the CADR
    names is a whole number of ticks and every one of those counts is MIT's own.
    The oscillator is 125 x 8 = 1000 MHz exactly, so the clock g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
    [cadr_arty.sv, cadr_arty.xdc, cadr_busint_xbus.sv, cadr_console.sv, cadr_console_bus.sv, cadr_console_state.sv, cadr_disk_controller.sv, cadr_disk_pack.sv]
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2026-09-11 one tick is 10 nanoseconds, and timing stops being a variable
    The reason is the margin rather than the number: a timing concern is answered by
    a longer tick. There was a concern and it was measured. A one-character change
    to a multiplexer took the memory-on board from +0.103 to **-0.261 and out of
    closure**, because the design has sat near zero since the memory readout landed.
    Earlier work had already gone into explaining a register that read zero on a
    board that did not meet its timing.
    memory-off +1.537 ns, 0 failing of 25,525
    memory-on +0.657 ns, 0 failing of 38,593
    out of context +1.447 ns, 0 failing of 30,596
    Measured at the same commit: 6.25 ns fails at -0.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
    [cadr_arty.sv, cadr_arty.xdc, cadr_busint_xbus.sv, cadr_console.sv, cadr_console_bus.sv, cadr_console_state.sv, cadr_disk_controller.sv, cadr_io_board.sv]
2026-09-11 a checkpoint of the board's machine, and the pack bound to it
    The board's state can be written in muir's own format now, so a machine that
    has gone wrong on silicon can be opened in muir and everything muir can do
    applies to it --- including running it forwards, which is a sharper question
    than any readout.
    It was built once and removed on a misread of a redirection. This recovers it
    rather than rewriting it: the recovered directory is byte-identical across all
    five mutation trees it survived in, and it was rebuilt and round-tripped through
    muir untouched before a line changed.
    THE PACK IS BOUND TO IT. A checkpoint holds the blocks written during a run and
    not the disk itself, and the boar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
2026-09-11 the whole machine against muir on the band, and where that has to stop
    Every check here compares the processor against muir with the bus, the memory
    and the acknowledgements supplied from muir's own columns. `cadr_machine` ---
    the processor with the real bus interface, the real memory path, real memory
    behind it and the disk controller under it --- had never been compared against
    muir while running microcode 323 at all. That is the gap the recent bugs have
    lived in.
    **It agrees exactly for 1,062,507 microcycles, with no exemption of any kind
    and the two clocks matching to the nanosecond.** 524,650 of those are past
    microcycle 537,857, where this trace and the boot PROM's part company, so th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
    [cadr_band_tb.cpp]
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2026-09-12 the bus interface answers for itself, and the interrupt storm loses its first cause
    `build/iob.pass` has been naming what was missing in its own output for
    days: "NOT ANSWERED HERE AND ANSWERED BY muir: 32 addresses, the bus
    interface's own interrupt control and error status registers at
    0766040-0766076 and the Unibus map at 0766140-0766176, none of which is
    built." They are built. That line is gone because it was closed, not
    because it was edited.
    `rtl/machine/cadr_busint_regs.sv` is the third slave on the Unibus:
    0766040/0766042 the interrupt status register. LOCAL ENABLE in bit 1
    is a jumper and comes up set; CONTROL_MASK 036001 and
    CONTROL2_M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
    [busint_regs.rs, cadr_arty.sv, cadr_busint_regs.sv, cadr_busint_regs_tb.cpp, cadr_machine.sv, cadr_mem_count_harness.sv, cadr_memory_path.sv]
2026-09-12 the drawing says where the work is: the debug cable adapter is in hand
    `site/index.html` shows what is being worked on right now, and this file's
    own rule is that the `under development` colour must be on the thing
    actually in hand and must move in the same commit as the work. The adapter
    is in hand: muir issue #95 is closed and muir's half is implemented on
    muir's main at `e4d8aeb`, so the fabric's half now has a finished
    counterpart to be held to rather than a specification to guess at.
    The block goes from `not started` to `under development`, and the alt text
    with it. Nothing else on the drawing moves, and no figure on it changes.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
2026-09-12 the debuggee's end of the debug cable, and a debugger that halts the machine over it
    muir issue #95 is closed and muir's half is implemented on muir's main at
    `e4d8aeb`, so the fabric's half has a finished counterpart to be held to
    rather than a specification to guess at. This is that half.
    `rtl/machine/cadr_dbgin.sv` is MIT's own DBGIN page: the 74S139 at 0A15
    decoding `DEBUG IN A<1:0>` into four strobes, the modifier register at
    0A16, the two address latches at 0A18/0A19, the error-status driver at
    REQERR 0B15, and the debug master's place on the Unibus. Its header
    names the muir types it is held to, and says where it parts from muir:
    the arbiter is `cadr_console_bus`'s, not MIT's NPR/N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
    [cadr_console_bus.sv, cadr_console_harness.sv, cadr_dbgin.sv, cadr_dbgin_harness.sv, cadr_dbgin_tb.cpp, cadr_debug_window.sv, cadr_memory_path.sv]
2026-09-12 one transaction per bus cycle, and the hole that had no check at all
    The board's page-hash-table word is the faulting virtual address rather
    than a page table word, and the memory data register has been exonerated
    by measurement, so the corruption is a WRITE that should not have
    happened. `cadr_memory_path.sv` loads `wdata <= md` at MEMGO regardless
    of direction, so on every read the whole of MD stands on `mem_wdata` at
    the bridge --- 256 of 256 reads, asserted here rather than observed in
    passing. One unwanted write therefore replaces a memory word with MD, at
    the read's own address, silently. NOTHING IN THIS REPOSITORY COUNTED
    TRANSACTIONS PER BUS CYCLE. `cadr_axi_master.sv` counts han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
    [cadr_bus_audit.sv, cadr_bus_audit_harness.sv, cadr_bus_audit_tb.cpp, cadr_bus_audit_unit_tb.cpp]
2026-09-12 the fabric does not have the board's bug, measured over 171 million microcycles
    The board halts every run with one word of MIT's page hash table holding
    the faulting virtual address instead of a page table word, and the
    question was whether `cadr_machine` does that in simulation. **It does
    not.** That is the result, and it is the most useful answer available,
    because it moves the suspect off the machine entirely.
    `tb/cadr_hash_watch_tb.cpp` is `band`'s harness run free rather than
    compared, with four instruments on it: a watchpoint on a physical word,
    a transaction counter per bus cycle, an invariant that no write goes out
    that the processor did not ask for, and a count of the lit pixels.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
    [cadr_hash_watch_tb.cpp]
2026-09-12 the adapter and the widening are innocent too, and a pack block reaches memory through them
    The previous run cleared `cadr_machine` over 171 million microcycles, and
    said the defect must be in what that harness replaces with a model: the
    adapter, the widening, the PS7 and the DDR3 controller on one side, the
    disk seam on the other. This clears the first two.
    `tb/cadr_band_axi_harness.sv` composes `cadr_machine` into
    `cadr_axi_master` into `cadr_axi_widen` onto a 64-BIT AXI3 PORT, wired as
    `cadr_arty.sv`'s `g_ddr` wires them, **with the disk seam brought out so
    the band can boot**. `make band-axi` runs it. Two runs to 13,062,508
    microcycles each, off a freshly decompressed archive pack wh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
    [cadr_axi_channel_tb.cpp, cadr_band_axi_harness.sv, cadr_band_axi_tb.cpp]
2026-09-12 the drawing's figures are the build that is on the board
    A fit at `ee77641` with the whole disk in it, the memory-on board, so the
    figures under the fabric's label are what the part actually holds:
    slices 3,304 of 13,300 24.8% (was 3,160, 23.8%)
    LUTs 9,643 of 53,200 18.1% (was 9,543, 17.9%)
    BRAM 178 KB of 630 KB 28.2% unchanged
    slack +0.868 ns, 0 of 39,442 failing (was +0.657, 0 of 38,593)
    The growth is the bus interface's own Unibus registers, which landed at
    `28424be`.
    **And the slack labels nearly came off, which would have been wrong.**
    CLAUDE.md says timing closure does not belong on the drawing because it
    is the fastest-rotting number her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
2026-09-12 the display goes green: the board has painted the machine's own screen
    The drawing's rule is that green means the board itself has shown it and
    turquoise means the checks pass here and it has not run on silicon. The
    display block has been turquoise since it landed. It is green now.
    The CADR on the Arty booted MIT's Lisp Machine system and painted it:
    the window system, a Lisp Listener, the error handler with a live
    backtrace, and the who-line reading `USER: Keyboard Cold-booted`. Read
    off the board over RFB. **20,741 lit pixels of 739,584**, which is
    muir's own figure for the same band booted to the same place, already in
    CLAUDE.md from the display-timeline work. The only error on the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
2026-09-12 the interrupt handler's one register, written down for other implementations
    The board's halt turned out to be a missing Unibus slave, and this
    matters to anyone writing a CADR emulator or a second implementation, and
    it is not the kind of thing found by reading one's own code.
    `docs/isr.md` is the account. Every interrupt arrives at `INTR` in
    `uc-interrupt.lisp`, and the handler's first act after saving VMA and MD
    is to read Unibus `766040`, the bus interface's own interrupt status
    register. It classifies the interrupt by what it reads there. Two
    instructions later it branches on bit 1, `LOCAL-ENABLE`, and MIT's own
    comment says what a zero means: "jump on no local-enable, ie, PDP11
    arb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
2026-09-12 the pack side stops being a stand-in: real fabric, mastering its own port
    `rtl/plumbing/cadr_disk_pack.sv` has been played by a testbench in every
    harness in this repository --- in `machine`, in `band`, in `hash-watch`,
    in `band-axi`, everywhere. `disk_pack.pass` holds it to properties on a
    directed stimulus and NO WHOLE-MACHINE CHECK HAS EVER CONTAINED IT. That
    is a block store, a request path and a write-back with no check that the
    machine can actually reach them, and it is the shape of hole this
    project's own history keeps finding bugs in.
    `tb/cadr_pack_axi_harness.sv` instantiates it for real, with an
    `S_AXI_HP2` slave behind it and GP0 register stimulus standing in for
    the Linux prog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
    [cadr_pack_axi_harness.sv, cadr_pack_band_tb.cpp, cadr_pack_channel_tb.cpp, cadr_pack_linux.h]
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2026-09-12 the card's last four, and one of them was proved absent rather than built
    Four things were left out of the I/O board because they are unfalsifiable at
    the current seam, and they belong in it even if they are not testable or
    usable yet. That reverses this project's usual default and the reasoning is
    in CLAUDE.md: the default is about CHECKS, not about the machine. A check
    nothing exercises is worthless; a register the fabric lacks is a way this is
    not the CADR.
    Three were built. **The fourth does not exist, and MIT's netlist says so.**
    `TIMER.IEN` occurs exactly twice in the whole of `data/CADRIO.netlist`: p12
    of the 74LS174 at LMUCON 0B20, a Q of the register a CSR write loads, sitting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
    [cadr_arty.sv, cadr_band_axi_harness.sv, cadr_bus_audit_harness.sv, cadr_gp0_split_harness.sv, cadr_io_board.sv, cadr_io_board_tb.cpp, cadr_machine.sv, cadr_mem_count_harness.sv]
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2026-09-12 muir on the board, the pack CC comes on, and a MAC that was leaking onto release cards
    Three things, and the third is the one that matters most.
    **muir IS A PACKAGE, BUILT NOT VENDORED.** No binary in this repository:
    `boards/arty-z7-20/linux/buildroot/package/muir/` builds from muir's own
    git by Buildroot's cargo infrastructure, read out of Buildroot's own
    `adding-packages-cargo.adoc` rather than guessed, **at the SHA read from
    `muir.commit`**. So the pin is the version, a pin move is a new build
    directory Buildroot rebuilds by itself, and no SHA is written into the
    package. With a pin file holding no SHA the build exits 2 and says so.
    the tarball 8.6 MiB; the kept clone 47 M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
2026-09-13 the drawing stops saying two finished programs are being worked on
    `under development` is reserved for what somebody is working on NOW, a rule
    made when the disk controller was found still carrying that colour while the
    work had moved to the processing system. The Chaosnet and the serial line
    carried it because the slice building them set it, and that slice finished:
    both programs are built, checked on the build host with no board, and their
    fabric halves are in the card.
    They are `simulated` now, which is the honest word: the checks pass here
    and neither has run on silicon. The alt text follows the colours rather
    than being left to drift from them.
    Nothing else moved. In particular **m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
2026-09-13 Vivado runs on an Ubuntu it does not support, and README says how
    Vivado 2026.1 does not list Ubuntu 26.04 as a supported operating system.
    It runs here, and until the release notes catch up the adaptation is worth
    writing down for anybody reproducing this.
    Two halves, and only the second is a workaround.
    Package names moved. AMD's own `installLibs.sh` asks for `libtinfo5`,
    `libncurses5`, `libncurses5-dev`, `libgdk-pixbuf2.0-dev` and `libasound2`;
    the same list with current names installs and works. The script cannot
    report the difference: every library is a separate `apt-get install -y`
    piped into `tee`, with no error handling, so the run reaches the end and
    reports success with librari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
2026-09-13 the loader splits in two on the drawing, and only one half is ours
    U-Boot is upstream and this project does not write it, but the first stage
    runs a start-up routine generated here and the board boots from it. One box
    could not say both, and three single-word replacements were considered earlier
    and each failed: "boot: SPL, ps7_init" does not fit a narrow strip, "boot
    loader" and "loader" name a category rather than a component, and "SPL" alone
    names only the first stage where the block covered both.
    So the block is two boxes. U-Boot goes grey, which is already the drawing's
    marker for what is outside the project and what muir and the DDR controller
    carry. Inside it a small green box say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
2026-09-13 a viewer's keys and pointer reach the card, and the seam that carried nothing
    The card has had the keyboard's shift register and the mouse's quadrature
    counters since its second slice, and the top level tied all three inputs to
    constants. Four pieces close that: the far end of the card's other two
    cables on a fourth page of the general-purpose port, the splitter's fifth
    target, the RFB server no longer discarding key and pointer events, and the
    wiring at the top level.
    What a key is, read out of muir rather than assumed: a 24-bit word with no
    modifier bits in it at all, because MIT's own keyboard document says all key
    encoding including the hacking of shifts is done in the central machine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
    [cadr_arty.sv, cadr_gp0_split.sv, cadr_gp0_split_harness.sv, cadr_gp0_split_tb.cpp, cadr_input_cables.sv]
2026-09-13 the board notes state their decisions without naming anybody
    This repository is public and its files should be about the machine rather
    than about the people working on it. The three board notes carried personal
    names, quoted remarks and the dates of those remarks, all of which say
    something about us and nothing about the boards.
    Every decision they recorded survives, stated as a fact. The Cora is the
    target variant, it comes first because it is worth settling before the display
    output block starts and because it is the tightest of the four, and the Z7-10
    is ruled out because it is no longer sold. Whether the design fits the
    XC7A100T or the XC7S50 is an open question and the checking has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
2026-09-13 the rebuild list derives itself, and the terminal takes a key map off the card
    THE LEAD IS A LIVE BUG AND IT WAS NOT THE ONE BEING LOOKED FOR. Buildroot
    does not watch our files, so `buildroot-rebuild` names the packages that have
    to be forced. That list was written by hand and it had gone stale: it did not
    name `cadr-checkpoint`, which is built from sources in this tree and has had a
    build stamp for a long time, so every rebuild since had left it alone and
    shipped whatever was built first. That program is how the board's main memory
    is read into a checkpoint, which is the only way that memory can be read at
    all, so a stale one is a stale instrument in the middle of a diagnosis.
    Adding o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
2026-09-13 the debug cable's status byte stops being a constant zero
    The cable's carrier was wired to a literal zero where MIT's board assembles
    eight real nets, and two modules held the values and did not bring them out.
    They do now: the bus interface's register group gains one output carrying the
    seven bits that are its own, and the Xbus interface gains one carrying its
    busy line, which is the eighth. Neither crosses the machine's top level, so
    nothing had to be threaded through three modules to reach the page.
    THE BIT POSITIONS CAME FROM THE PINS. Both parts that drive those lines on
    MIT's error page take the same eight nets, and the netlist gives the pairing
    pin by pin for each; the two agree in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
    [cadr_busint_regs.sv, cadr_busint_xbus.sv, cadr_dbgin.sv, cadr_memory_path.sv, cadr_unibus_tb.cpp]
2026-09-13 the cable goes on two Pmod connectors, and the drawing's premise was wrong
    The drawing has said for weeks that the adapter puts the cable's wires onto
    two connectors of eight pins each, one clock and seven data. That was written
    before anything was built, this repository's own rule says a beat count goes
    on the drawing only when somebody has built the adapter, and building it shows
    the premise does not hold.
    ONE CLOCK AND SEVEN DATA CANNOT WORK ON THIS BOARD, for two reasons that are
    independent of each other.
    One Pmod cable joins one board's outgoing connector to another's incoming one,
    so its eight wires carry both directions: twenty signals towards the debuggee
    and nineteen back. Shar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
    [cadr_arty.sv, cadr_arty.xdc, cadr_dbg_join.sv, cadr_dbg_pmod_harness.sv, cadr_dbg_pmod_tb.cpp]
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2026-09-13 a cable from one connector to the other is not a loopback test
    The Pmod section said a cable from a board's own outgoing connector to its own
    incoming one exercises the whole carrier, and called it the cheapest way to
    try it on silicon with one board. That is wrong, and following it would
    corrupt a debug session rather than merely waste an afternoon.
    The outgoing connector carries what the register window is asking, and the
    window is already asking it at the join directly. The returning copy arrives
    about a frame later at the arm the join does not prefer, so it contributes
    nothing while the window holds. Then the window lifts. The join sees no
    request from the near arm, the echo is stil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
2026-09-13 a card can name more than one Chaosnet peer
    The peers file has always been one station a line and the emulator has always
    taken a repeated flag, so the format supported several neighbours from the
    start. Only the card script assumed a single value, writing one line and
    passing one flag.
    It takes a whitespace-separated list now. A machine on a cable usually has
    more than one neighbour: a development setup here has both a bridge and the
    host the band resolves its system host to, and a card that can only name one
    of them has to choose between routing and a date.
2026-09-13 the pin moves four commits of muir, and not one trace moves with it
    muir.commit goes from ff5de42 to d6eac6d. Two of the four commits are
    Chaosnet over UDP and are what the next commit follows: the cable and
    the address switches become two flags, with a peer flag refused when
    the cable is absent; and a default peer replaces dynamic learning, so a
    frame whose destination no peer names goes to one endpoint, the route of
    last resort, instead of nowhere, and nothing is learned from arriving
    packets any more. The other two are documentation and a disk-controller
    netlist variant that only muir's chip engine reads.
    All ten golden traces were regenerated at the old commit and at the new
    one and com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
2026-09-13 one rc file a station, and a default peer as the way out
    The card's Chaosnet settings were three files, each holding one value
    and each read by its own line of shell. That broke on the board: the
    files are CRLF so a card reader can edit them, the address and the port
    were stripped of whitespace but the peers were word-split with the
    carriage return still on them, the parser refused the port as having a
    stray character after it, and the program exited at start with the
    service reported as running. So the fabric station is now configured
    the way muir is: one file, fpgarc, in muir's rc format, one flag a line,
    beside muirrc for the station inside muir. The init script reads it,
    drops comments a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
2026-09-13 the Chaosnet program waits for the network it is about to name
    On the board the Chaosnet service died at every boot: the program
    resolves each peer's name once at start, as muir does, and exits when
    a name has no address, and it was started before the interface had
    one. BusyBox's DHCP client is built here with -b, so it backgrounds
    itself when its first request is unanswered, the network script
    returns at once with the interface bare, and the link comes up at 5.4
    seconds, after every init script has run. The init script had printed
    OK and left a pid file with nothing behind it, which is what made the
    death quiet.
    The init script now waits, up to 30 seconds by the board's own uptime,
    for the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
2026-09-13 the single-step check's two files, which the previous commit named and did not carry
    The commit before this one added the sstep check to the Makefile and
    the mutation list and did not carry the generator or the testbench,
    golden/src/sstep.rs and tb/cadr_sstep_tb.cpp, because the diff it was
    built from was a diff of tracked files and the two were new. At that
    commit make check stops at the missing testbench and the mutation run
    stops at the missing trace. This commit is the two files; nothing else
    changes. A diff of a worktree does not carry its new files, and a
    handover has to list them separately or the tree lands unable to build
    the check it claims.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
    [cadr_sstep_tb.cpp, sstep.rs]
2026-09-13 the debugger's pack is built on a pack that knows the machine's own network
    The first CC pack was built on the System 304 release, so its band was
    the release's own station calling the release's own file host, and on
    this board it reached no server and asked for a date at every boot,
    while the fabric machine beside it booted from a pack whose site files
    name this network's hosts and took its date from the network. The
    pack tool now takes a base pack and a directory of site files: the
    base is copied writable and its spare partition receives the band, and
    the site files replace the release's own under the file service the
    build serves, so the band asks the right host table, machine locations,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
2026-09-13 transmit-empty does not rise on a transmitter that has been turned off
    With the frame fix in, the board's serial line carried one burst and
    never a second: at 300 baud the whole first string came out, the next
    sent nothing and the machine spun in the Unibus channel interrupt with
    the transmitter enabled, the holding register empty and transmit-empty
    set. MIT's driver ends every burst by writing the command register with
    the transmitter disabled while the last character is still in the
    shift register. That character drained, and the card set
    transmit-empty on the drain without asking whether the transmitter was
    still on; the status mask hid it while the enable bit was clear, and the
    next enab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
    [cadr_gp0_split_tb.cpp, cadr_io_board.sv]
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2026-09-13 a halted machine's finish timers pass the acknowledgement as a level, and a halt no longer parks the ring
    On the board the fabric machine deadlocked about one time in three when
    the debugger entered, and a plain console halt at the wrong instruction
    does the same: every diagnostic register reads one constant, the
    microcycle counter stops while the tick counter runs, and RUN, a step,
    the console's step and the debugger's clock are all inert until reset.
    The loop is closed. MEMSTART is loaded only at a cpu edge, so a halt
    freezes it wherever the last microcycle left it; the memory request is
    MEMSTART or MBUSY, so it stands for the whole halt; the bus interface
    runs one cycle and then sits ackn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
    [cadr_microcycle.sv, cadr_park_tb.cpp]
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2026-09-14 the boot button is drawn grey, as the lamps are
    BTN0 is the board's own hardware, like the six lamps beside it, and the
    drawing colours the board's own things grey rather than with a status
    colour: what carries a status is the fabric and the programs behind
    them, not the button. The block takes the lamps' grey and the spoken
    description no longer gives it a status.
2026-09-14 the right-hand column: the boot button written as a lamp row, the Pmods shorter and together
    The BTN0 block reads BTN0 and BOOT on one line at the lamps' own margin
    and baseline, with a small square where a lamp has its dot, since a
    momentary button is not a light; it is one row high and keeps its place
    just above the lamps. The two Pmod connector blocks are shorter, 64
    instead of 84, and sit together as one group with the drawing's small
    gap between them, where before the lower one sat nearer the button than
    its neighbour; a wider gap separates the connectors from the button and
    the lamps, which do not move. The adapter's line to the lower Pmod
    follows its new centre. The button gets a line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
2026-09-14 an init script passes its default only where fpgarc says nothing, and the reader's claims file fails quietly
    The screen and serial scripts passed their own default and then the card's
    line for the same flag, so the board ran `--terminal 0.0.0.0:5900 --terminal
    0.0.0.0:5900`; the last one won and a `ps` listing read as a bug. A script
    now asks the reader whether the file carries the flag and passes its default
    only when it does not; the keyboard mapping beside the card's file likewise.
    The Chaosnet and USB scripts never could pass a flag twice and are unchanged.
    The reader's claims file is opened for append before stderr is redirected,
    so where it could not be created the shell's own compla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
2026-09-14 SW0 holds the machine at power-on, LD4 is ERRHALT, and the debug cable has one connector
    With SW0 on, the fabric comes out of reset with RUN and SRUN clear, so the
    boot PROM never runs and the machine stands as a CADR does when the power
    comes on with nobody at it; any -BOOT source starts it. The switch is read
    at the fabric's reset alone: moving it under a running machine changes
    nothing until the next one. The console's STAT word says whether the switch
    held the machine and where it is now, `cadr-console switch` prints both, and
    the disk pack script holds the machine for the switch or for the fpgarc flag
    and names the cause; `boot` releases either. A first build held RUN alone
    and a hel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
    [cadr_arty.sv, cadr_arty.xdc, cadr_band_axi_harness.sv, cadr_bus_audit_harness.sv, cadr_console.sv, cadr_console_harness.sv, cadr_dbg_pmod_harness.sv, cadr_dbgin_harness.sv]
2026-09-14 the drawing's figures are this build's: the memory-on board with the display in it
    Place-and-routed at the parent commit, DDR=1 HDMI=1: 5,382 of 13,300 slices,
    13,492 of 53,200 lookup tables, 41.5 block RAM tiles unchanged at 29.6 per
    cent, worst slack +0.204 ns of the 10 ns tick met with none of 52,597
    endpoints failing, hold +0.028 ns, 0 critical warnings. The previous figures
    were a build without the display output.
2026-09-14 the JA connector's label sits on two lines
    The one-connector title did not fit the box on one line; the box grows to
    three lines and nothing else in the column moves.
2026-09-14 the switch, the boot button and the lamps have run on the board
    SW0 holds the machine at power-on and BTN0 releases it, LD4 lights red on an
    error halt and clears at the boot button, LD5 is blue while the PROM loads
    the microcode; each step taken one at a time at the board.
2026-09-14 the Cora Z7-07S: the machine fits the small part and closes timing, and the board directory is whole
    A second Zynq board beside the Arty Z7-20: a top level, a pin file, a
    processing-system configuration and a device tree in boards/cora-z7-07s/,
    with nothing in rtl/ changed. Placed and routed at the parent commit with
    the processing system and DDR3 behind the memory port, the same design on
    two parts:
    Cora Z7-07S worst slack +0.495 ns met, 0 of 48,104 failing;
    12,352 of 14,400 LUTs (85.8%), 9,106 registers,
    41.5 of 50 block RAM tiles (83.0%), 4 DSP, 8 exceptions
    Arty Z7-20 +0.236 ns met, 0 of 47,935; 12,130 LUTs (22.8%),
    41.5 of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
    [cadr_cora.sv, cadr_cora.xdc]
2026-09-14 the Arty A7-100: the machine fits an FPGA with no processing system, and the board directory says what a bare FPGA still owes
    A third board directory beside the two Zynq boards: the memory-off machine
    with the probe, the clock from the board's 100 MHz oscillator, the lamps and
    buttons carried over (LD0 MACHRUN, LD1 the fabric clock, LD2 microcycles, LD3
    the disk, the RGB LD4 red on ERRHALT and LD5 blue while -PROMDISABLE; BTN0
    boot, BTN3 fabric reset, SW0 the no-auto-boot hold), and every seam the
    processing system fed tied to what an unplugged cable presents, each naming
    the fabric answer it owes. Nothing under rtl/ changes.
    Placed and routed for xc7a100tcsg324-1 at the parent commit: wor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
2026-09-14 the debug cable on one connector: the carrier's role, the DBGOUT page CC writes, and a CADR debugging a CADR over one Pmod in simulation
    The two-connector carrier is reworked in place into one connector with two
    roles. Eight pads in two groups of four, a strobe and three data lines each
    way, so the link is full duplex with no pin driven from both ends and no
    forwarded clock: the strobe is sampled through two flops in the receiver's own
    domain, and delay is the one thing this cable does not care about, 66 ticks a
    frame against an 11.05 us timeout. Eight beats carry 24 slots: 20 of
    payload, a two-bit frame marker, a parity bit and a zero. A frame failing any
    of the three moves nothing and t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
    [busint_regs.rs, cadr_busint_regs.sv, cadr_busint_regs_tb.cpp, cadr_busint_xbus.sv, cadr_dbg_cable.sv, cadr_dbg_cable_harness.sv, cadr_dbg_cable_tb.cpp, cadr_machine.sv]
2026-09-14 the Arty A7-100 runs the machine: its first 1,024 microcycles agree with muir over JTAG
    The probe bitstream built at the parent commit was programmed by cable serial
    into a chain of one device, and the capture agreed with muir on all 23
    compared columns from microcycle 0. The board is left running the plain
    memory-off bitstream. The README records the run and two hazards it met: a
    DONE check that passes on an already configured part, and a make rule that
    leaves an empty PROM image behind a failed generator.
2026-09-14 one TFTP server serves more than one board: each board's set lives in a directory named as its board directory is
    The Cora's U-Boot fetches cora-z7-07s/uEnv.net and that file names the other
    four files under the same directory; the Arty's does the same under
    arty-z7-20/ once its U-Boot is rebuilt. Every path inside uEnv.net is
    relative to the server's root, so the Arty's card crosses over without a card
    reader: its files go under their directory and the same uEnv.net is copied to
    the root, which the running board follows into the directory at its next
    reset. The staging script checks both ends of the rule, derives the device
    tree's expected model from the board's own source instead of the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
2026-09-14 BTN1 is the fabric reset on every board, and the blue lamp is PROMENABLE, the PROM's own select
    The fabric reset moves to BTN1 on the Arty Z7-20 and the Arty A7-100, where
    the Cora already had it, so every board uses BTN0 for the boot button and
    BTN1 for the fabric reset and nothing else; BTN2 and BTN3 are unused and say
    so. The fabric reset resets the logic in the fabric, the machine, the
    register faces and the lamps, while a processing system and Linux keep
    running and the bitstream stays; on a Zynq board the programs' view of the
    faces is then stale until they are restarted, so SRST is the reset to reach
    for there, and BTN1 exists for the A7, which has no processing system, and
    for unifo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
    [cadr_arty.sv, cadr_arty.xdc, cadr_band_axi_harness.sv, cadr_bus_audit_harness.sv, cadr_console.sv, cadr_console_harness.sv, cadr_console_tb.cpp, cadr_cora.sv]
2026-09-14 the site grows from one drawing to four pages: a front page, one page a board, and the real CADR
    The front page says in a paragraph what the project is and gives each board
    its standing with a link: the Arty Z7-20, every block of whose drawing has
    run on the board; the Cora Z7-07S, which fits the small part, closes timing
    and boots from its own card, with no display output or USB input since the
    board has no HDMI; and the Arty A7-100, a bare FPGA on which the machine runs
    and agrees with muir over the probe, its memory and soft processor in
    progress and no page yet.
    The Arty Z7-20's drawing moves to its own page unchanged but for a crumb
    linking the others and two corrections: two labels in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
2026-09-14 the card mirrors the server, a release image carries the boot partition and an empty bay, and the release script's two faults are fixed
    On the boot partition BOOT.BIN, u-boot.img and uEnv.txt stay at the root,
    the three names the boot ROM, the first stage and U-Boot look for there, and
    the board's bitstream, device tree, kernel and root filesystem move into a
    folder named as the board directory is, the same four names the TFTP server
    holds under the same folder. Each board's U-Boot loads them from that folder
    on the card path as it already fetches them on the network path. The pack
    partition stays flat. The staging script checks both ends of the rule,
    refuses a loader that predates it and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
2026-09-14 the A7 drawing names the UART as the firmware's console and the card as a microSD on Pmod JD
    The UART block no longer claims the CADR's serial line, which on this board is
    a socket in firmware over the network as on the Zynq boards; the card's label
    says Pmod JD; a two-line explanation under it is gone.
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2026-09-14 the CADR page is ten drawings and few words
    The page on the real machine had seven and a half thousand words; it has
    about twelve hundred now and ten drawings in the site's own style, each with a
    one-sentence caption: the whole machine and its cage, the processor's data
    paths with the microcycle as a timing bar, the 48-bit microinstruction in
    MIT's field names, the two-level map, the physical address space, the disk
    and a block on its surface, the display's frame, the I/O board's words and
    lines, the light panel with its ten error lamps and the ICMEM board's digits,
    and the debug cable between two machines. Every figure names the file it was
    read from, and three checks hold the drawings: no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
2026-09-14 a bitstream names its build and the programming script can tell whether the download took; a failed generator leaves no file; the TV document's dead registers and mode bits
    Every bitstream flow sets `BITSTREAM.CONFIG.USERID` to the commit's first
    seven hex digits with a nibble for the tree (clean, modified, untracked,
    both, or unknown), writes a `.stamp` beside the `.bit`, and asserts the
    written file's own header names the value; `USR_ACCESS` carries the same
    word, and nothing reads it back yet. Both `program.tcl`s read the JTAG
    `USERCODE` register before and after programming and require the after value
    to equal what the bitstream's header names, with DONE kept as a second
    condition. On a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
    [cadr_tv.sv, tv.rs]
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2026-09-14 the soft processing system has a clock of its own, and the whole Arty A7-100 meets timing
    `CLKOUT2` of the board's one MMCM gives the soft system 50 MHz
    (`SOC_CLK_DIVIDE = 20`, the one place the number is decided; the Makefile reads
    it out of the file for the check's baud divisor and microsecond). The AXI
    bridge moves to the machine's clock, where the four faces already are, and
    `rtl/plumbing/cadr_soc_cross.sv` carries one request and one answer between
    the two clocks in the memory crossing's four-phase shape, with one difference:
    the answer is held until the fourth phase closes, because the core may ask
    again one clock after being answered. The soft system synchronises its own
    reset and the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
    [cadr_arty_stubs.sv]
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2026-09-14 the boundary between the fabric and the processing system moves up, with the ports on it
    On all three drawings the dashed PL/PS line sat at y=486 with the five AXI
    port boxes on it, 20 above the Linux region and 78 below the fabric's lowest
    row, so it read as the software's lid rather than the fabric's edge. The line
    and the boxes move up by 36: ports at 428 to 466, the line at 450, 42 below
    the fabric and 56 above the region, four above the midpoint of the space they
    divide. The lines that cross the boundary shorten above and lengthen below by
    the same amount; the rail the disk's second leg crosses on is re-centred
    between the blocks and the ports. Everything below the boundary stays where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
2026-09-14 the console's host half lives in its own file, and the firmware links again
    `trace-keys` reads pid files and sends signals, which needs an operating
    system, and it had been put into `console_face.c`, the file the Arty A7-100's
    firmware compiles for an Ibex with picolibc and no operating system. The
    firmware stopped linking, wanting `kill`, `open`, `close`, `read`, `write`,
    `lseek` and `__heap_end`, and the soft-system check and every record aimed at
    it failed behind the missing firmware image. The face file is byte for byte
    what it was before that word arrived; the word's implementation is in
    `console_host.c` with its header, compiled by the console program and its
    check and by nothing else,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
2026-09-14 the Arty A7-100 loses the debug window and puts the cable on Pmod JB
    The debug window is muir's way of playing the cable's far end from software,
    and this board has no muir: its firmware had only ever read the window's
    identifier, and the board's debugger is another board over the cable. With
    `SOC=1` the soft system's bridge no longer has the window: the address range
    falls to the catch-all like any other, the firmware reads it and holds it to
    NONE, and the join in front of the machine's DBGIN end has the Pmod as its
    only master, its window arm tied idle at the top level in every
    configuration. The soft-system check holds the idle arm on every tick: it
    never asks, the holder never names it,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
2026-09-15 the console answers a person bare and a log by name; every program's log is also a file under /var/log, capped
    Every line the console program printed carried `cadr-console:`. The prefix
    exists for the boot log, where five programs write to one console and a line
    has to name its program, and at the prompt it was noise. The rule is muir's
    prompt's: a reply to a person is bare, a line written to a log carries the
    program's name, and the test is whether standard output is a terminal. Two
    things measured on the way: `/dev/console` is a terminal, so the two places
    `S80cadr-disk-packs` lets the console's own lines into the boot log pass
    `--log /dev/console` to keep them named, held by a harness cas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
2026-09-15 a Debugging page: how a CADR is debugged, how the fabric does it, the cable, the frame, and what silicon has shown
    `site/debugging.html`, in every page's top bar after Booting, five drawings
    with short captions and under 1,500 words. One CADR debugging another over
    MIT's twenty-one wires, with the direction of each and what CC does over them,
    read from CC's own source and the connector list. The same cable in the
    fabric: the DBGIN and DBGOUT pages in each machine, the join, muir on the Arm
    cores at the register window, one Pmod connector and the ribbon, the console's
    four words. The cable: both headers pin by pin, the grounds joined, the two
    supply pins crossed in red and marked open, and wh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
2026-09-15 the Arty A7-100's drawing shows only what the board has
    The A7 is a different architecture, not the Arty Z7-20 with parts missing, so
    its drawing stops crossing things off. Seven crossed boxes go, the display
    output, S_AXI_HP3, the HDMI socket, the debug face at M_AXI_GP1's position,
    the USB input program, the USB host controller and its port, with their faded
    lines and the legend's "not available" row. Every block the board does have
    stays where the Arty's drawing puts the same block, so the two pages read side
    by side; the band under the machine holds the bridge and the two direct wires
    into the memory controller and is otherwise empty, because nothing is there.
    Ibex's drop off the firmwar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
2026-09-15 the drawings no longer title themselves
    Each board drawing carried the project's name in its top-left corner, and the
    page's top bar already says it. The text comes off all three.
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2026-09-15 two boards have debugged each other over the cable, and the documents, the drawings and the README say so
    `docs/debug-cable.md` no longer says nothing has been shown on a board. Its
    new section states what two boards have shown: the carrier taking both roles
    over a mirrored ribbon with the wiring found and a forced wrong setting as
    the control; CC in one board's Lisp world halting the machine in the other
    and reading its program counter, instruction register, OB and status against
    that board's own console, and four scratchpad words against its readout, in
    both directions, each read costing the far machine one microcycle; the one
    status bit that differs by CC's own correction for a bit the ha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
    [cadr_dbg_cable.sv]
2026-09-15 an FAQ page: ten questions, each answered from the file that settles it
    site/faq.html joins the top bar after Debugging on every page. Each answer
    is a few sentences read from a tracked document or one of MIT's files, and
    the line under it names the source; a question the material does not settle
    is not on the page, and where the files stop short the answer says so. The
    first question is why there is no disk multiplexor block: MIT's LG684 fans
    one controller's read and write path out to eight drives, and a drive here
    is a file behind a register face, so there is nothing for such a board to
    do. The others cover the reference, the tick, the two clocks that disagree
    with the wall, the stale pic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
2026-09-15 American spelling, the second pass, and no tracked sentence names a file a clone lacks
    acknowledgment and judgment replace the British forms in 237 places, and the
    spellings the first pass left in files other slices then owned are moved in
    the files that have since freed: the Xilinx constraint files and primitive
    wrappers, the console block, the console program's tests and host files, the
    A7's README and firmware, the boards' flow scripts. Ten mutation record names
    and one citation of a record keep theirs, being identifiers.
    The project's working notes are not in the repository, yet 259 tracked
    sentences cited them by name. Where docs/mutations.md states the lesson, the
    sentence now points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
    [busint_regs.rs, busint_xbus.rs, cadr_arty_stubs.sv, cadr_axi_channel_tb.cpp, cadr_axi_widen_tb.cpp, cadr_band_axi_harness.sv, cadr_band_axi_tb.cpp]
2026-09-15 CHUDP as cbridge speaks it: network byte order and the Internet checksum
    A CHUDP datagram now carries every 16-bit word most significant byte first,
    in the header, the data and the trailer, with the data bytes packed into
    words as AIM-628 packs them so that each pair appears swapped on the wire, an
    odd count padded with a zero in the high half, and the trailer's third word
    the Internet checksum, the one's complement of the one's complement sum over
    every word before it. That is what cbridge accepts and sends, and what ozd
    speaks; the framing used until now, words least significant byte first with
    the interface's own check word carried through, could reach neither. The
    fabric keeps its words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
2026-09-15 the pin moves to muir 814822b: every trace identical, the flag and the sync bits no longer hear a restart
    Fifteen commits of muir, six of them changing the model: the CHUDP framing
    this repository already speaks, the display's vertical flag and sync bits no
    longer hearing the sync program start, a refactor of the flag's comparison, an
    American-spelling pass that renames the behavioral clock type, and the
    benchmark's color option. Every one of the fifteen generated artifacts is
    byte-identical against the old muir but the phase generator's trace, whose
    header names the renamed type. The fabric was already right about the flag and
    the sync bits across a restart, so the four generator assertions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
    [cadr_display_out.sv, cadr_tv.sv, color_tv.rs, phase_gen.rs, tv.rs]
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2026-09-15 a refused Chaos frame is offered again, as the cable's abort was answered by a retry
    A burst of CHUDP frames handed to the fabric inside one turn of the program's
    loop put exactly one frame into the machine, whatever the burst's length and
    whatever the machine's service time: the first filled the one-packet buffer
    and every other was refused, counted in the interface's Lost Count and left
    to the sender's retransmission, which on a burst loses the same race every
    time. Measured on the build host against a model of the fabric with the
    machine emptying its buffer after the time microcode 323's receive path
    takes, 716 microseconds for a full packet and 50 for a short one: two frames
    gave one, th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
2026-09-15 the card's Lost Count counts a frame the cable refused, and wraps as the drawings do
    The card's four-bit Lost Count, bits 12:9 of the control and status register,
    was never incremented for a frame the cable turned away. The cable module
    decides whether it can commit a frame before the card ever sees it, so a
    refusal was counted only in the register face's own thirty-two bit tally,
    which the machine cannot read. The microcode's own count of lost frames could
    therefore not move on this hardware however many frames were lost, and a
    program asking the machine what it had missed was told nothing.
    One condition now feeds both counts, so the face's tally and the card's four
    bits cannot drift apa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
    [cadr_arty.sv, cadr_band_axi_harness.sv, cadr_bus_audit_harness.sv, cadr_chaos_cable.sv, cadr_cora.sv, cadr_gp0_split_harness.sv, cadr_gp0_split_tb.cpp, cadr_io_board.sv]
2026-09-15 the display turns the picture, and the line address stops multiplying
    The rotated configurations disagreed with the bitmap by a row everywhere, and
    the module was never wrong. The testbench read the read address AFTER the
    clock edge that consumed it, and the strided arm advances by a source line on
    that very edge, so the slave recorded and then served every band one source
    row too high: row one where row zero was asked for, and a nonexistent row 963
    where row 962 was. The address-walk assertion then complained about a step it
    had itself invented. The contiguous arm hid this for every upright
    configuration because its address is written once a burst and reads the same
    either side of the ed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
    [cadr_arty.sv, cadr_band_axi_harness.sv, cadr_bus_audit_harness.sv, cadr_console.sv, cadr_console_harness.sv, cadr_console_tb.cpp, cadr_cora.sv, cadr_display_out.sv]
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2026-09-16 the net that sounds like the count is the one that aborts
    Our account of how the card separates the frames it counts from the frames it
    aborts had the two nets the wrong way round, in four places. The behavior we
    state is right and the fabric implements it correctly; only the prose
    explaining which wire does which was wrong.
    What the card actually does, read from the wire list and the PROM listing. The
    broad set is `ITS.ME`, made from `DEST MATCH` and the generator clock, and it
    is what clocks the Lost Count's counter. `DEST MATCH` is asserted at the end of
    the destination word in four cases: a match, a destination of zero, a zero that
    is this station's own address, and no match at all with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
    [cadr_chaos_cable.sv, cadr_io_board.sv]
2026-09-16 three of four constraints were dishonest, and the fourth bites
    A third of the paths that fail at a 5 ns tick were reported as held to a
    deadline the machine does not have. Measured against the sources, most of that
    third are not: 1,646 of them end on a clock enable and 1,035 on a reset, and
    only 331 on a data pin. The argument that a destination is not loaded for
    another thirty ticks licenses relaxing the word a register captures. It never
    licenses relaxing the enable that decides when the capture happens. The earlier
    reading applied that rule to one block, quoting this file's own warning about
    enables, and then did not apply it to the rest.
    So of four proposed clauses, one is written as pr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
2026-09-16 the reset network's one witness, which was measured and never compared
    A record landed at `c789d19` to make one claim testable: that the machine's
    reset net may not be given a fifteen-tick relaxation, because what such a
    relaxation permits is precisely a release reaching one module later than
    another. It delays the memory path's reset by a tick and leaves the processor's
    alone. It survived --- nothing saw it --- so the claim it was written to hold
    was not testable, which the record demonstrated by failing rather than by
    arguing.
    The mutation is observable, at 7 ticks of 26,839,746, and every one of the
    seven falls where `CLOCK_EDGE` is low. The processor check compares only at
    clock edges,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
    [cadr_machine_tb.cpp]
2026-09-16 MIT's grid is one number, and a check holds its homes together
    The conversion from MIT's nanoseconds into ticks was written out as `/ 5`
    in module after module and in twenty-one testbenches. It now has one home
    per language, and every instant is derived from it:
    rtl/machine/cadr_tick_pkg.sv TICK_NS and ticks(ns), rounding up
    tb/cadr_tick.h kGridNs and GridTicks(ns)
    golden/src/*.rs one TICK_NS in each of eight generators
    tools/grid_check.py runs as grid.pass and fails, naming the file, when any
    home disagrees or when none can be found. Four negative controls fail with
    their own lines: the package changed, the header changed, one generator
    changed, and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
    [cadr_arty.sv, cadr_band_axi_tb.cpp, cadr_band_tb.cpp, cadr_busint_regs.sv, cadr_busint_regs_tb.cpp, cadr_busint_xbus.sv, cadr_busint_xbus_tb.cpp, cadr_console_tb.cpp]
2026-09-16 the timeout oscillator starts where muir's power-on is, two edges after reset
    Issue #21: every cycle nothing answers was acknowledged two ticks before
    muir's. Read off the oscillator itself on the composed machine, its output
    rose at muir-mapped instants 840 modulo 850, and `NXM TIMEOUT` registered on
    the same edge as the sixth of those rises. So the timer was exact against the
    oscillator and the oscillator was 10 ns early against muir.
    Neither suspect the issue first named was the cause. The timer reads the
    pre-flip `vco` together with `vco_toggle` and both settle on one edge, which
    is not early; counting the edges after the output moves puts every timeout a
    tick late and breaks `busint_xb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
    [cadr_busint_xbus.sv, cadr_busint_xbus_tb.cpp, cadr_color_tv_tb.cpp, cadr_machine_tb.cpp, cadr_memory_path_tb.cpp, cadr_tv_tb.cpp, cadr_unibus_tb.cpp]
2026-09-16 the site is drawn, and the long text lives in docs
    The pages take the manga hand muir's and ozd's sites share: paper panels with
    ink borders, drop-shadow titles, speech bubbles, keyboard-key links, one light
    palette with no dark variant, and a colophon ending every page. The mascot is
    the board ozd drew for this project, copied unchanged from ozd's
    `pages/index.html` at ozd commit b707ecc, and it wears Cold Boot's face and
    arm under CC BY-SA 4.0.
    Each page is cut to its drawings, tables and short captions. The long text
    moves to Markdown in the repository, with every claim, number and file name
    kept: new `docs/cadr.md`, `docs/faq.md` and `docs/license.md`, and one
    paragraph in `docs/board.m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
2026-09-16 the colophon says what muir's says
    The front page ends with a Colophon of muir's shape: its own End header and
    contents entry, then where the material comes from (MIT's, and the machine held
    to muir tick for tick), how it was made (Claude Code, on the two models the
    repository's own commit trailers name), the name, the copyright, and Cold Boot
    credited and linked as muir credits it, with ozd's mascot credit beside it.
    The other pages carry a shorter colophon in the same words, and
    `docs/license.md` links Cold Boot the same way.
    The drawings are byte-identical and the geometric checkers unchanged.
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2026-09-16 the top line is the same on every page, and only the current entry is plain
    Every page opens with one fixed line in one fixed order: muir-fpga, the front
    page, the two boards, booting, debugging, questions and the CADR. Nothing on
    it moves between pages. The entry for the page being read is plain text on the
    spot color with `aria-current="page"`; the other six are links. The spot
    color is a box shadow, so it takes no room and cannot shift the line; measured
    in a browser at 1280 and 390 px, every entry keeps its place and width on all
    seven pages.
    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
2026-09-16 both drawings carry one build's figures, from a clean tree at 962a603
    The two board drawings quoted builds from different commits, and the Cora's
    description still carried figures older than its own labels. Both boards were
    built from a clean tree at 962a603, stamped d3d6a190, and every figure on the
    drawings, their descriptions, the front page's table and `docs/tv.md` now
    comes from those two routed reports:
    Arty Z7-20 (DDR=1 HDMI=1 LMTV=1) +0.476 ns, 0 failing of 54,084, hold
    +0.009; 5,477 of 13,300 slices (41.2%), 45.5 of 140 block RAM tiles
    Cora Z7-07S (DDR=1 LMTV=1) +0.411 ns, 0 failing of 51,155, hold
    +0.033; 4,298 of 4,400 slices (97.7%), 42.5 of 50 block RAM tile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
2026-09-16 MIT's grid is 10 ns: every instant rounds up, and muir's fpga model agrees
    The grid moves from 5 ns to 10 ns, the board's own tick, so the machine runs
    at about 97% of the original's speed where it ran at half. Every triggered
    instant rounds up from its own trigger, offsets after a tap round each then
    add, ILONG taps round the sum, and every free-running oscillator keeps its true
    period in an accumulator. A normal microcycle is 15 ticks, 150 ns, against
    MIT's 145. The references come from muir's `--timing-model fpga`: every
    generator runs muir under it, and `tools/grid_check.py` holds that.
    Instants at 5 ns and now: the read taps 15/23/17/25/20/28/32 become
    8/12/9/13/10/14/16 and the microc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
    [busint_regs.rs, busint_xbus.rs, cadr_bus_audit.sv, cadr_busint_xbus.sv, cadr_busint_xbus_tb.cpp, cadr_color_tv_tb.cpp, cadr_console_bus.sv, cadr_console_state.sv]
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2026-09-17 the console's reset and boot pulses: 640 ns and a 22-tick floor at the 10 ns tick
    RESET_T and BOOT_T count the board's ticks, which are 10 ns, so their 64
    ticks are 640 ns of real time. The comments and the console document still
    said 320 ns (the 5 ns tick's figure), and one parameter comment said 400 ns.
    The floor they are argued from is one generator cycle at extra slow, which is
    22 ticks on the 10 ns grid rather than 44, with the read taps at 8 to 16.
    Comments and prose only; no value changes.
    [cadr_console.sv, cadr_console_tb.cpp]
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2026-09-17 docs/timing.md opens with a short overview: MIT's instants, ours, and what depends on what
    The document is a full table of every instant with its source and constant.
    The overview in front of it groups MIT's instants (the ring, triggered delays,
    free-running oscillators, the disk), lists what the fabric adds (the 10 ns
    grid rounding up, oscillators keeping their period, power-on two edges after
    reset, the few fabric adjustments, the counts that are board ticks), and names
    the nine dependencies that matter most, pointing at the full list.
2026-09-17 docs: every present-tense statement checked against the tree, and the ones the grid, the fixes and the landings made false corrected
    An audit of all 26 documents against the source at 5339086. Twenty-three
    changed, each correction checked against a file and line rather than against
    prose:
    - Figures still on the 5 ns grid:
    - the debug timeout is 1,105 ticks, not 2,210;
    - the disk's hang timer is 256,000,000 ticks;
    - LOST_T is 40.96 us of both machine and real time;
    - a mouse step is 16 us;
    - iob.golden is 41,290,024 ticks over 1,589 cycles;
    - the serial group answers at 210 ns, seven off the grid.
    - Things built since a document said they were not:
    - the mapped Unibus window and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
2026-09-17 the README compares the CADR with this machine part by part, and board.md records the placement fix and the serial store
    The README said the whole machine ran within about 5% of the CADR. That is
    true of the processor's microcycles and the machine's clocks only. It now says
    so, and a table puts the CADR's figures beside this machine's on the Arty
    Z7-20.
    - Rows: the four microcycle speeds, microcycles a real second, the
    microsecond clock, the display frame, the Xbus setup and read deskew, main
    memory's acknowledgment, the disk's rotation, sector, seek, transfer and hang
    timer, the Chaosnet cable and the serial line.
    - Sources: every figure for the CADR cites one, from MIT's drawings, M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
2026-09-17 the HDMI output sleeps after a number of seconds with no USB input, 300 by default, and wakes on the next USB key or mouse event
    The display output block holds the setting, a one-second prescaler and a
    count of seconds. When the count runs out, the three data lanes and the clock
    lane go quiet at the next frame boundary, so the monitor sees no signal and
    enters its own power save while the raster and the frame buffer keep running.
    Zero turns sleep off. A fabric reset wakes the output, restarts the timer and
    puts the setting back to 300.
    The console's page 2 word 36 carries the setting under the key HS and a wake
    as the whole word WAKE, and reads back the setting and whether the output is
    asl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
    [cadr_arty.sv, cadr_console.sv, cadr_console_harness.sv, cadr_console_tb.cpp, cadr_cora.sv, cadr_display_out.sv, cadr_display_out_tb.cpp, cadr_display_sleep_tb.cpp]
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2026-09-19 The Arty's program and probe scripts choose the JTAG board by cable serial, and three stale statements in the documentation are corrected
    Two Digilent boards share one USB hub, and `program.tcl` and `probe.tcl` took
    the first hardware target they found, which could be the other board. Both now
    source `tools/jtag_target.tcl`, which reads JTAG_SERIAL from the environment or
    the board's local.conf, as `ddr_check.tcl` does. It selects the target whose
    name carries that serial, refuses two targets with no serial by naming both,
    refuses a serial that matches nothing, and proceeds with a single target. The
    program and probe checks gain the four cases, which fail on the old scripts,
    and three mutati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
2026-09-19 The DE25-Nano runs the machine on its Agilex 5 fabric, memory off, built by a Quartus batch flow and meeting timing at the 10 ns tick
    `boards/de25-nano/cadr_de25.sv` puts `cadr_machine` on the fabric with every
    processing-system seam tied off as an unplugged cable presents it, and the
    outputs folded so nothing is trimmed. The 100 MHz tick comes from an Altera PLL
    fed by the 50 MHz clock, and the design includes the Reset Release. Both IPs
    are generated at every build from parameters in `build.sh` and are not
    committed. The lamps, keys and switch mirror the Arty Z7-20's, on LEDR0-5,
    KEY0-1 and SW0.
    The flow in `boards/de25-nano/quartus/` builds a project, sources the pin file,
    and runs synth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
    [cadr_de25.sv, cadr_de25_stubs.sv, cadr_microcycle.sv]
2026-09-19 The DE25-Nano's first silicon proof: a JTAG probe the Altera way reads 1,024 microcycles that agree with muir in every column
    The probe's capture buffer moves from `rtl/plumbing/xilinx7/` to
    `rtl/plumbing/`, because only its JTAG access is vendor-specific: the Zynq
    boards keep BSCANE2, and the DE25-Nano reaches the same buffer through an
    Altera Virtual JTAG node (`rtl/plumbing/agilex5/cadr_probe_vjtag.sv`, the IP
    generated at each build). The Vivado flows now skip `rtl/plumbing/<family>/`
    for any family but xilinx7, and the Quartus flow refuses any family directory
    but agilex5. Measured on the Arty: a Vivado synthesis with an unreadable file
    in `agilex5/` reads none of that directory, and th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
    [cadr_arty.sv, cadr_cora.sv, cadr_de25.sv, cadr_de25_stubs.sv, cadr_probe.sv, cadr_probe_harness.sv, cadr_probe_tb.cpp]
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2026-09-20 The DE25-Nano's machine reaches the board's memory on silicon, and its drawing says so
    The counters at the bridge, read in two gate states with the figures written
    down beforehand, give 512 reads and 512 writes asked in all and 256 of each
    answered: the first run of the boot PROM's page-0 parity pass met a shut port
    and was never answered, the second met an open one. Page 0 read back as its
    poison in all 1,024 words, twice and identically. The secure firmware accepted
    the fabric's warm-reset acknowledgment inside its own timeout, which is that
    handshake's first run on silicon.
    The board notes carry the session, what it does not cover, and the ordering it
    exposed: the gate is raised by softw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
2026-09-20 The board drawings carry what the design costs and no longer what one build's timing was
    Under each fabric label the two usage rows stay, with their bars and their
    percentages, because utilization answers whether the machine fits a part, which
    is about its shape. The worst-slack and failing-endpoint lines come off all
    three boards: they are one build's figures, they move with placement, and the
    clock the design runs at is already stated in the clock block. Each page's own
    sentences end on the usage rather than trailing into the numbers that are gone,
    and the comment recording which commit the usage came from stays.
    The DE25-Nano's figures are the build with the register faces: 15,028 ALMs,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
2026-09-20 The DE25-Nano's Ethernet receives once the PHY keeps its own clock delay
    The board's tree gave the interface the plain RGMII mode, beside a comment
    claiming the printed board carries the clock delays. It does not, on the
    receive side. In that mode the kernel's driver for this PHY writes the pad
    skews that cancel the part's built-in 1.2 ns receive delay, leaving the
    receive path with no delay at all, so the receiver samples the data at the
    instant it changes and never starts a frame. That is what the board showed:
    the interface negotiated a gigabit and transmitted, and received nothing,
    with every receive error counter also at zero. A receiver that breaks the
    frames it starts counts errors; o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
2026-09-20 A register face answers whether or not the machine's memory port is live
    On the DE25-Nano one face alone carried the memory port's liveness into its
    own reset, and a face held in reset here does not stall a read: it swallows
    it. Its address-ready line is high throughout reset, so the bridge's address
    is taken and no beat is ever returned, and because the address was never
    latched, opening the port later cannot complete the read. Both processor
    cores then wait forever. No guard in a program can catch this, since the
    fabric answers every question a guard knows how to ask and then fails at the
    one read the guard does not make.
    It was also worse than one page. A single unanswerable read wedges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
    [cadr_arty.sv, cadr_cora.sv, cadr_de25.sv, cadr_disk_harness.sv, cadr_disk_pack.sv, cadr_gp0_split_harness.sv, cadr_gp0_split_tb.cpp, cadr_pack_axi_harness.sv]
2026-09-20 A card says what date and time the board starts with
    No board here presents a real-time clock to Linux. There is no such device
    in any of these trees and none in the hardware keeping time while the power
    is off, so a board that boots from its card alone comes up at the epoch and
    stays wrong until something tells it otherwise. Everything that reads a clock
    is then wrong together: the file server's answers, the dates on files the
    machine writes, and every line in a log.
    The card's file of flags gains two lines for it. The date is eight digits,
    a four-digit year then the month then the day. The time is the hour on a
    24-hour clock from 00 to 23, then the minute, and the second if it is given.
    E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
2026-09-20 A clock flag sets the field it names and nothing else
    As first built, the card's two clock lines were composed onto the restored
    clock and the result was then weighed against that clock, with the later of
    the two winning. Two things were wrong with it. A value the operator had
    written on the card was silently dropped whenever the saved clock happened to
    be later, which is a setting somebody asked for and did not get. And a lone
    time flag was taken to mean that time today, which is a date the board
    invented: no board here keeps a clock while the power is off, so it has no
    today to refer to.
    Each flag is now explicit and sets only the field it names. The saved clock is
    restored so that the bo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
2026-09-20 A knife-edge check measures its aim instead of predicting it
    The check that holds two serial-line defects aimed a stimulus at a single
    tick, and it aimed by prediction. It located one arrival by reading a register
    back, which itself takes several ticks, so the anchor was already wrong; then
    it predicted every later arrival from that anchor and aimed each take by
    issuing an ordinary read a few ticks early. The bus delays an address by a
    random nought to two ticks. So the aim walked one tick a frame while the take
    walked one tick a frame plus a jitter of two, and a walk like that can step
    straight over the one tick it is hunting.
    It did, and the measurement is stark. In the whole simulation e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
    [cadr_gp0_split_harness.sv, cadr_gp0_split_tb.cpp]
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2026-09-20 The DE25-Nano's display leaves through its transmitter
    On the other boards the fabric drives the video signals itself. Here they
    leave through a transmitter on the board, which takes a parallel raster and
    does nothing at all until it is configured over its own two-wire bus. So the
    raster was already right: the display module ends at exactly the signals that
    transmitter wants, and the same module, the same three modes, the same
    rotations and the same sleep now serve both kinds of board. The programs
    beside the machine needed no change whatever.
    What was missing was the display on the shared memory port's third master, a
    pixel clock, the video pins, the transmitter's own configuration, and a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
    [cadr_adv7513.sv, cadr_adv7513_tb.cpp, cadr_de25.sv, cadr_de25_stubs.sv, cadr_display_out.sv]
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2026-09-20 A band runs on the DE25-Nano, and five blocks turn green
    The machine booted the release band off its own card for the first time on
    this board. The disk side served 42,170 blocks and wrote 20,493 back with
    nothing denied, nothing refused and no failures, and the boot read the same
    three blocks in the same order the other boards read. The shipped boot path
    ran through with nothing typed, which had never happened here: the loader
    read the card, Linux came up, all five programs started from the card's own
    file of flags, the drive came present and the machine ran.
    The write-backs were checked rather than counted. The expectation was written
    first: twenty thousand write-backs must change the pac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
2026-09-20 A card for this board can be staged again
    Moving the fabric's fetch into the branch that uses it repaired a boot that
    looped, and broke the making of a card entirely. The card script still asked
    the old arrangement for the image, so the real loader refused it three times
    in a row and no card for this board could be staged at all. Nothing caught
    it, because no check stages a card; it was found by making one.
    Three things are repaired together.
    The fetch is now asked of whichever variable actually fetches the image, which
    differs by board. On the boards whose loader fetches everything in one command
    nothing changes at all.
    A card can say that the fabric was configured before the loader ran.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
2026-09-21 The keyboard ties the connector to the machine, and three blocks turn green
    A key pressed on the board's own keyboard appears on the monitor, and the
    mouse moves the pointer there. That is the reading the rest of this rests on,
    and it is worth saying why it is better than the picture that came before it.
    A picture somebody recognizes can be a frame that stopped arriving minutes
    earlier, or a recognition loose enough to fit more than one thing. A character
    that appears when a key is pressed and at no other time can be neither, and it
    runs the whole path in one direction: the key into the input card, the machine
    painting its own memory, the display reading that memory and the transmitter
    sendi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
2026-09-21 The kernel stops dying on a flash controller it may not touch
    The flash controller is shared between the processor and the device manager,
    and the manager owns it at every power-up. The processor gets it only by
    asking over the manager's mailbox, and the fabric image decides whether the
    answer is yes, through a setting the assembler writes into that image. So the
    processor can find itself holding a controller it may not touch, and the
    driver's first register read then takes an external abort: measured here as a
    synchronous abort that kills init, and on the boot after it an asynchronous
    error at the same two functions that panics the kernel.
    That is what this board does when it comes up from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
2026-09-21 A release is three zips, one a board, on one partition
    A card was made by writing a whole disk image over it, which meant a tool that
    destroys the wrong disk when the device name is wrong, and two partitions the
    user never asked for. That goes. A release is now three archives, one for each
    board, unpacked onto a card the user formatted themselves.
    The card's layout says what each part is for without a document. The few files
    the loader demands by name stay at the root, with the two files of settings a
    person edits, the board's own description and the file the board writes to
    remember the time. A folder named for the board holds what the loader reads.
    Separate folders hold the disk packs, th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
2026-09-21 The debug cable reaches the DE25-Nano's header
    The window behind the cable already answered on this board; what was missing
    was the adapter onto the header, which the board's own notes called a later
    slice. It is on JP1 pins 31 to 38, with ground on pin 30, read off the board
    manual's own figure and checked against the pin file and against the package's
    reference project, which agree line for line.
    Every signal is paired with a neighboring pin driven low as a guard, and the
    supplies are left open at both ends. On this header that arrangement is not
    the same geometric statement it is on the other boards -- there a pair lies
    along one row, here the odd and even pins are the two rows, so a pai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
    [cadr_de25.sv]
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2026-09-21 The debug cable's timing cuts reach the pads they name
    Both cuts on the connector's eight pads named them with a bracket range. The
    fitter reads a bracket in a collection pattern as a bus index rather than a
    range, so the collection was empty and both cuts were silently ignored. The
    fitter said so in its own warnings, which is not a place anybody looks.
    That is the same shape that once left the other board at nine and a half
    nanoseconds short on 596 endpoints, and the assertion written after that
    occasion is what caught it. This is the first time that assertion has paid for
    itself.
    **The deeper fault was that the check kept its own copy of the pattern.** A
    build whose cuts reached nothing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
2026-09-21 The last sentence describing the retired scale is gone
    One drawing's comment still said a board drawing colors a block by how far
    along it is. It was corrected in the source days ago, but the regeneration
    that would have carried it into the page failed silently and the page kept
    the old words. The generator was looking for the old sentence to find that
    comment, so changing the sentence was what broke it.
    Nothing else on any page moves. The generator reproduces all eight byte for
    byte again, which is the check that would have caught this at the time if its
    output had not been thrown away.
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2026-09-21 The Zynq boards report lookup tables, and both still fit
    The figures published for those two boards were a fit from five days and
    twenty-four commits ago, six of them touching logic those boards build. The
    smaller of the two was published at seventy-two slices of headroom, so the
    site may well have been claiming a fit that no longer existed. Both were built
    again at this commit and **both still place, route and close**: the larger with
    0.313 ns of slack on fifty-four thousand endpoints, the smaller with 0.203 on
    fifty-one thousand, neither with a failing path.
    The smaller board's numbers moved in both directions at once, which is worth
    recording. Its logic grew, from 13,376 lookup tables to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
2026-09-21 One video mode, and the two screens side by side
    Changing the video mode needed a new bitstream, because the pixel clock is a
    generated block and the raster's numbers are parameters, so the deadline the
    fitter works to changes with the mode. A mode nobody can select without the
    tools is not a mode, so there is one now and the other three are gone, with
    nothing left behind: no parameter with a single legal value, no dead branch,
    no sentence saying "currently". The cost is one sentence of fact rather than a
    caveat: this is a 5:4 mode, and a display that will not take 5:4 will not take
    this output.
    The two screens no longer sit one on top of the other. Both were centered on
    the same point, and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
    [cadr_arty.sv, cadr_console.sv, cadr_console_harness.sv, cadr_cora.sv, cadr_de25.sv, cadr_display_out.sv, cadr_display_out_tb.cpp, cadr_gp1_split_harness.sv]
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2026-09-21 The documents describe the board the DE25-Nano now is
    Its README opened by telling a stranger that the machine is built without its
    memory, that there is no processor configuration, no device tree and no image,
    and that the top level is the Arty Z7-20's memory-off board on this part. All
    of that stopped being true over the last several slices, and the same file
    contradicted itself further down. The lede now says what the directory holds,
    what each build knob adds, what silicon has shown, and what it has not: the
    serial line has carried nothing here and the debug cable's connector has
    crossed nothing.
    The same correction runs through the tree. boards/README.md described the
    board in four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
    [cadr_de25.sv]
2026-09-21 The site describes one video mode and two screens side by side
    The board drawings still said the two screens were centered with the color
    one over the first, and still offered a choice of three video modes. Both
    labels are now what the fabric does: side by side with the color board on top
    where they meet, and 1280 by 1024 at 60 hertz. The Arty Z7-20's spoken
    description follows, including the rotation's 137 shared columns, and it no
    longer says the console reports which mode the fabric is, because the console
    no longer has a word for it.
    The front page kept the 1920 by 1080 measurement and dropped the offer. That
    build existed, a monitor showed it once, and it left nine picoseconds of ro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
2026-09-21 A write crosses the ribbon, and the guarded carrier carries the debugger
    Every reading the debug cable had carried was a read. A read that goes wrong
    gives a wrong answer and a comparison catches it; a write that goes wrong
    changes the far machine and nothing compares it afterwards, so the direction
    that had never been exercised was the one that needed a check built for it.
    MD was written into the far machine over the ribbon and read back on the far
    board's own console, which reaches that register through the console face on
    its own general-purpose port and never through the cable that wrote. The two
    halves written are complements, so neither can be mistaken for the other or
    for anything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
2026-09-21 Two rows of the cable table say yes, and the sentence above them is exact
    The table's two remaining unrun tests have run. The guarded carrier row says
    what crossed it: all sixteen diagnostic registers at one halt, each equal to
    the far board's own console, and the machine stepped and started over it. The
    write row names the value the far board's own console read and says no
    microcycle was spent.
    The sentence above the table needed more care than the rows. It said that
    what had not crossed either carrier was a write, which is no longer true, and
    it credited CC with crossing the ribbon without saying which carrier, which
    now matters: CC the program ran on the earlier carrier of three data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
2026-09-21 Every published figure is of one clean commit, and the DE25's was too small
    The three boards' resource figures each named a different commit, all of them
    before the display placement changed, and the DE25-Nano's understated the part
    by 192 adaptive logic modules. Understating is the direction that misleads,
    because it makes a part look emptier than it is.
    All three boards are fitted again from one clean worktree at this commit, with
    muir at the pin beside it, and each bitstream's stamp names the commit and
    says the tree is clean. The Arty Z7-20 takes 14,569 lookup tables and 46
    block RAM tiles, the Cora Z7-07S 13,478 and 43, and the DE25-Nano 16,268
    adaptive logic modules and 135 M20K blo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
2026-09-22 The flash holds the first phase, and the fabric's design stays on the card
    The board README described the maker's reference design, which merges the
    first-stage loader into the whole fabric image and writes one file to the QSPI
    flash, and then concluded that the fabric's image and the loader are one file
    here. That is true of the reference design and not of this project, which
    splits the build in two: the phase-1 bitstream to the flash, and the fabric's
    own design to the card as `cadr.core.rbf`. The same file's table of boot
    arrangements said so 440 lines further down, so the document contradicted
    itself and the sentence a reader meets first was the wrong one.
    It now says what each phase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
2026-09-22 The fourth spoken description says read-write, and one synonym goes
    Three of the four boot drawings had their spoken descriptions corrected to say
    the card is mounted read-write. The fourth said only "mounts the card", with
    no read-only in it to catch the correction, so it was left saying less than
    its own drawn label already said. All four match now.
    And the front page's own voice called the machine muir's model in programmable
    logic, sixteen lines above the same page saying it is synthesized into the
    fabric of an FPGA. The page's title, its eyebrow and its lede all say fabric,
    so the bubble now does too.
    The two Zynq drawings keep the phrase, deliberately. There it is one half of
    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
2026-09-22 The line over the front page's title is the one the two projects share
    The masthead said the machine was in FPGA fabric above the title and rebuilt
    in an FPGA below it, so the agreed line was in the wrong slot and the same
    sentence appeared twice with two endings. The line that pairs with the
    sibling project's own now sits over the title, where a masthead's tagline is
    read.
    The lede under the title stops repeating it and says what the site holds
    instead, which is what its own page description has always said: what runs on
    each of the boards, and what the real machine was.
2026-09-22 The DE25-Nano boots over TFTP, and the path is no longer only drawn
    The board's network boot path was built, drawn and never run. It has now run
    twice: once driven by hand from the loader's prompt with the card untouched,
    and once by itself after the card was made to name a server. Five files and
    48,691,884 bytes came over the network, the fabric was configured from a file
    fetched moments earlier, and the machine came up on its band.
    The path never falls back to the card, so a card naming a server the board
    cannot reach is a board that loops at the loader. The way back was therefore
    established before the card was touched rather than after: the three-second
    window before the loader's own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
2026-09-22 Both DE25-Nano boot drawings carry that board's measured figures
    The TFTP drawing was made while that path had never run, so it said so in four
    places and deliberately carried no measured byte count and no measured time
    where its three neighbours carry one. The path has since run on the board,
    and the drawing now carries what was measured: the boot command, the fabric's
    image and the kernel with their sizes, and a time axis from the reset to the
    login prompt.
    The card-path drawing gains a time axis too. It had byte counts and no times,
    and the same session measured both paths with one logger in one sitting, so
    the pair can now be read against each other: the network boot reaches a login
    p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
2026-09-23 Stopping waits for each program, and the memory map is checked across its copies
    An init script's stop sent SIGTERM and went straight on to save the clock
    and unmount the card while the disk pack program was still writing its
    dirty slots back, and a failed unmount was hidden. A shared helper,
    cadr-common's stop.sh, now waits for the program within a bound (thirty
    seconds for the pack program, five for the others), says so when it is
    still running, and the unmount reports a failure. All six init scripts
    use it, and the flag-file test holds the order.
    On the DE25-Nano, cadr_fabric_loaded=0 counted as set, because U-Boot's
    test was -n. Only the value 1 now skips the load, and the boot check
    ev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
2026-09-23 Chaosnet keeps the frame it is streaming, and a late memory answer is dropped
    The Chaosnet cable read the receive length live while a frame streamed
    into the card, so the next give's length, or a discard, landing in that
    window cut the frame short or ran it over. The length is now latched at
    the commit. A commit with a length of zero or above 256 is ignored rather
    than counted as a lost frame, and a take counts only for the frame whose
    length Linux read, so a frame that arrives behind a Clear Transmitter is
    not dropped unsent.
    When the NXM timer ended a bus cycle the memory had not answered, the AXI
    adapter went on waiting, and the late answer then acknowledged the next
    cycle: a read got th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
    [cadr_axi_master.sv, cadr_chaos_cable.sv, cadr_chaos_cable_tb.cpp, cadr_xbus_axi_harness.sv, cadr_xbus_axi_tb.cpp, cadr_xbus_ddr.sv]
2026-09-23 The fabric's reset never breaks a transaction the processor started
    BTN1 on the Zynq boards, KEY1 on the DE25-Nano and the clock generator
    losing lock all reset the splitters and faces the processing system talks
    to. While held they took an address and never answered it, and a read in
    flight when the reset landed was dropped, so both Arm cores hung. On the
    DE25-Nano the same reset put the FPGA-to-SDRAM port into reset at once
    while the bridge still owed it answers, so every later machine read got
    the previous read's word.
    Each AXI port now has two resets. The processor's own port reset is the
    only one that reaches AXI protocol state. A new fabric_rst input resets
    the faces' registers as bef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
    [cadr_arty.sv, cadr_board_reset_harness.sv, cadr_board_reset_tb.cpp, cadr_chaos_cable.sv, cadr_console.sv, cadr_console_harness.sv, cadr_cora.sv, cadr_dbg_pmod_harness.sv]
2026-09-23 The DE25-Nano's plumbing is simulated, and its display keeps reads in flight
    Twenty-one of twenty-seven faults planted in the DE25-Nano's plumbing were
    caught by nothing: its top level was only linted, and the f2sdram check
    compared the machine's traffic alone. The top level is now simulated
    after its lints, around stubs of the processor and the memory, and holds
    the memory gate's two bits, KEY0, SW0 and KEY1, the lamps, the display's
    timing and colors, the transmitter's writes at sleep and wake, and the
    edge the pixel clock is gated on. The f2sdram check compares the pack
    side's and the display's data, burst lengths and error answers against
    its own expectations, answers some addresses with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
    [cadr_adv7513.sv, cadr_adv7513_tb.cpp, cadr_de25_sim_stubs.sv, cadr_de25_top_tb.cpp, cadr_display_out.sv, cadr_display_out_tb.cpp, cadr_display_share_harness.sv, cadr_f2sdram_harness.sv]
2026-09-23 BTN1 finishes the Zynq boards' memory and display transactions too
    On the Arty and the Cora the machine's memory adapter on S_AXI_HP0 was
    reset by BTN1 at once, and so was the display's fetch on S_AXI_HP3, which
    could cut a transaction the processing system still held. The adapter now
    takes only its port's reset: the machine drops its request in reset and
    the adapter finishes to idle. The display takes the same split as the
    faces: BTN1 resets its settings, and its fetch finishes the job in hand
    and starts no new one, while only the port's own reset resets its AXI
    state.
    board_reset now holds a read on HP0 and on HP3, and a write on HP0,
    across BTN1, and fails without the change.
    Co-Authore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
    [cadr_arty.sv, cadr_arty_stubs.sv, cadr_board_reset_harness.sv, cadr_board_reset_tb.cpp, cadr_cora.sv, cadr_de25.sv, cadr_display_out.sv, cadr_display_share_harness.sv]
2026-09-23 The DE25-Nano opens its memory gate only once the bridges read released
    U-Boot's `bridge enable` returns zero whatever happens, so its `&&` could
    not keep the memory gate shut when a bridge stayed in reset. Both branches
    of cadr_fabric now read the reset manager's BRGMODRST after it and open the
    gate only when the three bridges this board uses read released. Measured at
    the board's U-Boot prompt: the register read 0xf before anything, still 0xf
    after `fpga load` reported success, 0 after `bridge enable` and 0xf after
    `bridge disable`, and the masked read and its test took the right branch
    both ways. The same measurement corrects the earlier claim that the secure
    firmware releases the bridges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
2026-09-23 A repeated flag takes its last line, and ozd starts as its own user
    A flag given more than once on a board's fpgarc was taken from its first
    line with no word said, and the ozd script wrote its peer file from the
    first --ozd-chaos-address while handing ozd every line. Every reader now
    takes the last line of a single-valued flag, keeps every line of the four
    flags meant to repeat, hands a program only the line it uses, and prints
    one warning naming the flag and every line it is on. ozd's address and the
    peer file now come from the same line. A card whose last line had no
    newline lost that line under dash and bash; it no longer does.
    The ozd script ran ozd's --check as root before dropping to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
2026-09-23 A fault bitstream blinks every lamp when the card's configuration is wrong
    Each board gains a small top level with no machine in it, loaded when the
    fabric image the card names cannot be loaded. Every lamp blinks together,
    a quarter second on and off, red on the RGB lamps of the Arty and the Cora
    and all eight on the DE25-Nano, so a fault is visible across the room on a
    board with no screen. Every processor window is still answered, with the
    word FALT, so Linux keeps running, and nothing masters memory. The build
    stamp carries a fault mark that the programming scripts and cadr-console
    name, and the init scripts start nothing that touches the fabric and say
    on the console that the fault bitst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
    [cadr_arty_fault.sv, cadr_cora_fault.sv, cadr_de25_fault.sv, cadr_fault_harness.sv, cadr_fault_lamp.sv, cadr_fault_tb.cpp]
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2026-09-23 muir is pinned at 5552bb5, and the fabric follows its CADR corrections
    The pin moves from e0ba08f to 5552bb5. Three of muir's changes in between
    correct the CADR's rtl against the netlist, and the processor follows them.
    MEMSTART, MBUSY and READ IN PROGRESS are clocked by the master clock, so a
    bus cycle prepared while the processor's clock is held starts at the next
    master clock edge: a read stepped from the console lands before the next
    step. ILONG, STATBIT and USE.MD are gated by NOPA rather than NOP, so the
    trap cycle is long and counted when the instruction asks. A store that
    writes both map levels writes level 2 with its level-1 bits zero and its
    low bits from MAPI. The Chaosnet board'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
    [cadr_map_access_tb.cpp, cadr_microcycle.sv, cadr_park_tb.cpp, cadr_sstep_tb.cpp, sstep.rs]
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2026-09-24 muir is pinned at 22c8a52, and a hung cycle's writes keep their time
    The pin moves from 5552bb5 to 22c8a52, and the fabric follows muir's
    corrections, measured against the board's netlist. A cycle held by -WAIT
    fires no write pulse, so a late write lands once. The scratchpads, the maps
    and the dispatch memory are written as the pulse ends, so the instruction
    that writes a RAM reads its old word, on the CADR as on QUUX. A bus cycle
    started at an edge takes the VMA and the MD being loaded at that edge. No
    reference trace moved; a new check, dispatch_write_order, runs muir's
    programs for these corners on the whole machine, where the fabric as it
    stood differed in eleven of them.
    Taking writes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
    [cadr_dbgin_tb.cpp, cadr_dispatch_write_order_tb.cpp, cadr_md_compose_tb.cpp, cadr_microcycle.sv, cadr_phase_gen.sv, cadr_spy_registers.sv, dispatch_write_order.rs]
2026-09-24 The mutation runner caches its compiles and runs the slowest records first
    A profile of the runner put a fifth of a run into recompiling Verilator's
    own runtime for every mutant, and another fifth into compiling models and
    testbenches that the mutation had not changed. Every mutant's C++ build now
    goes through ccache, keyed on the text compiled, so every mutant is still
    built, linked and run and no stale object can stand in for a changed one.
    The known holes run first, then the rest in order of their check's
    baseline time, which shortens the tail. On a subset of 84 records covering
    every check, the run took 26% less wall time with the same verdict,
    failure line and missed checks for every re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
2026-09-24 QUUX runs a microcycle of four ticks, 40 ns, on both boards
    QUUX drops the CADR's delay-line timing for a fixed microcycle of K ticks
    of 10 ns, as muir's sync timing model defines it. A QUUX-only phase
    generator counts K ticks, or K plus L under ILONG, and QUUX's writes land
    at the edge, its control store is read from the next address at the edge
    with the word being written passed straight through, and every stall is a
    cycle in which the clock runs and the processor's state is not enabled. The
    divider takes a DIV's word a tick after its strobe. The QUUX goldens are
    generated under sync timing, and new QUUX programs reach what the old ones
    could not at this speed, among them a control store w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
    [cadr_arty.sv, cadr_busint_xbus.sv, cadr_de25.sv, cadr_de25_sim_stubs.sv, cadr_dispatch_write_order_tb.cpp, cadr_machine.sv, cadr_machine_tb.cpp]
2026-09-25 QUUX gains its clocks, register page, input, block-disk and no Unibus
    muir is pinned at 8598fbd, and QUUX follows it to revision 6 without the
    Unibus. The processor's clocks are QUUX's own: a 60 Hz tick, an interval
    timer and a free-running microsecond counter in source 15, and the tick's
    flag is latched at the edge that ends each executed microcycle, as the
    board's CLK3C does, which trials with the rise inside a microcycle showed
    the fabric had taken a microcycle late. The QUUX register page at 17377000
    carries interrupt status, error status and error stop; the keyboard's
    FIFO and the mouse live on it, and so does the Chaosnet interface, whose
    request reaches the interrupt directly. The boo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
    [cadr_busint_regs.sv, cadr_console_harness.sv, cadr_dbg_cable_harness.sv, cadr_dbg_pmod_harness.sv, cadr_dbgin_harness.sv, cadr_dispatch_write_order_tb.cpp, cadr_gp0_split_harness.sv, cadr_gp1_split_harness.sv]
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2026-09-25 A QUUX machine is checkpointed in muir's format, from the fabric
    cadr-checkpoint --machine quux writes muir's format 39 for a QUUX machine:
    its geometry, the 16K PDL and the 2,048-entry level 2, the clocks and
    timers, the input queue and mouse, block-disk, MONO TV, the bus errors,
    and the sync timing. The readout reaches the new state through register
    entries 21 to 25 and a new register-page selector, with the clocks taken
    at one instant while they run. A QUUX file built from a known state is
    the same, byte for byte, as muir's own for that state, and muir loads it,
    saves it back identically and resumes. The program asks the fabric which
    machine it is and refuses a mismatch either way. What t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
    [cadr_machine.sv, cadr_memory_path.sv, cadr_microcycle.sv, quux_block_disk.sv, quux_checkpoint.rs, quux_clocks.sv, quux_feature_page.sv, quux_input.sv]
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2026-09-25 QUUX's device registers answer on the memory bus, and a DIV waits for its operands
    muir is pinned at fd9dd32, and QUUX follows its Q7. There is no device bus:
    the processor's register decode reaches MONO TV's, block-disk's and the
    register page's registers, memory-mapped and never cached, and a register
    access takes two microcycles. An empty address fails in the microcycle
    that takes it, with the NXM bit and no timer, so the 80 ns setup, the
    deskew and the timeout oscillator are gone from QUUX, and with them the
    QUUX adapter's relaxed clause. The frame buffer is memory-bus traffic
    through the cache; scanout still reads DDR, and a written word reaches it
    once the write buffer drains. The trac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
    [cadr_ddr_map.sv, cadr_machine.sv, cadr_machine_tb.cpp, cadr_memory_path.sv, cadr_microcycle.sv, cadr_xbus_ddr.sv, quux_checkpoint.rs, quux_feature_page.sv]
2026-09-25 muir is pinned at 7bb5ff4: QUUX boots the GPT PROM, and the bus reset resets the devices
    The pin moves to 7bb5ff4, where QUUX's boot PROM is the one that finds
    its microcode through the disk's GPT and saves nothing; the fabric's QUUX
    PROM image matches it word for word. No CADR trace moved, and QUUX's boot
    agrees up to the new PROM code and through it.
    PROG.UNIBUS.RESET now resets the devices on both machines, as muir's bus
    reset does: the display boards, the disk controller on the CADR and
    block-disk on QUUX, and the I/O board, with the interrupt line held off in
    the resetting microcycle. The fabric had tied those resets to power-on
    only. A new program leaves each device with something the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
    [cadr_console_harness.sv, cadr_dbgin_harness.sv, cadr_machine.sv, cadr_memory_path.sv, cadr_microcycle.sv, quux.rs, quux_feature_page.sv]
2026-09-25 The CADR's Unibus acknowledgments come at muir's instants
    A new program reads every I/O board register, writes each one that can
    be written, and touches an address nothing takes and one nothing
    answers, in four passes. Before this change 68 of its 120
    acknowledgments were off muir's, and 4 microcycle lengths were wrong.
    Now all 120 are at muir's instants and all 3000 microcycles agree.
    The I/O board and the bus interface's register block raised -UB SSYN on
    the edge at its instant, so the interface saw it a tick late. Both now
    raise it on the edge before, as the spy registers already did. The card
    still lands a write, and holds a read word, on the edge at the instant.
    A Unibus cycle nothing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
    [cadr_busint_regs.sv, cadr_busint_regs_tb.cpp, cadr_busint_xbus.sv, cadr_dbg_cable_harness.sv, cadr_io_board.sv, cadr_io_board_tb.cpp, cadr_machine.sv, cadr_memory_path.sv]
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2026-09-26 Q9 on the fabric: the RTC, the file device and quux-file-device; and the PDL written where it is read
    The RTC and the file device follow muir at b1e710c (muir.commit): the
    device registers, the DMA face, and quux-file-device, the boards' server
    for sys/, site/ and home/. make check passes for CADR and QUUX; the
    mutation run catches 1223 of 1225 records, the 2 known holes aside.
    A Vivado fault placed the PDL buffer's write at its read address. Both
    flows now check every RAM whose read and write share an address against
    the RTL (rams_check.tcl, Vivado after synthesis, Quartus after synthesis
    and after the fit), and refuse the three broken builds kept as proof. New
    record quux-the-pdl-write-la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
    [cadr_arty.sv, cadr_band_axi_harness.sv, cadr_bus_audit_harness.sv, cadr_cora.sv, cadr_de25.sv, cadr_de25_sim_stubs.sv, cadr_f2sdram_harness.sv, cadr_gp0_split.sv]
2026-09-27 Q11 on the fabric: revision 10, three interval timers and reset devices; muir pinned at 947926e with Q10's executables
    The tick and Q1's interval timer give way to three interval timers on the
    register page, words 110-115 (on, flag, mode at turn-on, interrupt enable,
    a period in microseconds), their flags at word 100 <0>, <1> and <7>;
    destination 3 stays as timer 0's control, destination 4 writes only M and
    source 17 reads all ones. Word 104 <0> resets devices: on QUUX bus_init is
    the reset or reset devices, and <28> resets nothing and holds nothing off.
    A page read takes the flags as they stood at its edge, as muir does.
    Feature word 16 reads 3, MACHINE-ID says revision 10, readout entries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
    [cadr_console_harness.sv, cadr_dbgin_harness.sv, cadr_machine.sv, cadr_microcycle.sv, quux.rs, quux_checkpoint.rs, quux_clocks.sv]
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2026-09-27 muir is pinned at 94c8142: a register write held behind a register read waits for MD as the fabric does
    muir 94c8142 no longer delays a register read's MD when a register write is
    acknowledged behind it, so muir and the fabric agree at 80 ns. shared_edge's
    held-edge loop now puts the page's word 105 behind the read, the case it
    had avoided. Only quux_clocks.quux.k4's golden moved: each of the loop's 25
    turns is 160 ns shorter.
    [quux.rs]
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2026-09-27 Destination 3 no longer controls timer 0; the checkpoint is version 46
    QUUX revision 10 as Q11 was amended: destination 3 writes only M, and
    the timers are set up through the register page alone. The goldens test
    that destination 3 leaves timer 0 as it was; four mutation records hold
    it. The bit at word 104 is named RESET-DEVICES throughout.
    cadr-checkpoint writes version 46, as muir reads. muir pinned at
    bbc47f3. docs/fits.md records the fits: the Arty Z7-20's QUUX fit misses
    by 13 ps on the memory start path, which the next commit addresses.
    [cadr_console_harness.sv, cadr_dbgin_harness.sv, cadr_machine.sv, cadr_microcycle.sv, machine_axis.rs, prom.rs, quux.rs]
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2026-09-29 G2 F2a: revision 13's processor (WORD_BITS=40 with MACHINE=quux)
    Behind WORD_BITS > 32, as contract G2's appendix A1 fixes the bits:
    BYTE words decode no misc function; the rotator and masker work on a
    ring of 40, LC byte mode adds 0/24 or 0/32/24/16; M<A compares the
    fields, A=M all 40 bits; conditions 10 (fixnum overflow, a new flag, in
    the readout's flag word bit 35) and 11 (unsigned less than); D-MEM at
    4,096; LC at 30 bits with its flags at <37:34>; the map at 8,192 x 7 and
    4,096 x 28 with 1024-word pages, the <31:28> gate and the new MAP(MD)
    layout; the fused return's rotate 34 and delta <39:34>; MACHINE-ID
    revision 13. WORD_BITS=40 builds revision 13 through the Makefile, both
    board t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
    [cadr_arty.sv, cadr_de25.sv, cadr_de25_sim_stubs.sv, cadr_machine.sv, cadr_machine_tb.cpp, cadr_microcycle.sv, dispatch_write_order.rs, quux13.rs]
2026-09-30 G2 F2b: revision 13's memory port and cache
    At WORD_BITS=40: a 28-bit physical space on the cables with 40-bit
    words; the cache in 8-word lines; main memory in packed storage, 5 bytes
    a word (the frame buffer window at 4); the prefetch reaching across the
    page; 5-beat lines and 5-byte strobed writes on the AXI side, a line or
    a word that crosses 4 KiB split into two bursts issued back to back.
    Revision 13's DDR base is the parameter QUUX13_MAIN_BASE.
    New goldens: quux13_port (the port against muir's MemoryPort at
    QUUX_13, with DDR held as G1's bytes), xbus_decode.quux13 (every
    address at three board counts), quux13_axi_master, whole-machine
    programs space, lines and fused, and the block-RAM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
    [cadr_arty.sv, cadr_band_axi_harness.sv, cadr_bus_audit_harness.sv, cadr_cora.sv, cadr_de25.sv, cadr_de25_sim_stubs.sv, cadr_f2sdram_harness.sv, cadr_f2sdram_port.sv]
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2026-10-01 The display flags and console words say display, not HDMI
    --hdmi-output, --hdmi-rotate and --hdmi-sleep are now --display-output,
    --display-rotate and --display-sleep, and cadr-console's hdmi-output,
    hdmi-rotate and hdmi-sleep are display-output, display-rotate and
    display-sleep, with replies starting display:, on every board, since a
    board's monitor output need not be HDMI. There are no aliases: an old flag
    in fpgarc is not passed on and the boot log names its replacement; an old
    console word is refused, names the new one, writes nothing and exits 2.
    The fabric is unchanged; only comments in three RTL files follow.
    [cadr_console.sv, cadr_console_tb.cpp, cadr_cora.sv, cadr_display_out.sv]
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2026-10-01 Kria KR260: the CADR runs its system; release and fault bitstream (K5)
    On the KR260 the CADR boots System 1001 from its pack, LISPM-4 at 177204,
    saved as "MIT Lisp Machine Four, with associated machine OZ": Chaosnet to
    ozd on the board, the date and time from fpgarc, the boot chord, the
    60 Hz tick at 60.4985/s, 31 minutes with the control store matching the
    pack in every dump and the disk losing nothing, and a board checkpoint
    that muir-sim opens at the same microcycle with the same memory and
    screen. cadr_kr260_fault.sv is the KR260's fault bitstream, which Linux
    reports when the machine's bitstream is missing; make release builds the
    KR260's zip; the card's README speaks for each board; th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
    [cadr_fault_harness.sv, cadr_fault_tb.cpp, cadr_kr260_fault.sv, cadr_ps8_sim.sv]
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2026-10-02 muir-sim pin a6fa3b3; each QUUX revision builds in its own boot PROM
    muir-sim's quux_boot_prom() is now PROM 2001, revision 13's, so with the
    new pin revision 12's traces and bitstreams would have carried the wrong
    PROM. The golden machine takes muir's PROM 2000 for revision 12 by name,
    prom.rs --word-bits 40 writes PROM 2001 as boot_prom.quux13.hex, and the
    Arty and DE25 flows choose the image by WORD_BITS, the Arty's naming it
    as it builds and the DE25's reading it back from the synthesis report.
    prom_revisions.pass pins both images by digest; a planted swap either way
    fails it. Every other golden and PROM image is unchanged by the pin.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
    [machine_axis.rs, prom.rs]
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2026-10-03 QUUX's memory master finishes a write split at 4 KiB; checkpoints bind a VHD disk
    A 5-byte word at bytes 4095 to 4099 crosses a 4 KiB boundary, so the
    master writes it as two bursts, and it took no write response until both
    addresses were out; the DE25-Nano's shared memory port takes no second
    write address until the first write is answered, so each waited on the
    other and PROM 2001 hung on the disk after four blocks. The master now
    takes the first burst's response while the second address waits. Its
    testbench keeps the shared port's rule for half its run, which failed
    with a transaction that never finished, and now passes with 751 split
    writes under the rule.
    cadr-checkpoint declared a QUU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
    [quux13_axi_master_tb.cpp]
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2026-10-03 kria-kr260: a single screen centred; the KR260's display fits
    On the Kria KR260 a CADR screen shown alone, the first display or the
    color board, upright or turned, is centred in the 1920x1080 frame: under
    SPREAD its first column is one of two constants, chosen by the display
    setting latched each frame. Both screens keep the equal margins. The
    Arty Z7-20 and the DE25-Nano are unchanged. The testbench holds every
    placement; it fails on the previous RTL in 35 cases. Seven mutation
    records.
    buildroot-kr260-rebuild forced uboot-reconfigure, which the KR260 does
    not build: the rebuild now forces U-Boot only when BR2_TARGET_UBOOT is
    selected and the kernel only when BR2_LINUX_KERNEL is. br_force (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
    [cadr_display_out.sv, cadr_display_out_tb.cpp]
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2026-10-04 color TV: the map shown as 377 minus the stored value
    MIT's WRITE-COLOR-MAP stores 377 minus each component of the color it
    is asked for, and the color board's output inverts it again; muir shows
    it so. The fabric's display output (HDMI on the Arty Z7-20 and the
    DE25-Nano, DisplayPort on the Kria KR260) and cadr-terminal showed the
    stored value, so every color appeared as its complement and a
    background asked as black showed white. Both now show 377 minus the
    stored value; the stored map, which the console and checkpoints read,
    is unchanged.
    Tests: the display testbench compares every color pixel with the
    inverted value, and a new configuration holds entry 0 stored 377,377,377
    black and ent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
    [cadr_de25_top_tb.cpp, cadr_display_out.sv, cadr_display_out_tb.cpp]
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2026-10-04 quux: revision 12's checks ported to revision 13
    Every revision 12 check that was the only test of RTL both revisions
    share has a revision 13 counterpart, so revision 12 can retire without
    taking that coverage with it: the RTC, the clocks and tick windows, the
    clock waits, divide and multiply, the file device, the prefetch, the
    PDL and I-memory syncs, memory edges, start-start, the fused return,
    the operand fill, the bus reset, the register page, page faults, the
    video controller and the feature page, 19 programs as quux13_<name>.
    The golden generator's quux --revision 13 reassembles them for revision
    13: the A1 fields, 40-bit constants, the map at 1024-word pages, the
    register page at 17777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
    [cadr_dispatch_write_order_tb.cpp, cadr_machine_tb.cpp, dispatch_write_order.rs, fused.rs, quux.rs, quux_readout_window_tb.cpp]
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2026-10-06 QUUX revision 14 in the fabric: TLB, walk, write-back, windows, redirect, LC, checkpoint
    quux_tlb.sv is the TLB, one true dual-port memory in NO_CHANGE mode;
    quux_mmu.sv walks the two-level page table through the cache, writes
    the accessed and modified bits back under the guard, decodes the device
    and physical memory windows, redirects the PDL buffer's words with its
    snoop, sets the ephemeral-reference bit, runs the WRITE-MAP operations,
    answers register-page words 220-224 and sweeps the TLB at reset. A
    walk's read waits for the acknowledgment of the cycle in flight and
    never shares the cache's side seam with a write-back; a monitor fails
    if the two meet. LC is 34 bits with its adder, condit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
    [cadr_console_harness.sv, cadr_dbgin_harness.sv, cadr_machine.sv, cadr_machine_tb.cpp, cadr_memory_path.sv, cadr_microcycle.sv, cadr_xbus_decode.sv, quux14.rs]
2026-10-07 QUUX revision 14 on the boards' flows, and timing patterns that name real cells
    The Arty, Kria and DE25 tops carry REVISION and TLB_ENTRIES, the 29-bit
    bus address and, on the Arty and Kria, SYNC_K14; revision 14 is built
    only when named, into its own build directories, with PROM 2002's image
    pinned by digest. The TLB takes block RAM on the Arty, UltraRAM on the
    Kria and M20K on the DE25, with its clauses, a one-tick clause into both
    ports' addresses, and checks that each took. tools/grid_check.py now
    elaborates revision 14 and fails when one of its every-tick registers
    falls in the relaxed set, or when an MMU or TLB register has no class:
    on the previous commit all 38 MMU tick registers and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
    [cadr_arty.sv, cadr_de25.sv, cadr_de25_sim_stubs.sv, cadr_kr260.sv, prom.rs]
2026-10-07 Revision 14: TLB read at the edge, the side seam registered, wall clocks at any tick
    The TLB is read at each generator cycle's edge from VMA's and MD's next
    values, written on the ticks between and forwarded across the edge, as
    the contract's A14.4-5 have it; F1 read it a tick after the edge. The
    side seam's answer, the write-back's grant and the redirect's PDL
    port and write come from registers, so no one-tick path starts at a
    live answer. muir sees nothing change: every revision-14 golden is tick
    for tick at K=4 and K=5; the golden program forward and PDL-buffer
    cases in redirect are new, and muir agrees with them.
    The DE25-Nano's side-seam clause binds through rtl/plumbing/
    quux_keep_net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
    [cadr_arty.sv, cadr_console_harness.sv, cadr_dbgin_harness.sv, cadr_machine.sv, cadr_memory_path.sv, cadr_microcycle.sv, quux14.rs]
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2026-10-07 Revision 13's PDL buffer infers on Quartus again; the check synthesizes every DE25 machine
    The redirect's registers in the PDL buffer's address, data and output
    muxes, constant at revision 13 only through their enables, made Quartus
    build revision 13's buffer from registers, which do not fit the
    DE25-Nano: revision 13 stopped at synthesis since the redirect's
    registering. The parameter now folds them away at revision 13, which
    elaborates as before; revision 14's logic is unchanged. build.sh stops
    after synthesis and its checks under DE25_SYN_ONLY=1, and
    build/de25_syn.pass in make check synthesizes the CADR and QUUX
    revisions 13 and 14 where Quartus is configured; on the previous commit
    it f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
    [cadr_microcycle.sv]
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2026-10-08 Revision 14: goldens for the side read past memory, port B's fill forward and its MD match
    noentry's directory base is now the first frame past main memory, so its
    walk reads main memory's first word past the end and s_virt_q is held. A
    new program, mdmove, moves MD within a walk's hold, so port B looks up
    again: the pending fill's forward decides the hit at K = 4 behind two
    writes and at K = 5 behind one, and the MD match on the walked entry is
    held on both its paths. mdmove runs at K = 4 and 5, under the
    read-during-write poison, and at the boards' latency. Each corner,
    broken, failed no check before and fails 3 to 5 now; four mutation
    records hold them.
    docs/checkpoint.md states the boun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
    [quux14.rs]
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2026-10-08 Revision 15's core: the straight line, held to the pipeline clock for clock
    rtl/machine/quux15_core.sv is revision 15's stages CS, RD, EX and WB as
    muir's pipeline runs them: ALU and BYTE words with the d1, d2 and d3
    bypasses, the PDL buffer with its forwards and wait, MUL in 5 clocks and
    DIV in 18, the OA registers with SL, SH, the hold and OA-OUTSIDE-FIELDS,
    an unconditional jump resolved in RD and a dispatch that falls through as
    predicted; a word needing what is not built stops a simulation, named.
    quux15_exec.sv is revision 14's 40-bit datapath as functions of a word
    and its operands, quux15_store.sv the 64-bit store with the PROM, and
    quux15_ram.sv the RAMs, poisoned in simulation wher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
    [quux15.rs, quux15_core.sv, quux15_core_tb.cpp, quux15_exec.sv, quux15_ram.sv, quux15_replay.sv, quux15_store.sv]
2026-10-08 Revision 15's core: transfers and speculation
    quux15_core.sv gains muir's front end: the redirect and its squash,
    restore and refetch, N's squash of the delay slot, the micro stack and
    RD's copies of it, of the PDL registers and of LC, conditional jumps by
    their hint, dispatches by their predicted target, the guard, WRITE-I-MEM
    written at WB with its refetch's wait and the store's forward, the PDL
    address field and PDL-FIELD-MISMATCH. Every dispatch loads the dispatch
    constant. The RAMs take no write in reset.
    Traces carry their memories as # image lines, loaded into one core
    build, and may hold many runs: quux15_preset.rs ports muir's speculation
    matrix (532 runs) and programs at random (2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
    [quux15.rs, quux15_core.sv, quux15_core_tb.cpp, quux15_preset.rs, quux15_ram.sv, quux15_store.sv]
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2026-10-08 muir pin to abfcef1: no trace moves; WRITE-I-MEM in MIT's form and in execution order
    muir-sim abfcef1 refetches the word after a WRITE-I-MEM with N, goes on
    after one in a delay slot at the jump's target, and halts on a
    WRITE-I-MEM outside MIT's form when its checks are on. 291 of the 293
    traces and PROM images are byte for byte as at 8b2c57a; imem's two,
    which wrote with INVERT and without N, are no longer made.
    imem's two WRITE-I-MEMs are now in MIT's form (IR<9:0> 1647); its rows
    are unchanged. A new group, imemorder, at 10 and 8.5 ns: a write to the
    next word, which runs through the store's forward; a write two ahead; a
    write in a delay slot to another word and to the jump's target, bo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
    [quux15.rs, quux15_core.sv, quux15_preset.rs]
2026-10-08 Revision 15's core: devices and time
    quux15_devices.sv gives the core time at the trace's period, through a
    period input: the microsecond clock (source 15), the real-time clock
    (word 103) and word 25, each a count and its remainder, so nothing
    drifts. The timers 110-115 run periodic on the start's grid or one-shot,
    with the period written while on and the interrupt enables; word 100
    and RESET-DEVICES (word 104). The interrupt for conditions 5 and 6,
    including a register write taken in the same clock, is computed from
    registers, outside EX's loop. Device words are read a clock after the
    grant, at that clock's instant. Block-disk's registers without a pack;
    the frame-buffer window through the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
    [quux15.rs, quux15_core.sv, quux15_core_tb.cpp, quux15_devices.rs, quux15_devices.sv, quux15_memside.rs, quux15_port.sv, quux15_preset.rs]
2026-10-08 Revision 15's core restructured for timing, no clock moved
    RD's plan is made three ways, from the registered copies, for a squashed
    slot and after a redirect, and EX's outcome only selects among them at
    the end; NPC's address, CS's PDL copies and RD's free signal no longer
    run through the plan after a redirect. A simulation check compared the
    new plan, hold and CS copies with the single plan on every clock of all
    58 goldens, and a planted fault in the copies made it fire.
    The cache's and the TLB's valid bits are in quux15_validmap.sv, 64
    LUT-RAM columns and a register bit for each group of 64, cleared in one
    clock and keeping the installs and TLB loads made after it, as muir does.
    The RAMs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
    [quux15_core.sv, quux15_core_tb.cpp, quux15_memside.rs, quux15_mmu.sv, quux15_port.sv, quux15_ram.sv, quux15_store.sv, quux15_tdp.sv]
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2026-10-08 Revision 15's console: halt, step, debug IR, spy, reset and boot
    - The diagnostic registers through the core's spy bus: the debug IR's four
    halves, its extension through strobe 6 and its alias 14, clock control,
    OPC control and the mode register written; IR, OPC, PC, FLAG-1, FLAG-2 and
    STAT read as muir's spy_15 gives them.
    - RUN cleared drains the machine to a single-edge machine's state between
    two microcycles: CS and RD squashed and fetched again in order, EX and WB
    done, the port idle; the last microcycle's PDL buffer write held over the
    next word's read; a write's word fixed by the halt when no word behind it
    will. STEP runs one word, IDEBUG the debug IR's word in its plac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
    [quux15.rs, quux15_console.rs, quux15_core.sv, quux15_core_tb.cpp, quux15_devices.sv, quux15_mmu.sv, quux15_port.sv, quux15_preset.rs]
2026-10-08 Revision 15's halts: a write fixed by the halt with MD changed since its start
    The halts trace gains a halt at every clock of a program in which
    MD-START-WRITE is a read start's successor: it waits in EX for the read,
    leaves the read's word in MD, and writes M 31, so the return behind it
    waits in RD under the guard while it is in EX and WB. A halt in its first
    clock in WB finds EX empty and fixes the write's word as the write is
    granted, with MD as it stands, the read's word, not the word the start left;
    a read after the resume shows which word was written. These runs are held
    to muir's pipeline alone: unhalted, the pipeline writes the successor's own
    MD and micro the read's.
    Mutation recor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
    [quux15_console.rs]
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2026-10-08 muir pin to a05df00: a revision-15 write carries its start's own MD
    muir a05df00 takes two changes to revision 15 (A15b.3, A15b.5): the word
    right after a read start reads MD as the start found it, and a write it
    starts carries the read's word; and a write carries MD as its start's own
    microcycle leaves it, so the write's word is no longer fixed by the
    microcycle after the start.
    The core:
    - A write's word, MD as its start's microcycle leaves it (md_final, the
    read's word right after a read start), goes with the start to WB and into
    the port's queue entry at the grant, where the line's write is made with
    its tag answer pending a clock.
    - The pending-write, granted-write and halt-held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
    [quux15.rs, quux15_console.rs, quux15_core.sv, quux15_memside.rs, quux15_port.sv]
2026-10-08 Revision 15's core: a write's word is MD at its grant
    The port's queue entry, a register's write and the walker take MD as it
    stands at a write's grant, in place of a copy kept from EX's commit: nothing
    moves MD while WB holds a write start, a start waiting in EX while a read is
    on its way and WB holding EX until its starts are granted, so the two are
    one word. 40 flip-flops go.
    A simulation assertion holds the core to it: MD at a write's grant equals
    MD as its start's microcycle left it. It never fires over every quux15 trace
    on both bubble counts, and a write start planted to stop waiting for a read
    on its way fires it.
    Mutation records: rule (A)'s record moves to the successor's MD, and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
    [quux15_core.sv]
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2026-10-10 Revision 15's main loop: MACRO-DISPATCH and the fused return, D off
    - MACRO-DISPATCH's register, index and entries (destinations 5-7): the
    register keeps <31>, <30> (D's enable) and <28:0>; every control-store
    write clears the enable; -RESET clears it and drops an armed operand.
    - The copies of A-LOCALP and M-AP, fourteen bits, following the writes at
    the addresses the register names; the PDL address field on them, RD
    forming the index early unless a word in EX or WB writes the base, EX
    reading a write of the base the word in WB lands now.
    - The fused return on M 31 (A15.2, A15b.16): RD decides it when no fetch is
    due, from M 31's register and its own LC copy, and EX makes it, fr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
    [quux15.rs, quux15_console.rs, quux15_core.sv, quux15_core_tb.cpp, quux15_main.rs, quux15_preset.rs]
2026-10-10 Revision 15 on the Kria KR260, and the board's checkpoint of it
    boards/kria-kr260/quux15_kr260.sv, quux15_kr260.xdc, vivado/quux15_bitstream.tcl,
    vivado/quux15_ram.xdc: revision 15's top level on the KR260. The pipelined
    core's 64-bit master on HP0, main memory packed at revision 13's base, its
    console face on HPM1, the MMCM at the period in whole nanoseconds. It fits at
    17 ns: WNS +0.536 ns, WHS +0.013 ns, 24,927 LUTs, 8,690 flip-flops, 34 block
    RAM tiles, 14 UltraRAMs, measured on a draft whose face also held the
    machine in reset at power-on, a register more. At 13 ns it misses by 3.106
    ns, on port B's TLB read through EX's decision to the PDL buffer's write
    enable.
    rtl/plumbing/quux15_fa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
    [prom.rs, quux15.rs, quux15_console.rs, quux15_core.sv, quux15_core_tb.cpp, quux15_devices.sv, quux15_face_tb.cpp, quux15_kr260.sv]
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
